ZacCac/MoXY-3D-Printer/Code/images/belt_dimensions.jpg

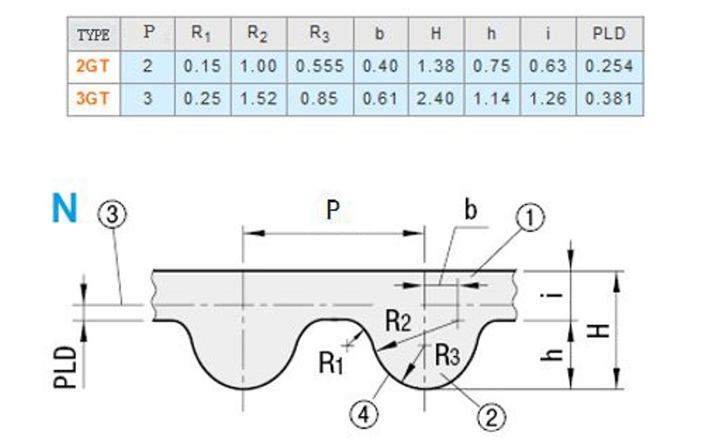
Code/images/belt_dimensions.jpg
