ZacCac/MoXY-3D-Printer/CAD/Components/Printhead/PRT_Main_Plate_V5.SLDPRT

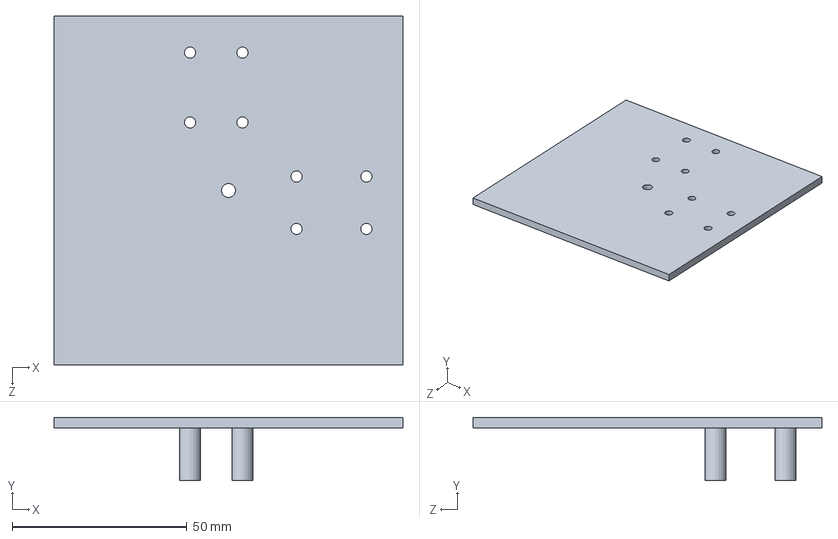
[picture p3: CAD file, 2024-11-04]
CAD/Components/Printhead/PRT_Main_Plate_V5.SLDPRT
100.0 x 18.1 x 100.0 mm
