ZacCac/MoXY-3D-Printer/CAD/Components/Bed/ASM_Bearing_Block_V1.SLDASM

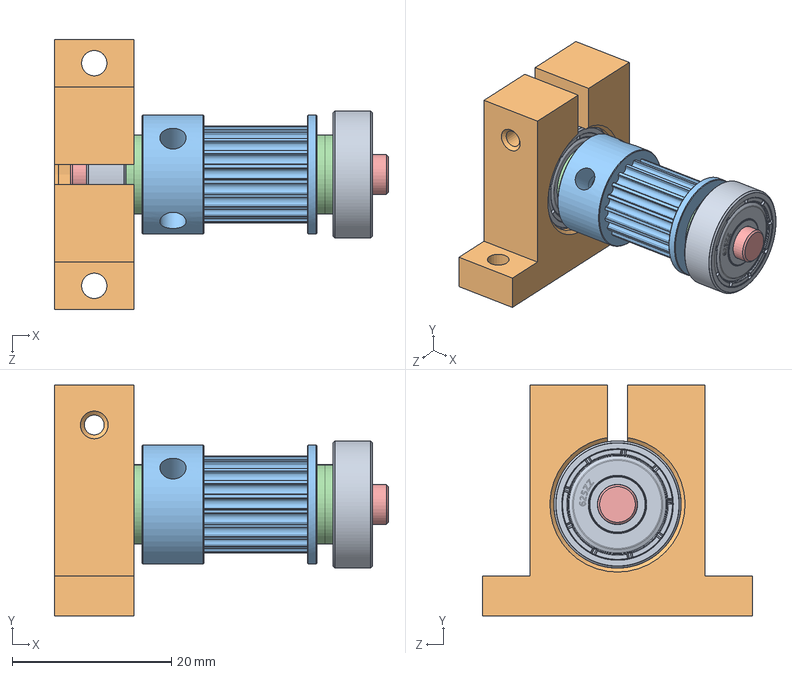
[picture p4: CAD file, 2024-12-02]
CAD/Components/Bed/ASM_Bearing_Block_V1.SLDASM
42.0 x 29.0 x 34.0 mm
PRT_625ZZ_Bearing x 2
PRT_Worm_Bearing_Block_Mirror_V1
PRT_Gates_2GT_20T_Toothed_Pulley_12mm
PRT_M5_1mm_Washer x 4
PRT_5x40mm_Shaft
