ZacCac/MoXY-3D-Printer/CAD/Assemblies/ASM_Gantry_V4.SLDASM

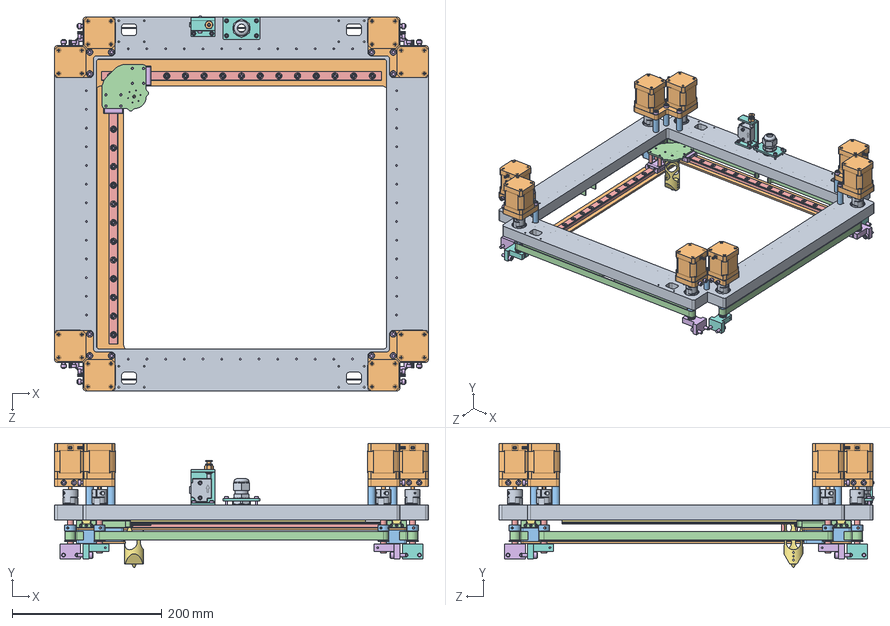
[picture p5: CAD file, 2024-06-27]
CAD/Assemblies/ASM_Gantry_V4.SLDASM
500.3 x 165.9 x 501.5 mm
PRT_Gantry_Main_Plate_V5
PRT_XY_Backer_V2 x 2
PRT_temp_backer_spacer x 4
PRT_MGN12H_Carriage x 4
PRT_MGN12H_Rail_375mm x 2
socket head cap screw_am x 178
PRT_MGN12H_Rail x 4
PRT_PG11_Mount_V1
PRT_PG11_Gland
PRT_NEMA17_17HS19-2004S1 x 8
PRT_Gates_2GT_20T_Toothed_Pulley_12mm_8mm-Bore x 8
PRT_XY_Belt_Path_V1 x 4
PRT_8x65mm_Shaft x 8
PRT_Bearing_Block_Needle_V1 x 4
PRT_5905K73_Needle-Roller Bearing_8mm x 16
PRT_Bearing_Block_Needle_Mirror_V1 x 4
PRT_CPJC20-BL-5-8 x 8
PRT_Motor_Mount_V2 x 4
PRT_M5x25_Standoff_V1 x 12
PRT_Main_Plate_DK_V1
PRT_M3x18_Standoff_V1 x 4
PRT_MGN12C_Carriage x 2
PRT_Chube_Integration
PRT_Filament_Sensor_Plate_V1
PRT_Filament_Sensor_1.75mm
PRT_PC4-M10
PRT_M3_1mm_Washer x 4
