ZacCac/MoXY-3D-Printer/CAD/Assemblies/ASM_Temp_Printhead_V1.SLDASM

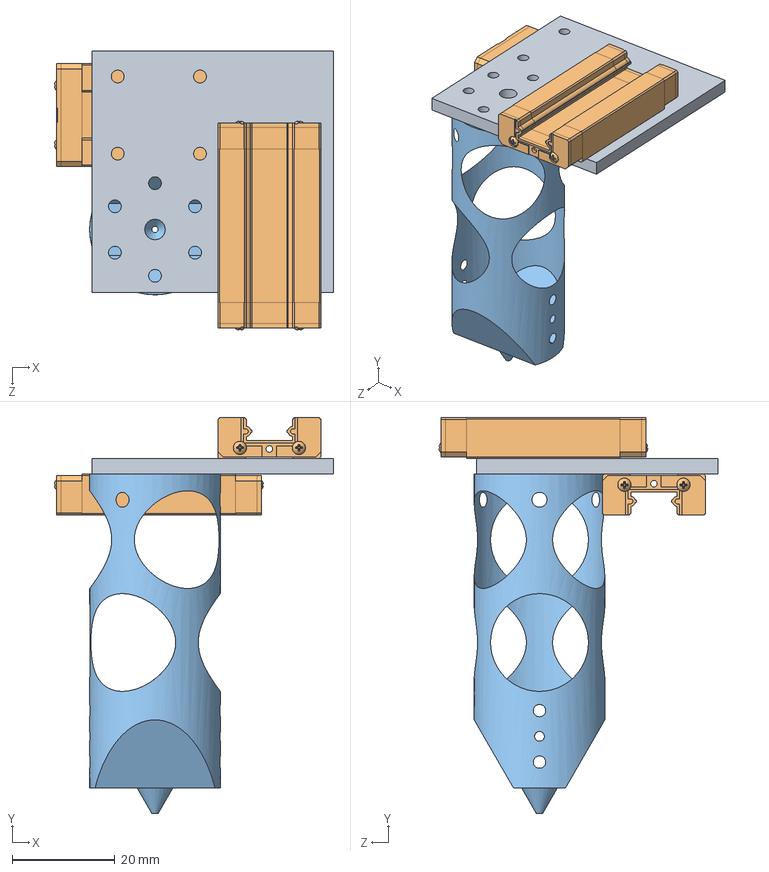
[picture p6: CAD file, 2024-06-27]
CAD/Assemblies/ASM_Temp_Printhead_V1.SLDASM
54.3 x 77.0 x 54.3 mm
PRT_Temp_Printhead_Plate_V1
PRT_MGN9H_Carriage x 2
PRT_Chube_Integration
