ZacCac/MoXY-3D-Printer/CAD/Hardware/Linear Rails/ASM_MGN12H.SLDASM

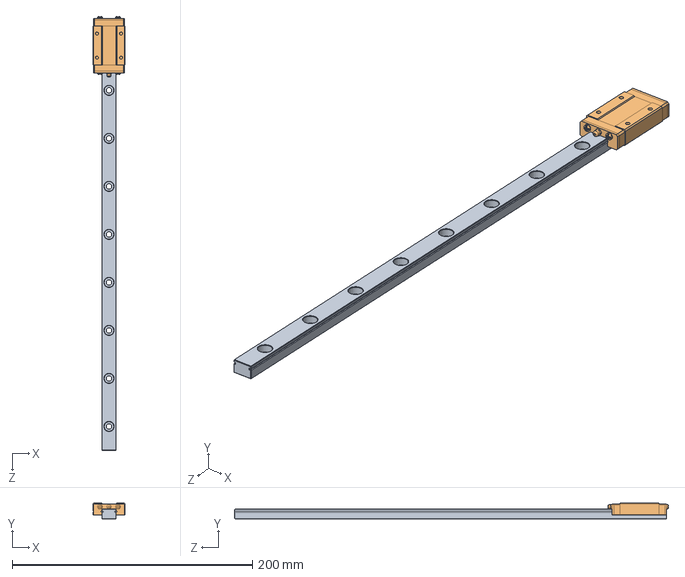
[picture p7: CAD file, 2024-05-26]
CAD/Hardware/Linear Rails/ASM_MGN12H.SLDASM
27.0 x 13.0 x 361.5 mm
PRT_MGN12H_Rail
PRT_MGN12H_Carriage
