ZacCac/MoXY-3D-Printer/CAD/Electronics/Connectors/PRT_Z_Assembly_Aviator_Mount_V1.SLDPRT

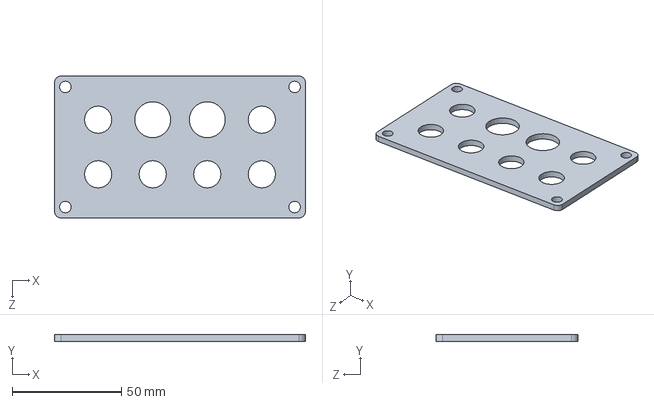
[picture p8: CAD file, 2024-12-02]
CAD/Electronics/Connectors/PRT_Z_Assembly_Aviator_Mount_V1.SLDPRT
115.0 x 3.00 x 65.0 mm
