ZacCac/MoXY-3D-Printer/CAD/Assemblies/ASM_Z_Worm_Drive_Mirror_V1.SLDASM

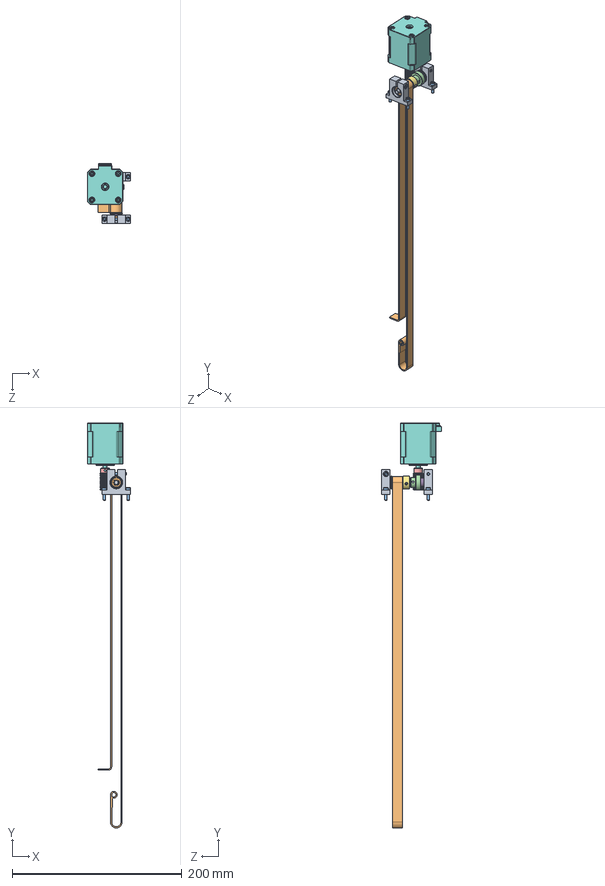
[picture p9: CAD file, 2024-06-21]
CAD/Assemblies/ASM_Z_Worm_Drive_Mirror_V1.SLDASM
51.2 x 476.9 x 70.2 mm
PRT_Worm_Bearing_Block_V1 x 2
PRT_625ZZ_Bearing x 2
socket head cap screw_am x 6
PRT_Kyouiku_Gear_G80A20
PRT_Kyouiku_Gear_W80SUR1
PRT_M5_1mm_Washer x 7
PRT_Gates_2GT_20T_Toothed_Pulley_12mm
PRT_LDO-42STH48-2504AC
PRT_5x60mm_Shaft
PRT_Z_Belt_Path_V2
