ZacCac/MoXY-3D-Printer/CAD/Assemblies/ASM_Z_Worm_Drive_V1.SLDASM

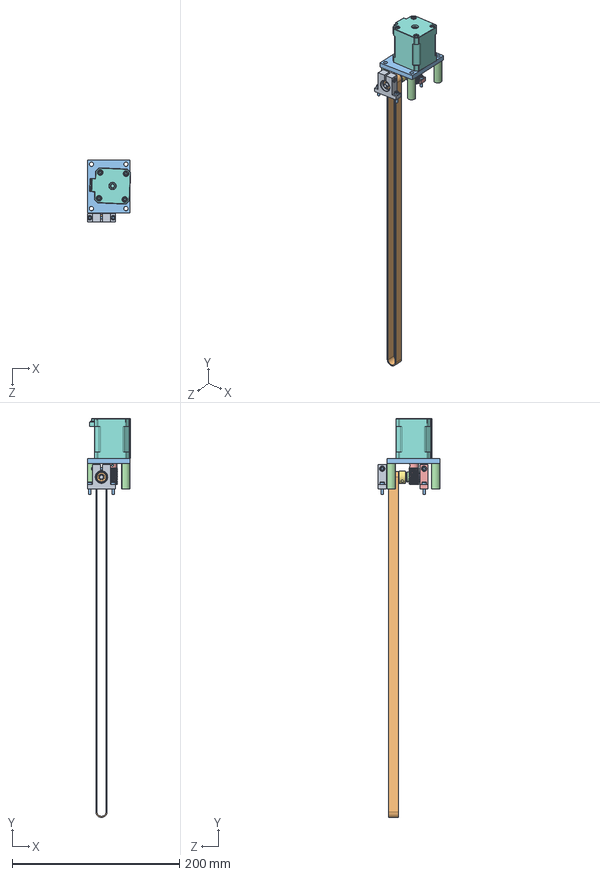
[picture p10: CAD file, 2024-06-21]
CAD/Assemblies/ASM_Z_Worm_Drive_V1.SLDASM
51.9 x 476.7 x 74.0 mm
PRT_Worm_Bearing_Block_V1
PRT_625ZZ_Bearing x 2
socket head cap screw_am x 6
PRT_Kyouiku_Gear_G80A20
PRT_Kyouiku_Gear_W80SUR1
PRT_M5_1mm_Washer x 7
PRT_Gates_2GT_20T_Toothed_Pulley_12mm
PRT_LDO-42STH48-2504AC
PRT_5x60mm_Shaft
PRT_Z_Belt_Path_V1
PRT_Z_Stepper_Plate_V1
PRT_Temp_Z_Spacer x 4
PRT_Worm_Bearing_Block_Mirror_V1
