ZacCac/MoXY-3D-Printer/CAD/Assemblies/ASM_Z_V1.SLDASM

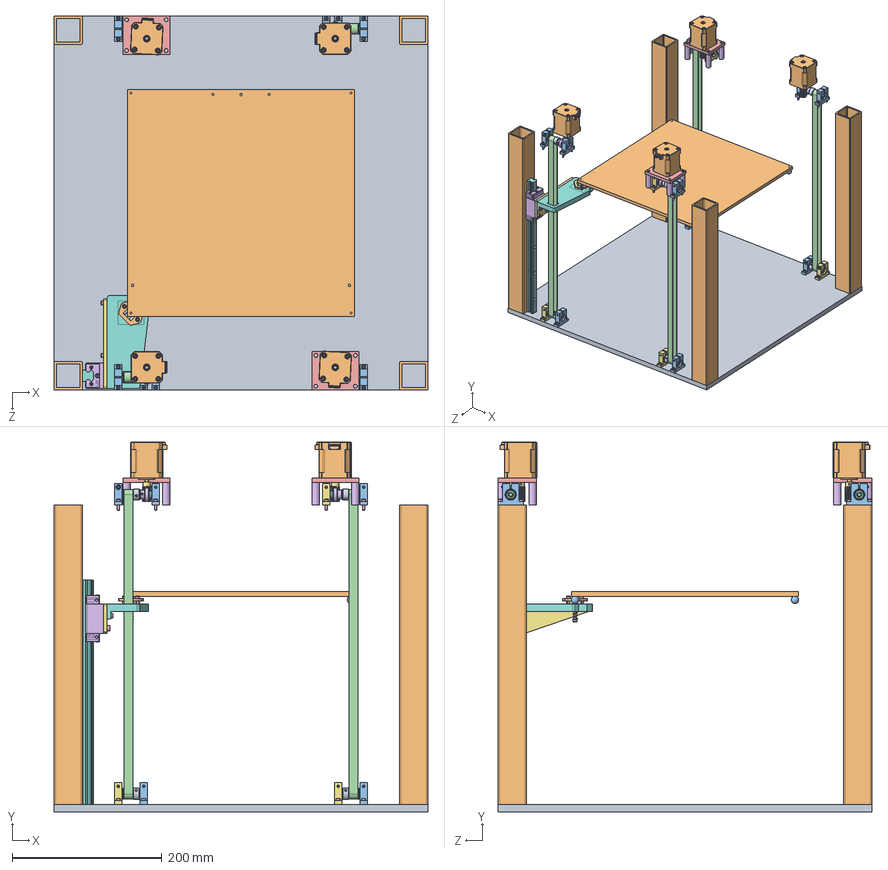
[picture p11: CAD file, 2024-06-03]
CAD/Assemblies/ASM_Z_V1.SLDASM
500.0 x 494.0 x 500.0 mm
PRT_Z_Frame_V1
PRT_6527K373_Low-Carbon Steel Rectangular Tube x 4
PRT_Worm_Bearing_Block_V1 x 10
PRT_625ZZ_Bearing x 16
socket head cap screw_am x 59
PRT_Kyouiku_Gear_G80A20 x 4
PRT_Kyouiku_Gear_W80SUR1 x 4
PRT_M5_1mm_Washer x 44
PRT_Gates_2GT_20T_Toothed_Pulley_12mm x 8
PRT_LDO-42STH48-2504AC x 4
PRT_5x60mm_Shaft x 4
PRT_Z_Belt_Path_V1 x 4
PRT_Z_Stepper_Plate_V1 x 2
PRT_Temp_Z_Spacer x 8
PRT_Worm_Bearing_Block_Mirror_V1 x 6
PRT_HGR15
PRT_5x40mm_Shaft x 4
PRT_MIC6_Bed_300_V1
PRT_1598K32_Hardened Bearing_440C_V1 x 4
PRT_SWM6-15_Bed_Spring
PRT_93475A210_18-8_Washer x 2
PRT_HGH15CC
PRT_Kinematic_Support_V1
PRT_Kinematic_Plate_Bottom_V1
PRT_5x15mm_Shaft x 2
PRT_Kinematic_Plate_Top_V1
