ZacCac/MoXY-3D-Printer/CAD/Assemblies/ASM_Motor_Transmission_V1.SLDASM

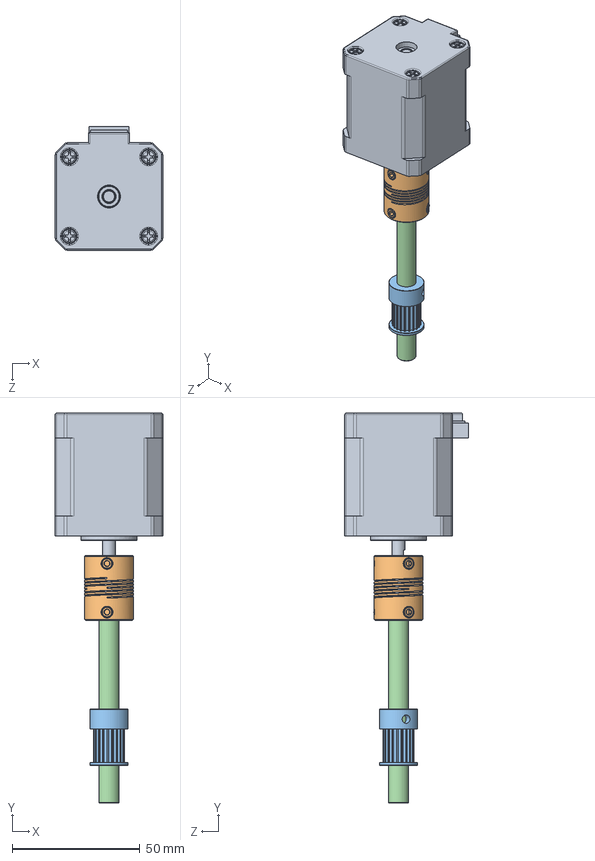
[picture p12: CAD file, 2024-05-26]
CAD/Assemblies/ASM_Motor_Transmission_V1.SLDASM
42.0 x 152.4 x 48.2 mm
PRT_LDO-42STH48-2504AC
PRT_4147N168_Set Screw Precision Flexible Shaft Couplings_8-5mm
PRT_Gates_2GT_20T_Toothed_Pulley_12mm_8mm-Bore
PRT_8x80mm_Shaft
