ZacCac/MoXY-3D-Printer/CAD/Assemblies/ASM_Frame_V1.SLDASM

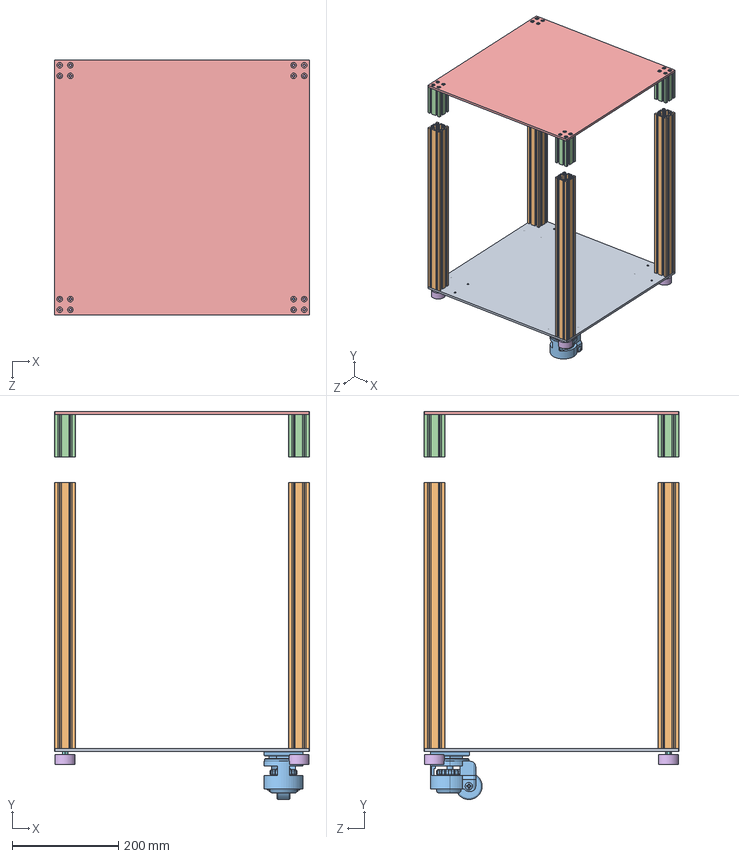
[picture p13: CAD file, 2024-05-26]
CAD/Assemblies/ASM_Frame_V1.SLDASM
480.0 x 730.0 x 480.0 mm
PRT_Base_Plate_V1
PRT_HFS5-4040-500-TPW-SC x 4
PRT_HFS5-4040-80-TPW x 4
PRT_Top_Plate_V1
PRT_Rubber_Feet x 4
socket head cap screw_am x 4
hex nut style 1_am x 4
