ZacCac/MoXY-3D-Printer/CAD/Components/Gantry/PRT_Gantry_Main_Plate_V8.SLDPRT

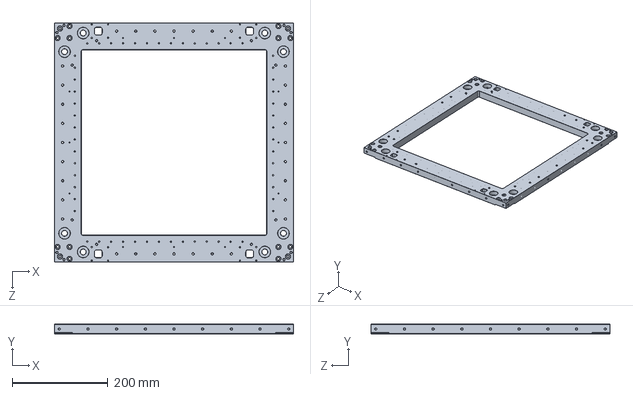
[picture p14: CAD file, 2024-09-25]
CAD/Components/Gantry/PRT_Gantry_Main_Plate_V8.SLDPRT
500.0 x 20.0 x 500.0 mm
