ZacCac/MoXY-3D-Printer/CAD/Assemblies/ASM_Feet_V1.SLDASM

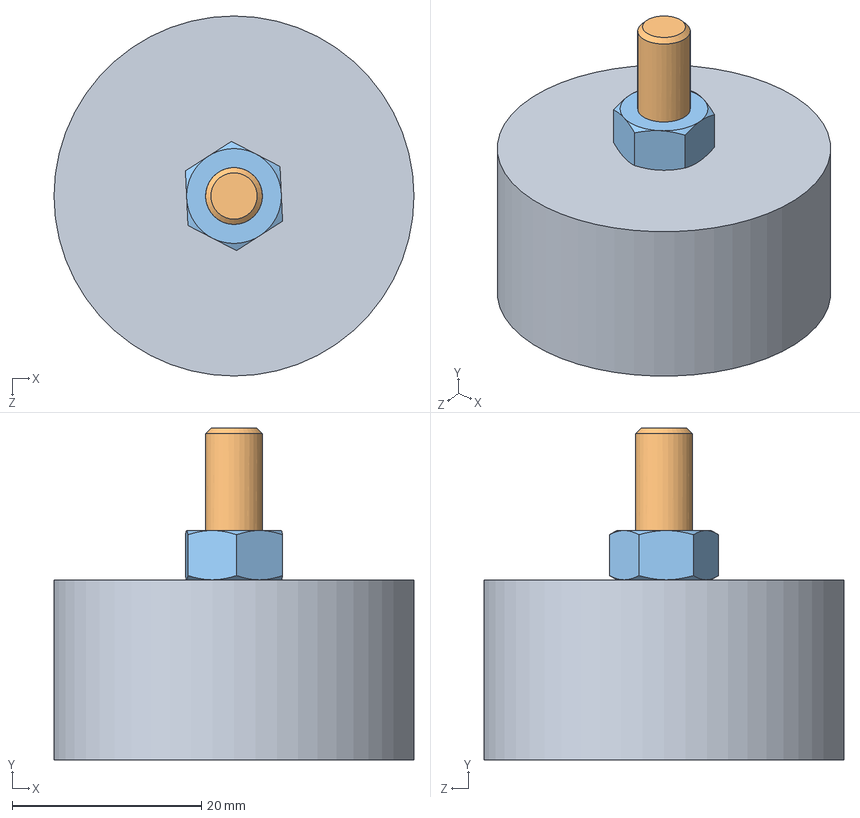
[picture p15: CAD file, 2024-05-26]
CAD/Assemblies/ASM_Feet_V1.SLDASM
38.0 x 35.0 x 38.0 mm
PRT_Rubber_Feet
socket head cap screw_am
hex nut style 1_am
