ZacCac/MoXY-3D-Printer/CAD/Assemblies/ASM_Printer_V1.SLDASM

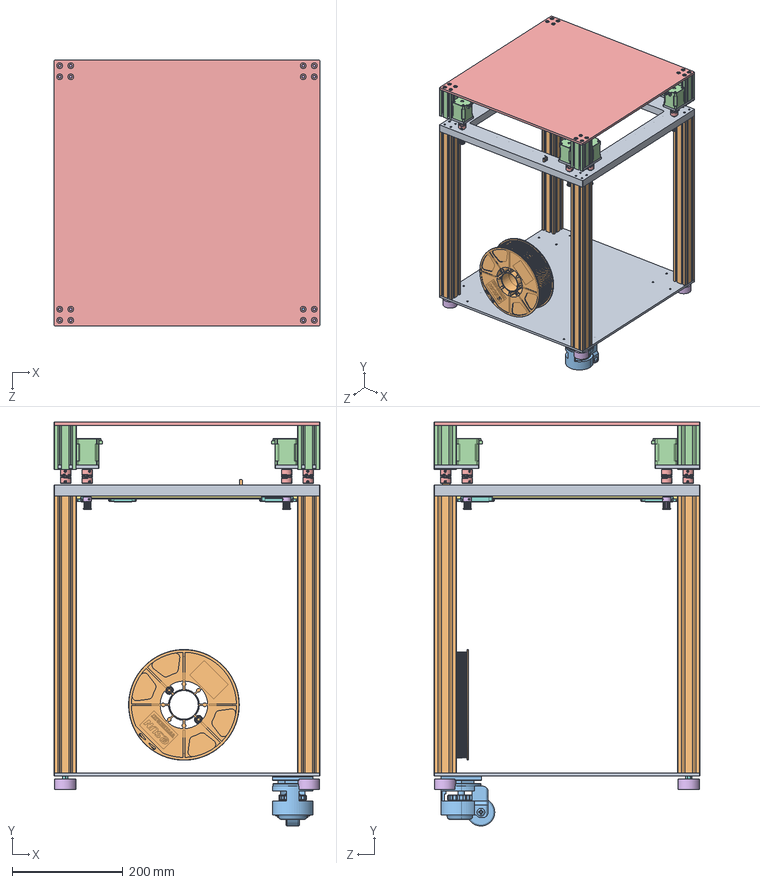
[picture p16: CAD file, 2024-05-26]
CAD/Assemblies/ASM_Printer_V1.SLDASM
480.0 x 730.0 x 480.0 mm
PRT_Base_Plate_V1
PRT_HFS5-4040-500-TPW-SC x 4
PRT_HFS5-4040-80-TPW x 4
PRT_Top_Plate_V1
PRT_Rubber_Feet x 4
socket head cap screw_am x 4
hex nut style 1_am x 4
PRT_Gantry_Main_Plate_V1
EE_SX3081
PRT_5905K73_Needle-Roller Bearing_8mm x 8
PRT_LDO-42STH48-2504AC x 8
PRT_4147N168_Set Screw Precision Flexible Shaft Couplings_8-5mm x 8
PRT_Gates_2GT_20T_Toothed_Pulley_12mm_8mm-Bore x 8
PRT_MGN12H_Rail x 4
PRT_MGN12H_Carriage x 4
PRT_Motor_Mount_V1 x 4
eSun_spool v6
