ZacCac/MoXY-3D-Printer/CAD/Components/Gantry/ASM_Bearing_Block_8mm_V1.SLDASM

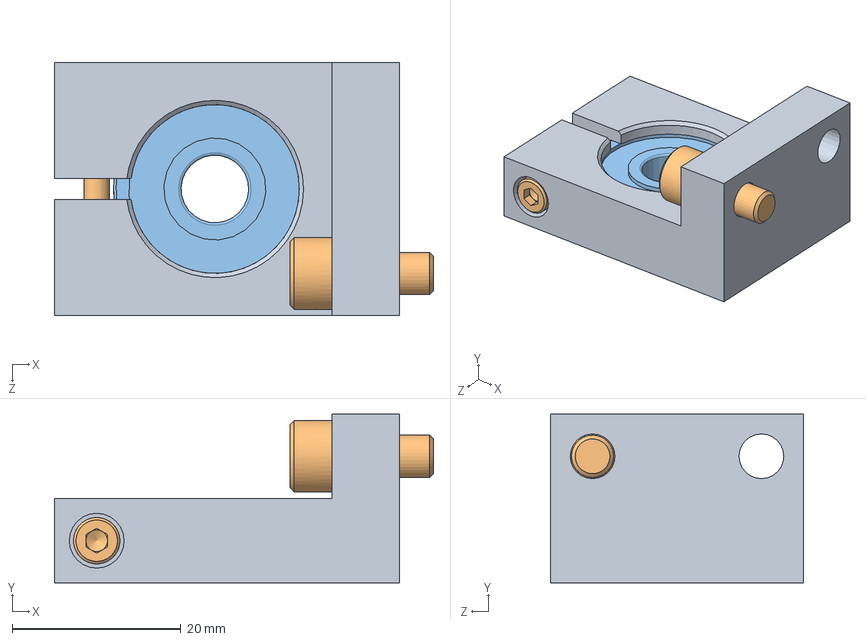
[picture p17: CAD file, 2024-06-27]
CAD/Components/Gantry/ASM_Bearing_Block_8mm_V1.SLDASM
44.9 x 20.0 x 30.0 mm
PRT_Bearing_Block_8mm_V1
socket head cap screw_am x 2
PRT_SB628ZZ_Bearing
