ZacCac/MoXY-3D-Printer/CAD/Components/Bed/PRT_Z_Main_Kinematic_Plate_V1.SLDPRT

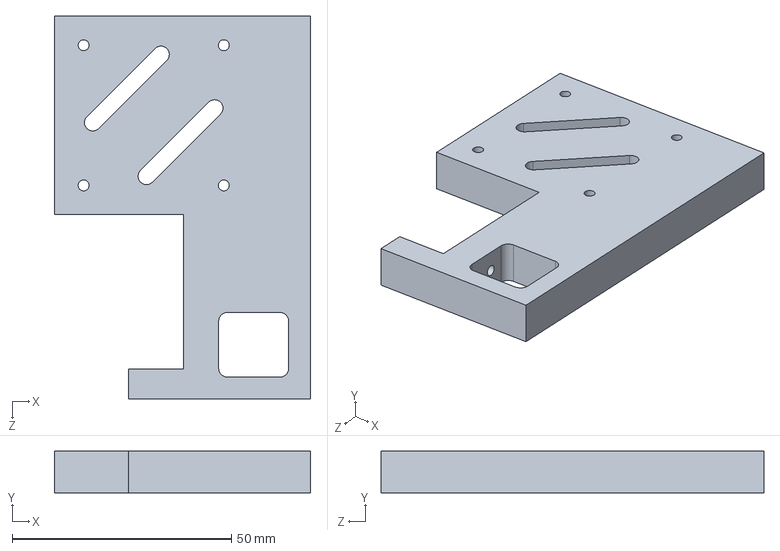
[picture p18: CAD file, 2024-09-10]
CAD/Components/Bed/PRT_Z_Main_Kinematic_Plate_V1.SLDPRT
58.5 x 9.53 x 87.4 mm
