ZacCac/MoXY-3D-Printer/CAD/Components/Bed/ASM_Z_Drive_V1.SLDASM

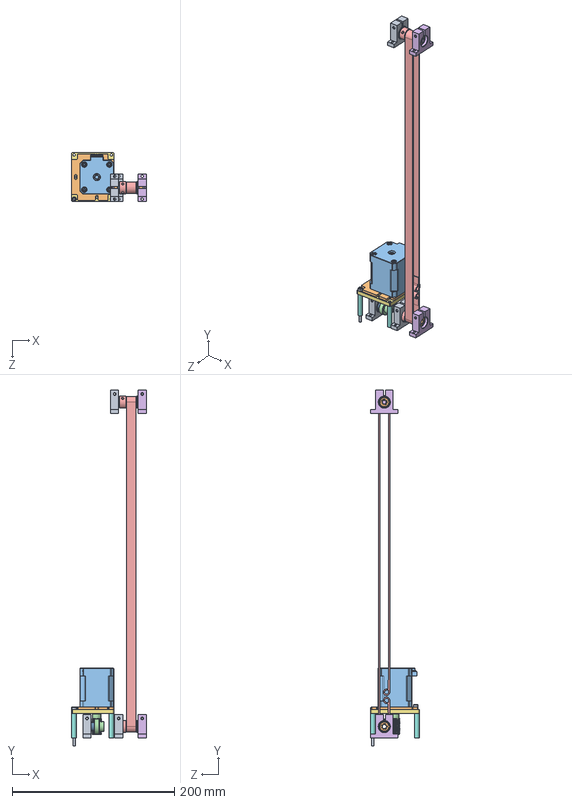
[picture p19: CAD file, 2024-07-18]
CAD/Components/Bed/ASM_Z_Drive_V1.SLDASM
92.0 x 439.0 x 60.4 mm
PRT_Worm_Bearing_Block_Mirror_V1 x 3
PRT_625ZZ_Bearing x 5
PRT_M5_1mm_Washer x 13
PRT_Kyouiku_Gear_G80A20
PRT_Gates_2GT_20T_Toothed_Pulley_12mm x 2
PRT_Worm_Bearing_Block_V1 x 2
PRT_Z_Stepper_Plate_V2
PRT_M3x30_Spacer_V1 x 4
socket head cap screw_am x 2
PRT_Z_Stepper_Plate_Mount_V1
PRT_LDO-42STH48-2504AC
PRT_Kyouiku_Gear_W80SUR1
PRT_Z_Belt_Path_V2
PRT_5x40mm_Shaft
