ZacCac/MoXY-3D-Printer/CAD/Components/Bed/ASM_Kinematic-3_V2.SLDASM

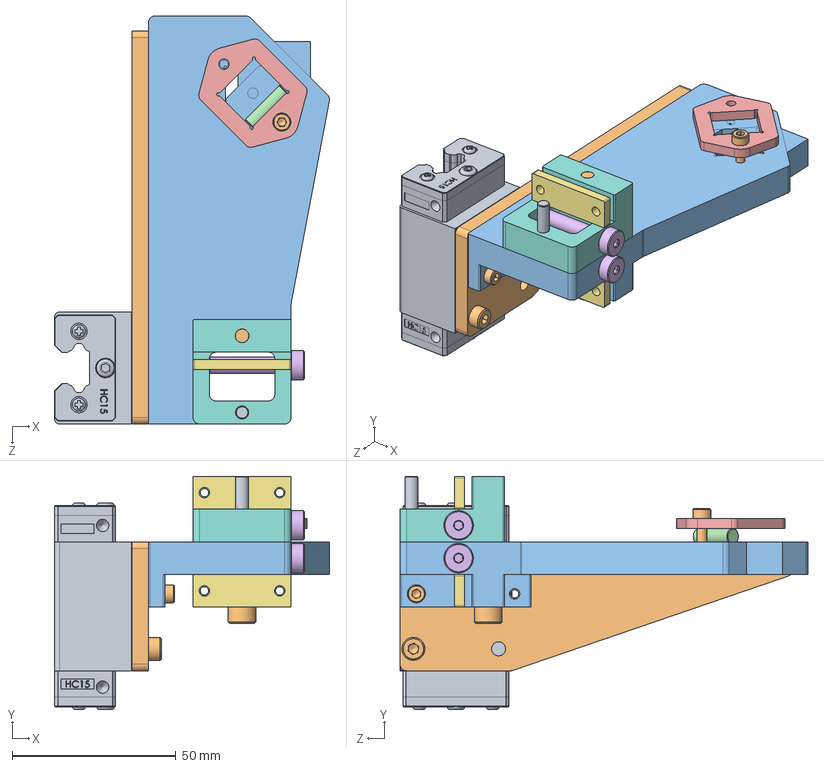
[picture p21: CAD file, 2024-07-14]
CAD/Components/Bed/ASM_Kinematic-3_V2.SLDASM
84.0 x 71.3 x 124.6 mm
PRT_HGH15CC
PRT_Kinematic_Support_V1
PRT_Kinematic_Plate_Bottom_V2
PRT_5x15mm_Shaft
PRT_Kinematic_Plate_Top_V1
PRT_90269A134_316 Stainless Steel Shoulder Screw x 2
PRT_Z_Belt_Clamp_V1 x 2
PRT_Z_Belt_Mount_Top_V2
PRT_4x30mm_Shaft
socket head cap screw_am x 5
