ZacCac/MoXY-3D-Printer/CAD/Components/Accessories/PRT_CPAP_Mount_V1.SLDPRT

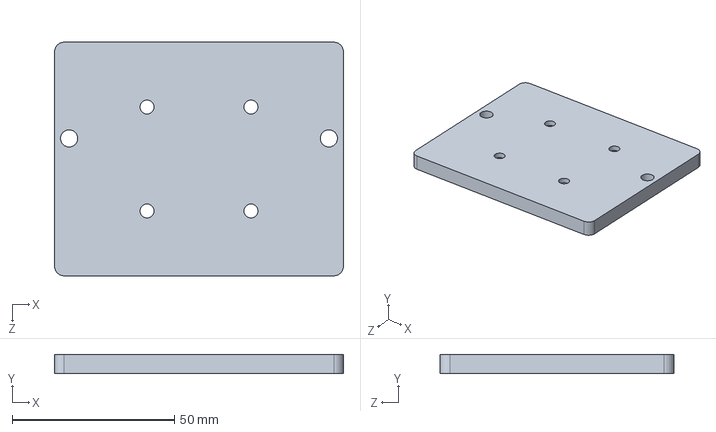
[picture p22: CAD file, 2024-12-02]
CAD/Components/Accessories/PRT_CPAP_Mount_V1.SLDPRT
89.0 x 6.00 x 72.0 mm
