ZacCac/MoXY-3D-Printer/CAD/Components/Frame/PRT_Top_Plate_V1.SLDPRT

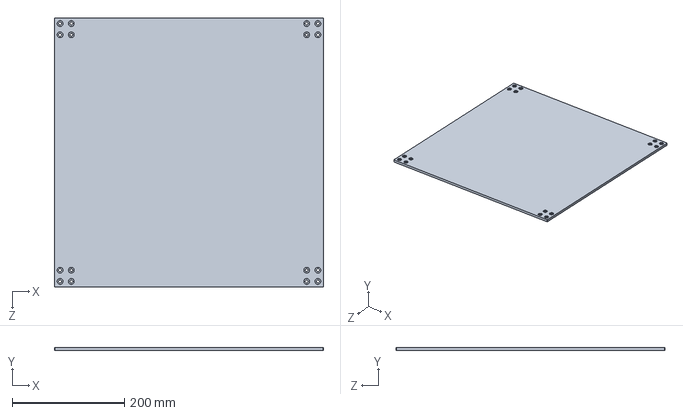
[picture p23: CAD file, 2024-05-26]
CAD/Components/Frame/PRT_Top_Plate_V1.SLDPRT
480.0 x 6.00 x 480.0 mm
