ZacCac/MoXY-3D-Printer/CAD/Components/Panels/PRT_Side_Panel_V2.SLDPRT

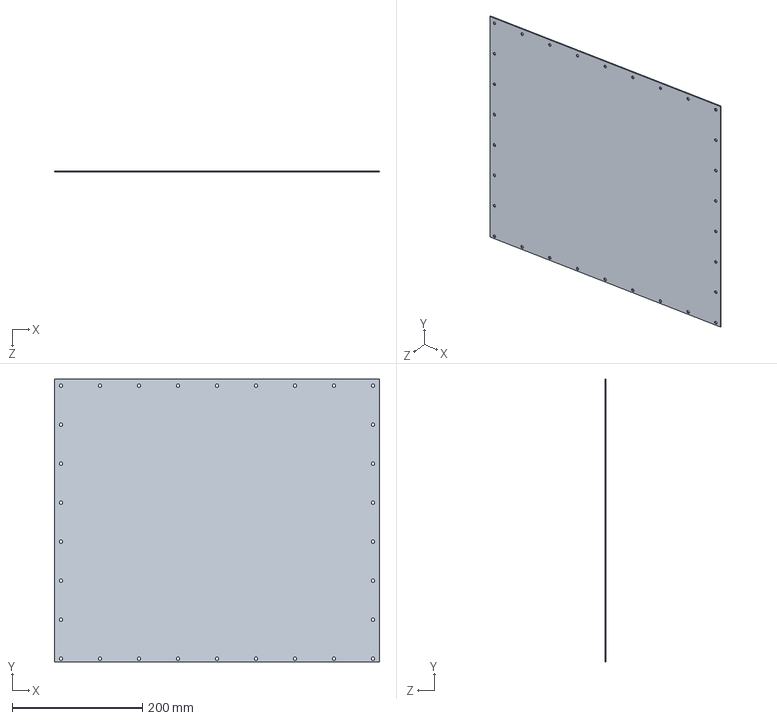
[picture p24: CAD file, 2024-09-27]
CAD/Components/Panels/PRT_Side_Panel_V2.SLDPRT
500.0 x 435.0 x 2.00 mm
