ZacCac/MoXY-3D-Printer/CAD/Components/Printhead/DK Printhead/PRT_Goliath_Air.SLDPRT

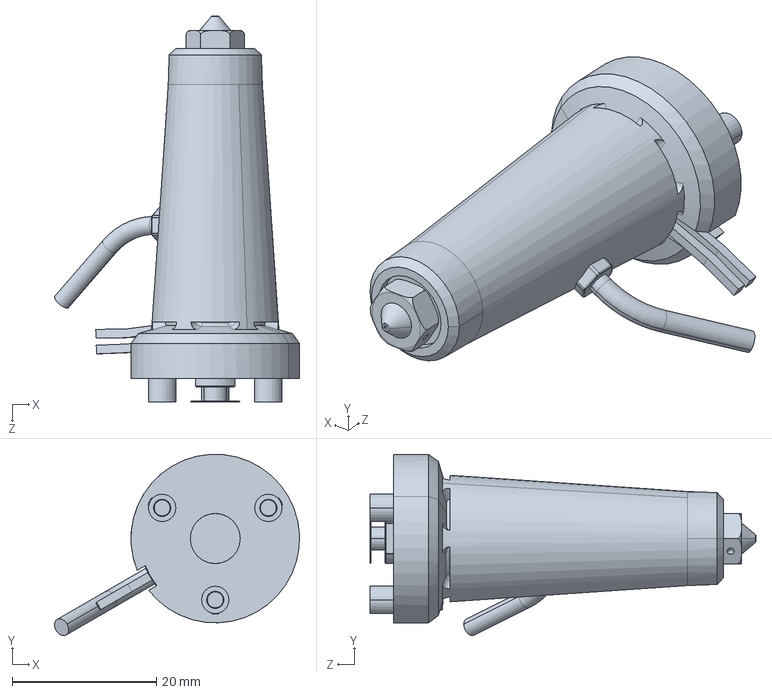
[picture p25: CAD file, 2024-07-03]
CAD/Components/Printhead/DK Printhead/PRT_Goliath_Air.SLDPRT
34.0 x 25.1 x 53.5 mm
