ZacCac/MoXY-3D-Printer/CAD/Components/Printhead/PRT_Chube_Integration_V2.SLDPRT

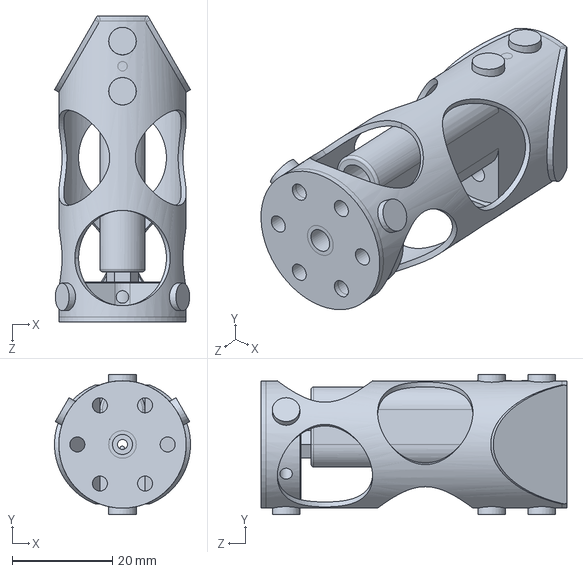
[picture p26: CAD file, 2024-11-04]
CAD/Components/Printhead/PRT_Chube_Integration_V2.SLDPRT
27.1 x 27.9 x 61.0 mm
