ZacCac/MoXY-3D-Printer/CAD/Components/Printhead/temp/PRT_Ducts_V1.SLDPRT

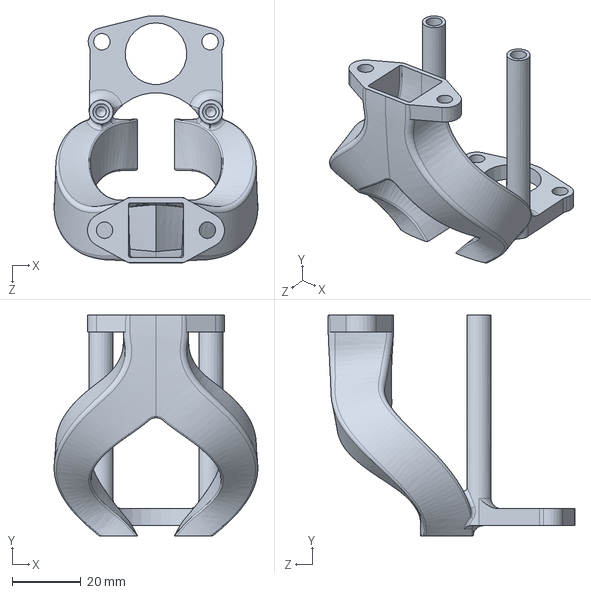
[picture p27: CAD file, 2025-02-01]
CAD/Components/Printhead/temp/PRT_Ducts_V1.SLDPRT
59.5 x 64.5 x 72.0 mm
