ZacCac/MoXY-3D-Printer/CAD/Drawings/Waterjet Parts 2/DXF_Tensioner_Spacer_V1.DXF

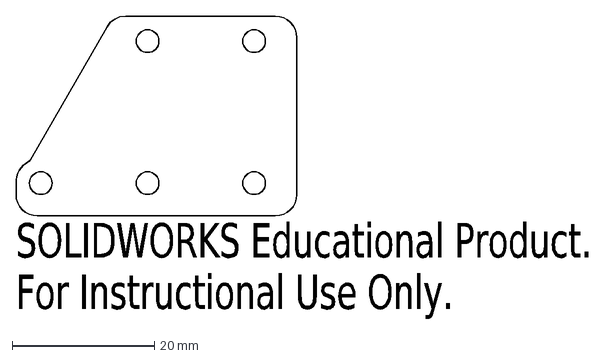
[picture p28: CAD file, 2024-11-19]
CAD/Drawings/Waterjet Parts 2/DXF_Tensioner_Spacer_V1.DXF
SOLIDWORKS Educational Product.
For Instructional Use Only.
