ZacCac/MoXY-3D-Printer/CAD/Drawings/Waterjet Parts 3/DXF_Z_Tensioner_V1.DXF

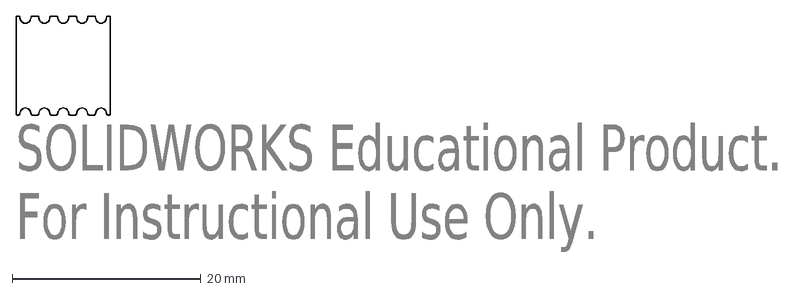
[picture p29: CAD file, 2024-11-14]
CAD/Drawings/Waterjet Parts 3/DXF_Z_Tensioner_V1.DXF
SOLIDWORKS Educational Product.
For Instructional Use Only.
