ZacCac/MoXY-3D-Printer/CAD/Drawings/Waterjet Parts 4/DXF_XY_Backer_V5.DXF

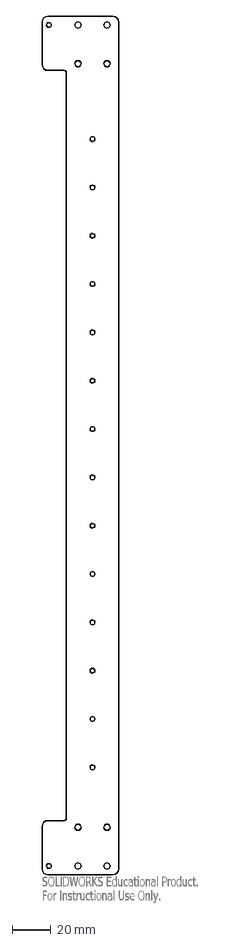
[picture p30: CAD file, 2024-12-02]
CAD/Drawings/Waterjet Parts 4/DXF_XY_Backer_V5.DXF
SOLIDWORKS Educational Product.
For Instructional Use Only.
