ZacCac/MoXY-3D-Printer/CAD/Drawings/Waterjet Parts 5/DXF_Static_Toothed_Clamp_V2.DXF

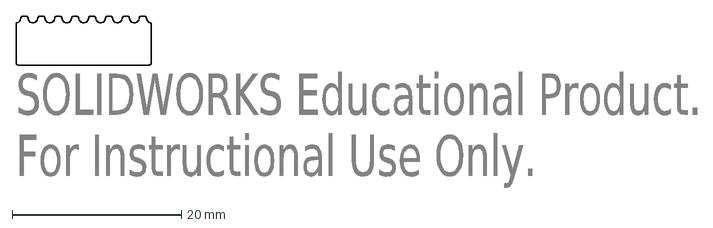
[picture p31: CAD file, 2024-12-06]
CAD/Drawings/Waterjet Parts 5/DXF_Static_Toothed_Clamp_V2.DXF
SOLIDWORKS Educational Product.
For Instructional Use Only.
