ZacCac/MoXY-3D-Printer/CAD/Electronics/Connectors/PRT_Back_Wiring_Panel_V1.SLDPRT

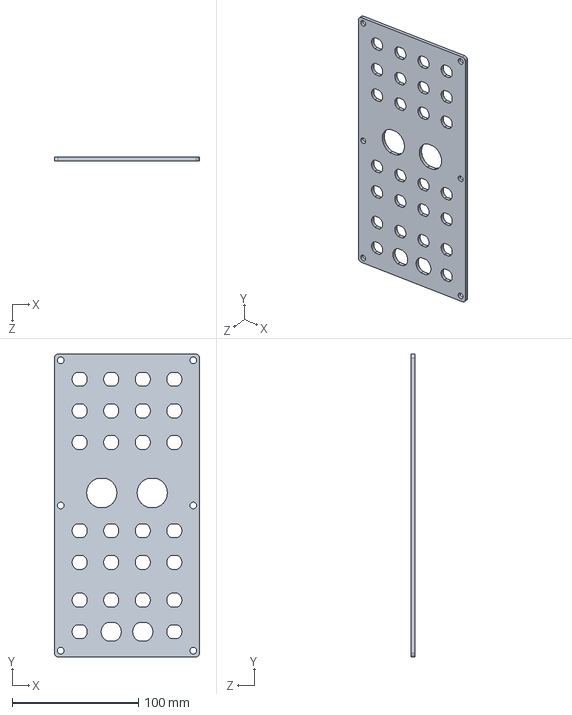
[picture p33: CAD file, 2024-12-06]
CAD/Electronics/Connectors/PRT_Back_Wiring_Panel_V1.SLDPRT
115.0 x 240.0 x 3.00 mm
