ZacCac/MoXY-3D-Printer/CAD/Electronics/Endstops and Probes/EE_SX3081.SLDPRT

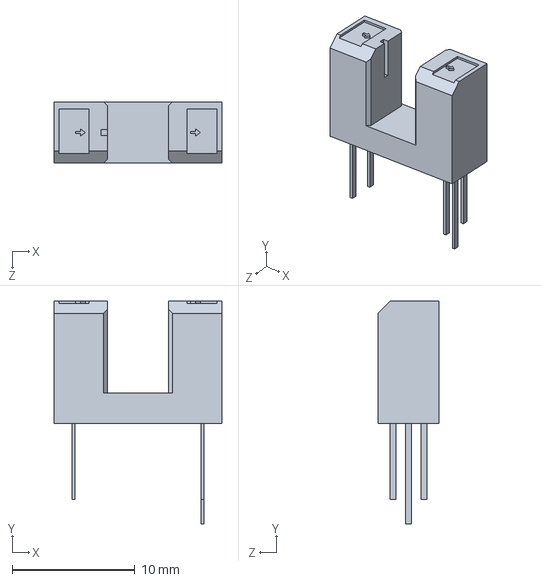
[picture p34: CAD file, 2024-05-26]
CAD/Electronics/Endstops and Probes/EE_SX3081.SLDPRT
13.7 x 18.2 x 5.00 mm
