ZacCac/MoXY-3D-Printer/CAD/Electronics/Misc/PRT_Cable_Clamp_x2_V1.SLDPRT

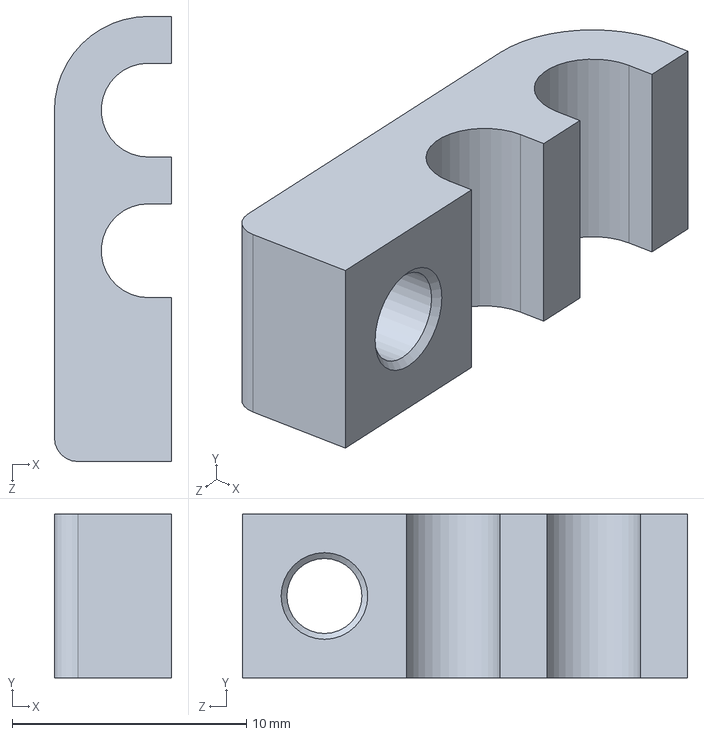
[picture p35: CAD file, 2024-12-02]
CAD/Electronics/Misc/PRT_Cable_Clamp_x2_V1.SLDPRT
5.00 x 7.00 x 19.0 mm
