ZacCac/MoXY-3D-Printer/CAD/eSun_spool v6.SLDPRT

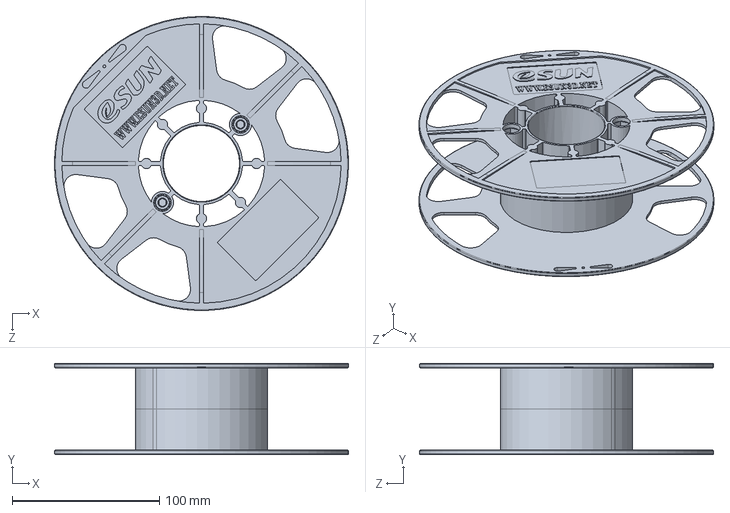
[picture p36: CAD file, 2024-07-01]
CAD/eSun_spool v6.SLDPRT
200.0 x 62.0 x 200.0 mm
