ZacCac/MoXY-3D-Printer/CAD/Hardware/Bearings/PRT_625ZZ_Bearing.SLDPRT

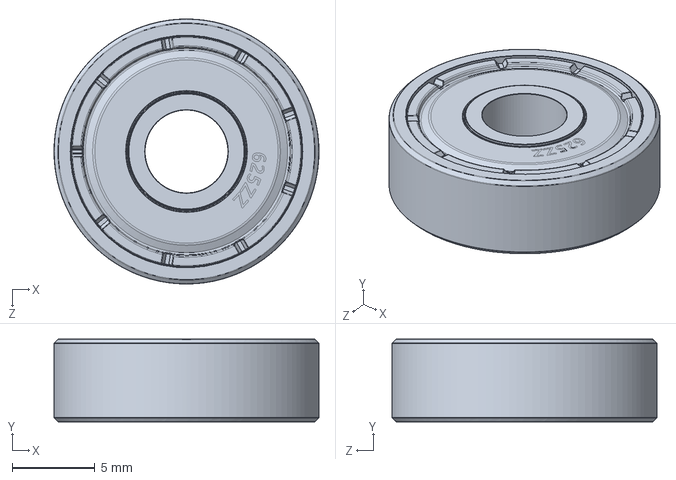
[picture p37: CAD file, 2024-07-01]
CAD/Hardware/Bearings/PRT_625ZZ_Bearing.SLDPRT
16.0 x 5.00 x 16.0 mm
