ZacCac/MoXY-3D-Printer/CAD/Hardware/Couplers/PRT_CPJC20-BL-5-8.SLDPRT

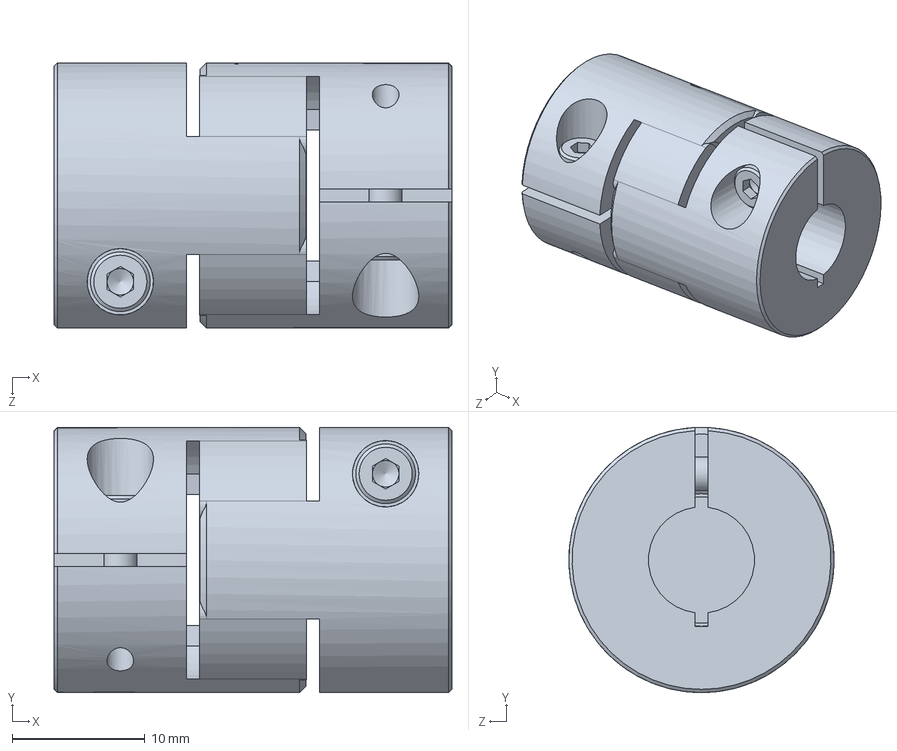
[picture p38: CAD file, 2024-07-01]
CAD/Hardware/Couplers/PRT_CPJC20-BL-5-8.SLDPRT
30.0 x 20.0 x 20.0 mm
