ZacCac/MoXY-3D-Printer/CAD/Hardware/Extrusions/PRT_HFS5-4040-500-TPW-SC.sldprt

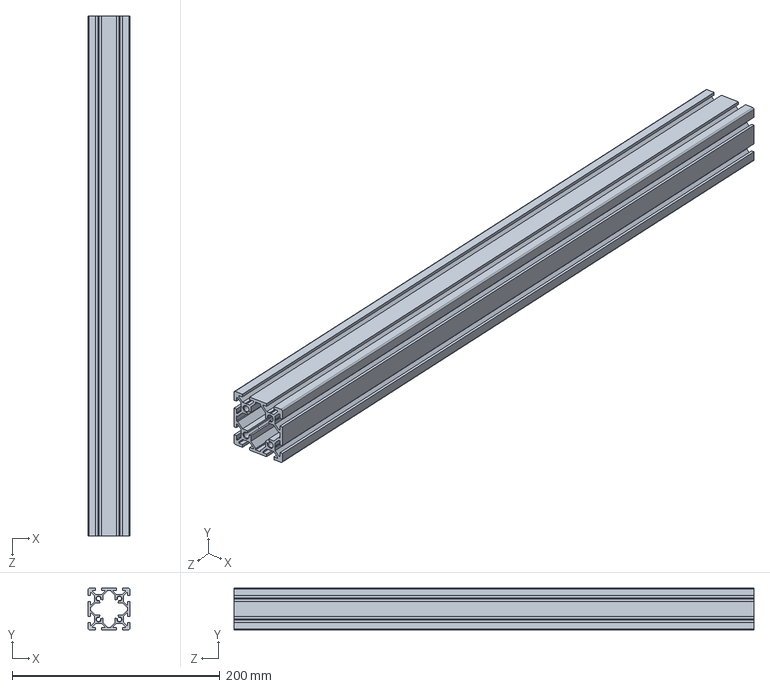
[picture p39: CAD file, 2024-05-26]
CAD/Hardware/Extrusions/PRT_HFS5-4040-500-TPW-SC.sldprt
40.0 x 40.0 x 500.0 mm
