ZacCac/MoXY-3D-Printer/CAD/Hardware/Gears/PRT_Kyouiku_Gear_W80SUR1.SLDPRT

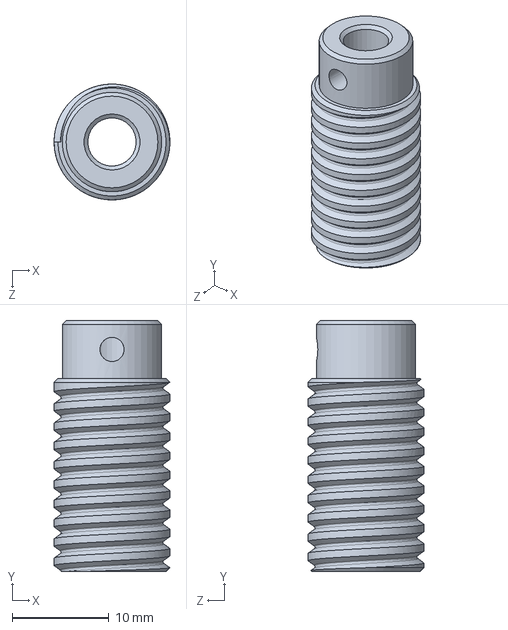
[picture p40: CAD file, 2024-07-01]
CAD/Hardware/Gears/PRT_Kyouiku_Gear_W80SUR1.SLDPRT
12.0 x 26.0 x 12.0 mm
