ZacCac/MoXY-3D-Printer/CAD/Hardware/Linear Rails/PRT_MGN12H_Rail.SLDPRT

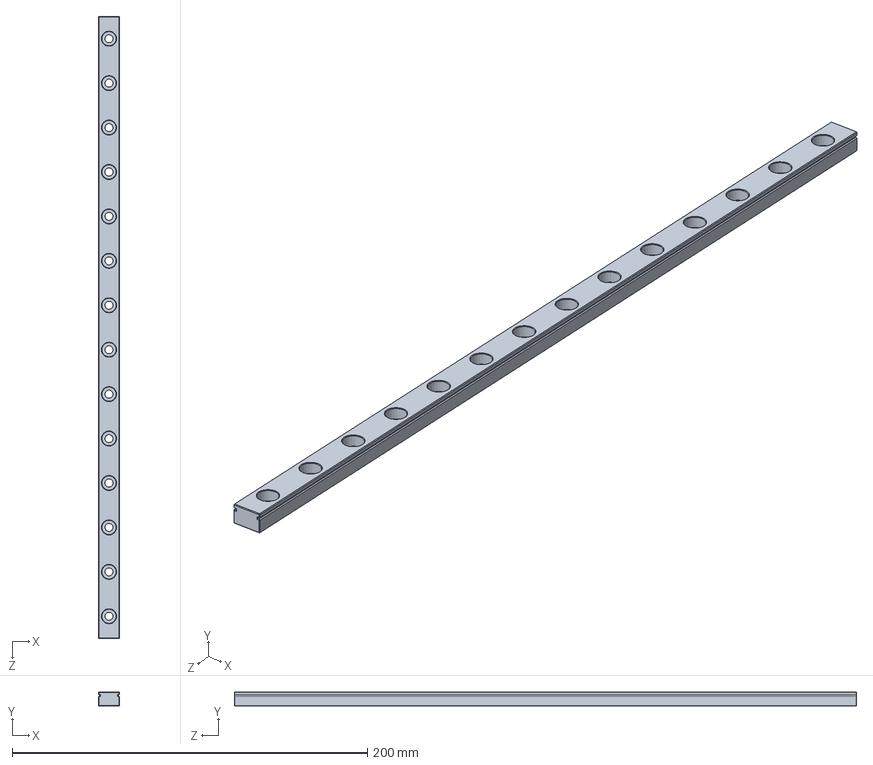
[picture p41: CAD file, 2024-09-23]
CAD/Hardware/Linear Rails/PRT_MGN12H_Rail.SLDPRT
12.0 x 8.00 x 350.0 mm
