ZacCac/MoXY-3D-Printer/CAD/Hardware/Misc/PRT_D2F-L_Left_Angled.SLDPRT

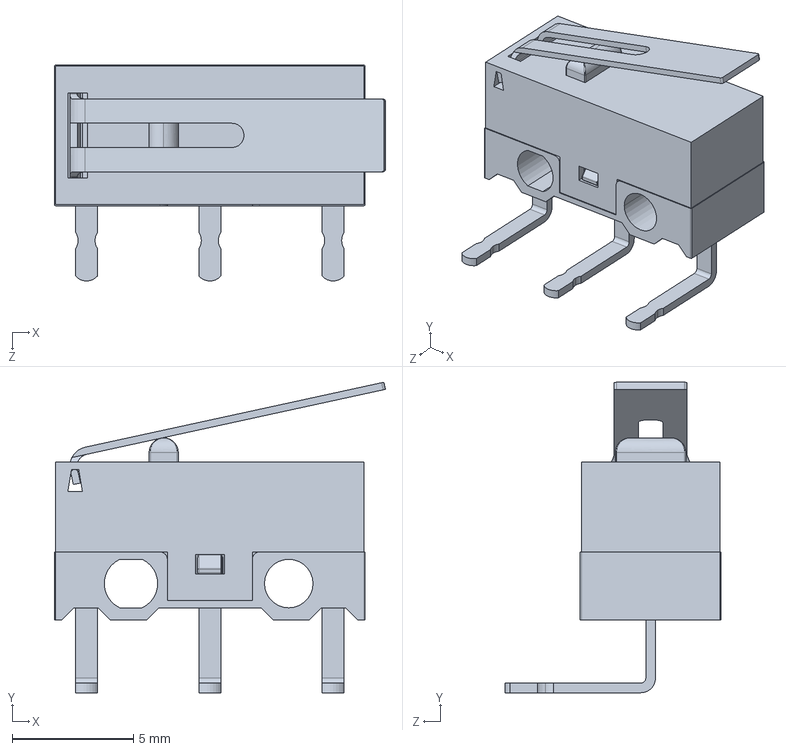
[picture p42: CAD file, 2024-07-29]
CAD/Hardware/Misc/PRT_D2F-L_Left_Angled.SLDPRT
13.6 x 12.8 x 8.90 mm
