ZacCac/MoXY-3D-Printer/CAD/Hardware/Motors/PRT_NEMA17_17HS19-2004S1.SLDPRT

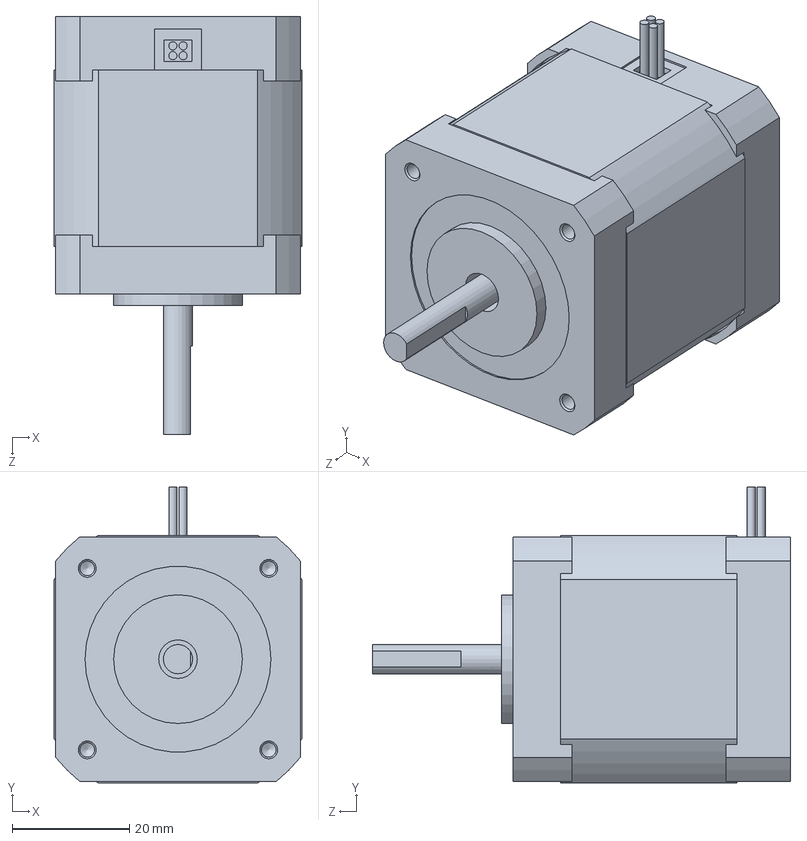
[picture p43: CAD file, 2024-12-02]
CAD/Hardware/Motors/PRT_NEMA17_17HS19-2004S1.SLDPRT
42.3 x 50.5 x 71.4 mm
