ZacCac/MoXY-3D-Printer/CAD/Hardware/Pulleys/PRT_Gates_2GT_20T_Toothed_Pulley_12mm_8mm-Bore.SLDPRT

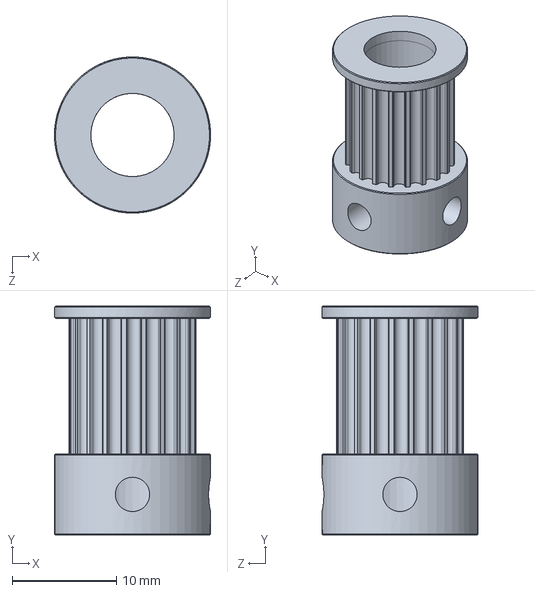
[picture p44: CAD file, 2024-09-10]
CAD/Hardware/Pulleys/PRT_Gates_2GT_20T_Toothed_Pulley_12mm_8mm-Bore.SLDPRT
15.0 x 22.0 x 15.0 mm
