ZacCac/MoXY-3D-Printer/CAD/Hardware/Shafts/PRT_4x32mm_Shaft.SLDPRT

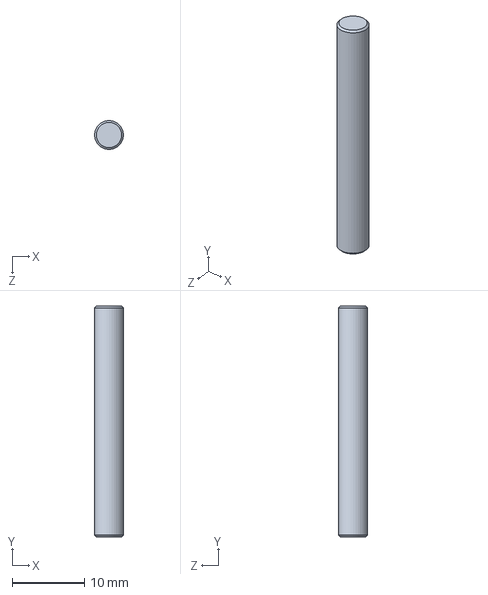
[picture p45: CAD file, 2024-11-04]
CAD/Hardware/Shafts/PRT_4x32mm_Shaft.SLDPRT
4.00 x 32.0 x 4.00 mm
