ZacCac/MoXY-3D-Printer/CAD/Hardware/Springs/PRT_SWM6-15_Bed_Spring.SLDPRT

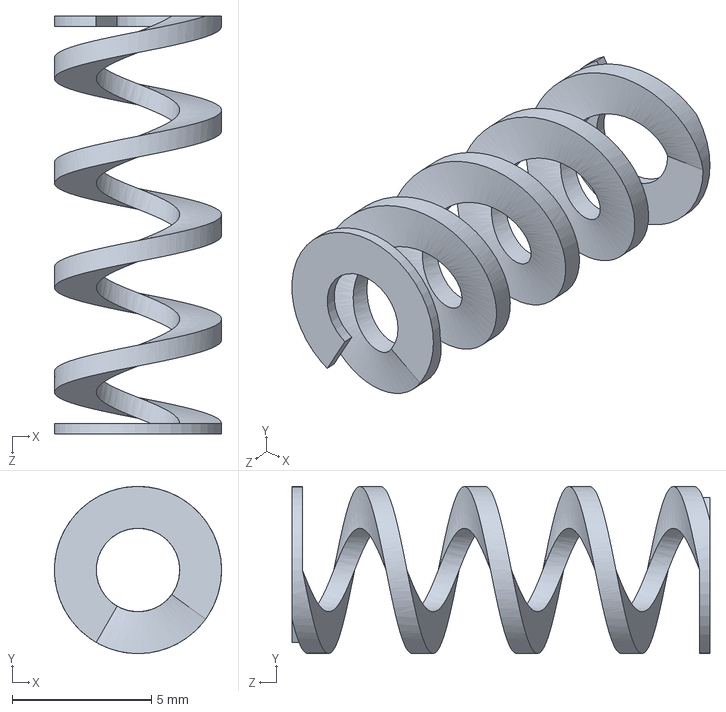
[picture p46: CAD file, 2024-07-01]
CAD/Hardware/Springs/PRT_SWM6-15_Bed_Spring.SLDPRT
6.00 x 6.00 x 15.0 mm
