ZacCac/MoXY-3D-Printer/CAD/Components/Bed/PRT_Z_Tensioner_V2.SLDPRT

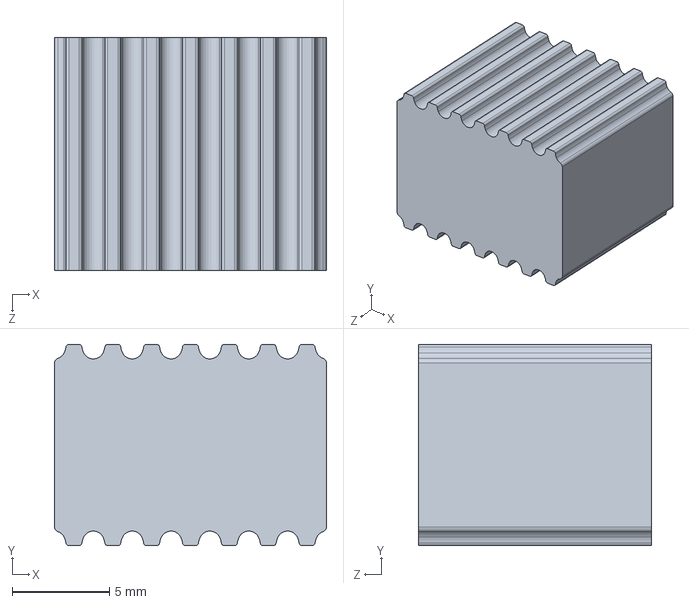
[picture p47: CAD file, 2024-12-06]
CAD/Components/Bed/PRT_Z_Tensioner_V2.SLDPRT
14.0 x 10.4 x 12.0 mm
