ZacCac/MoXY-3D-Printer/CAD/Components/Frame/PRT_Rubber_Feet.SLDPRT

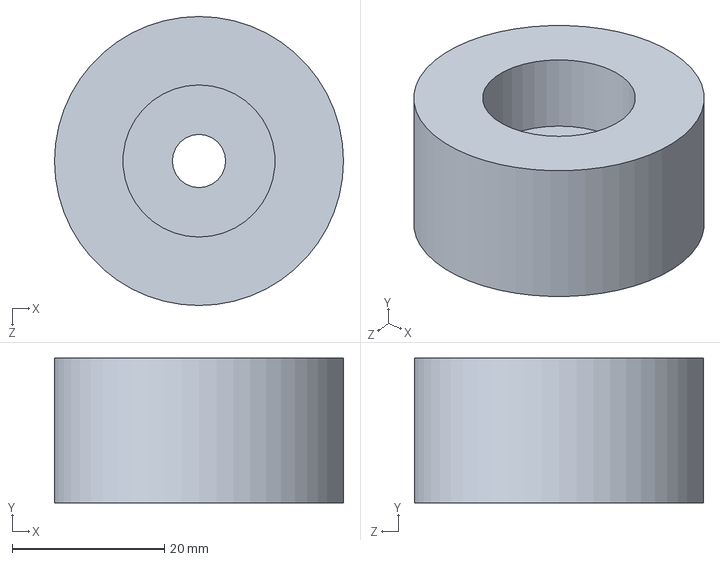
[picture p48: CAD file, 2024-05-26]
CAD/Components/Frame/PRT_Rubber_Feet.SLDPRT
38.0 x 19.0 x 38.0 mm
