ZacCac/MoXY-3D-Printer/CAD/Components/Gantry/PRT_XY_Block_Spacer_V2.SLDPRT

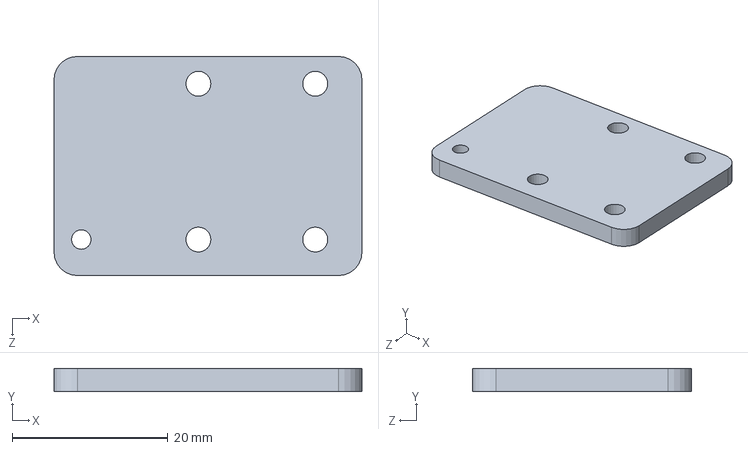
[picture p49: CAD file, 2025-02-01]
CAD/Components/Gantry/PRT_XY_Block_Spacer_V2.SLDPRT
39.5 x 3.00 x 28.1 mm
