ZacCac/MoXY-3D-Printer/CAD/Components/Printhead/PRT_PT1000_Thermistor.SLDPRT

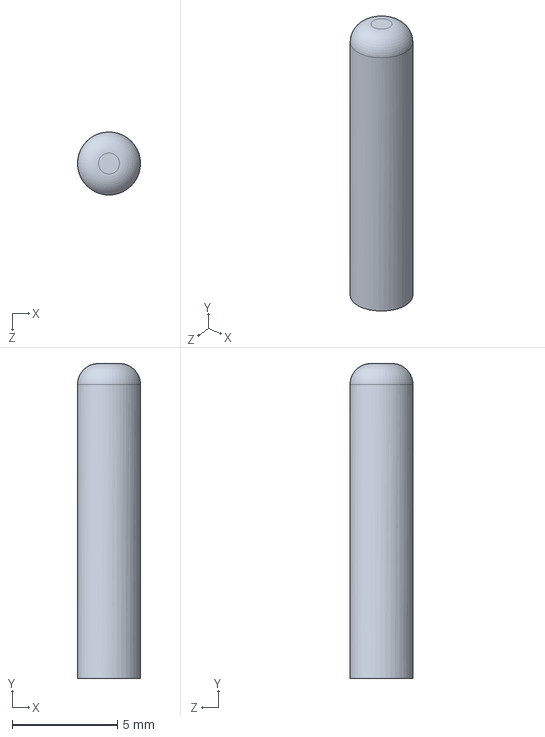
[picture p50: CAD file, 2024-11-04]
CAD/Components/Printhead/PRT_PT1000_Thermistor.SLDPRT
3.00 x 15.0 x 3.00 mm
