ZacCac/MoXY-3D-Printer/CAD/Components/Printhead/temp/PRT_Extruder_Body_V2.SLDPRT

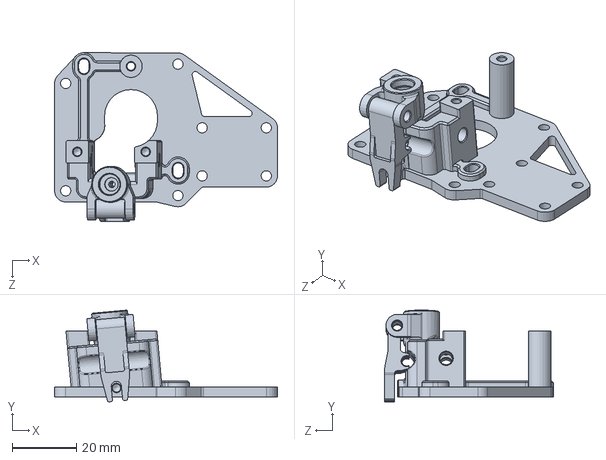
[picture p51: CAD file, 2025-02-01]
CAD/Components/Printhead/temp/PRT_Extruder_Body_V2.SLDPRT
69.6 x 28.6 x 52.6 mm
