ZacCac/MoXY-3D-Printer/CAD/Drawings/Waterjet Parts 3/DXF_Static_Toothed_Clamp_V1.DXF

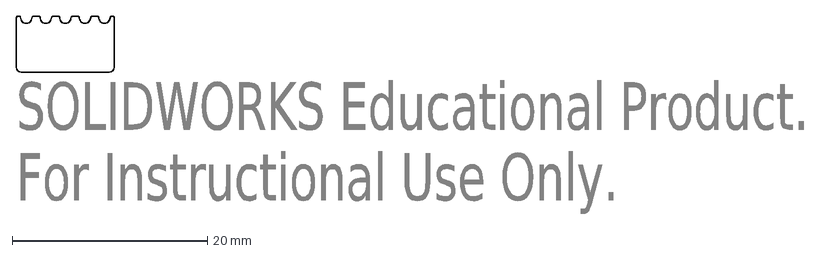
[picture p53: CAD file, 2024-11-14]
CAD/Drawings/Waterjet Parts 3/DXF_Static_Toothed_Clamp_V1.DXF
SOLIDWORKS Educational Product.
For Instructional Use Only.
