ZacCac/MoXY-3D-Printer/CAD/Drawings/Waterjet Parts 4/DXF_AC_Mount_V1.DXF

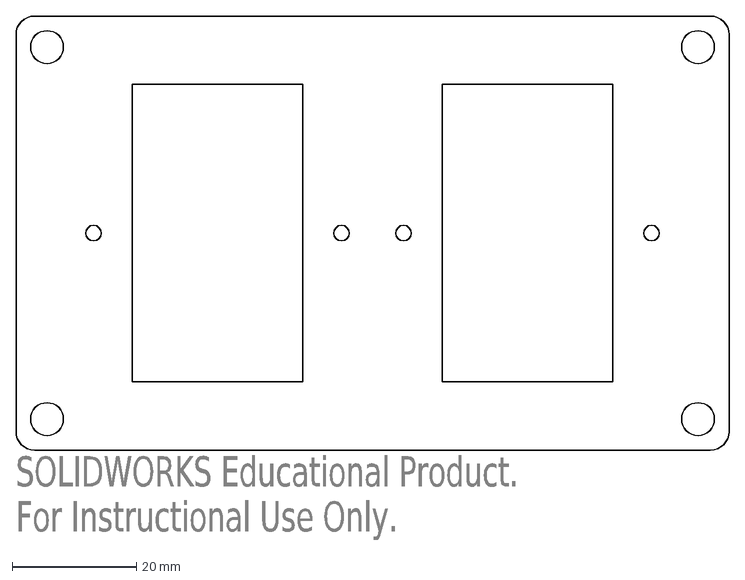
[picture p54: CAD file, 2024-12-02]
CAD/Drawings/Waterjet Parts 4/DXF_AC_Mount_V1.DXF
SOLIDWORKS Educational Product.
For Instructional Use Only.
