ZacCac/MoXY-3D-Printer/CAD/Drawings/Waterjet Parts/DXF_Supernova_Plate_V2.DXF

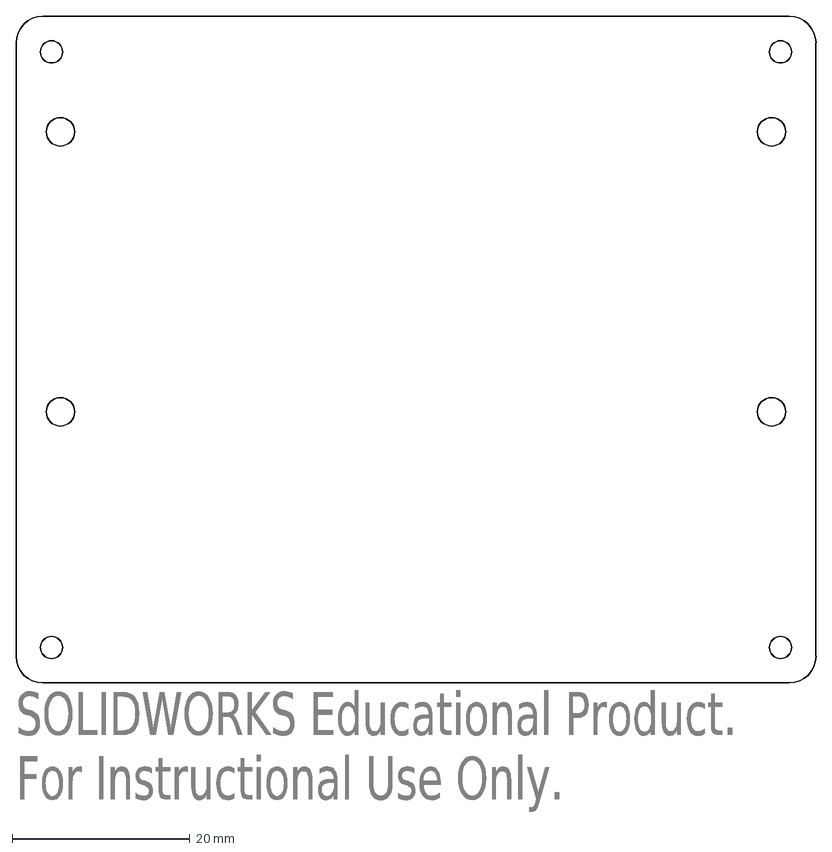
[picture p56: CAD file, 2024-11-04]
CAD/Drawings/Waterjet Parts/DXF_Supernova_Plate_V2.DXF
SOLIDWORKS Educational Product.
For Instructional Use Only.
