ZacCac/MoXY-3D-Printer/CAD/Electronics/Misc/PRT_Electronics_Box_Shell_V1.SLDPRT

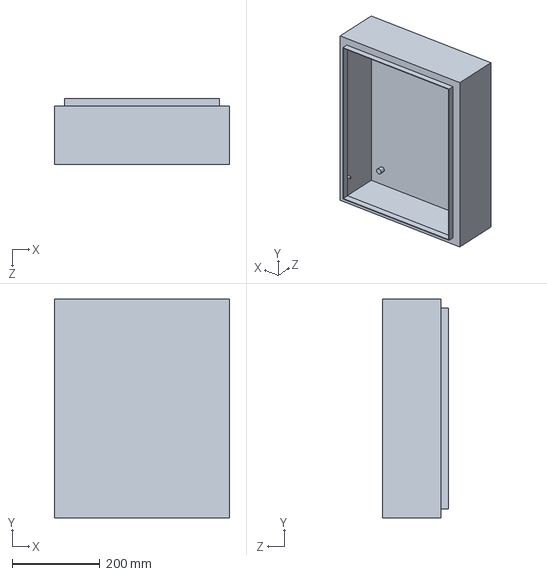
[picture p57: CAD file, 2024-12-02]
CAD/Electronics/Misc/PRT_Electronics_Box_Shell_V1.SLDPRT
400.0 x 500.0 x 150.0 mm
