ZacCac/MoXY-3D-Printer/CAD/Hardware/Bearings/PRT_5905K73_Needle-Roller Bearing_8mm.SLDPRT

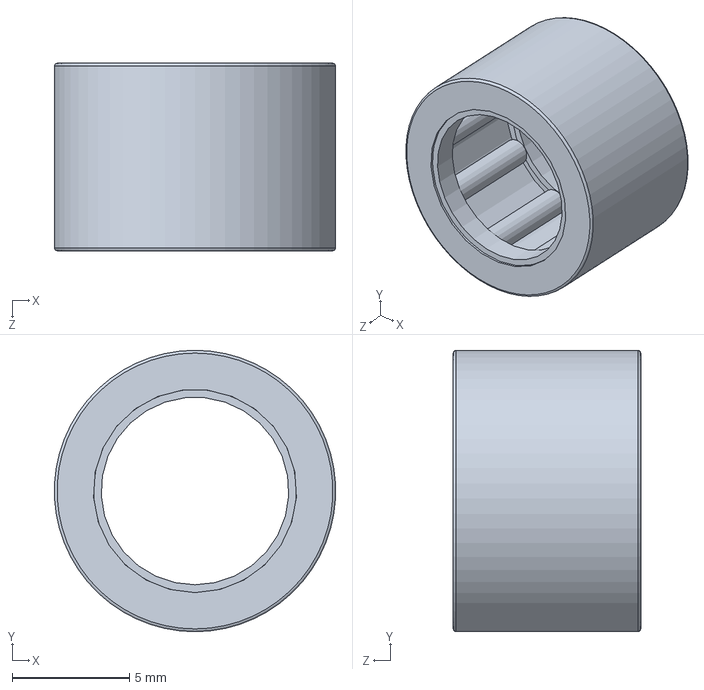
[picture p58: CAD file, 2024-07-01]
CAD/Hardware/Bearings/PRT_5905K73_Needle-Roller Bearing_8mm.SLDPRT
12.0 x 12.0 x 8.00 mm
