ZacCac/MoXY-3D-Printer/CAD/Hardware/Extrusions/PRT_HFS5-4040-80-TPW.sldprt

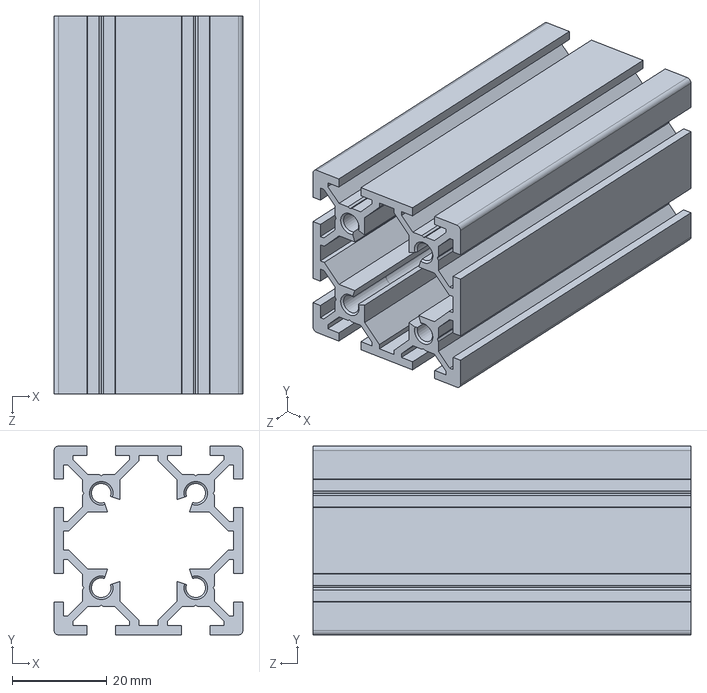
[picture p59: CAD file, 2024-05-26]
CAD/Hardware/Extrusions/PRT_HFS5-4040-80-TPW.sldprt
40.0 x 40.0 x 80.0 mm
