ZacCac/MoXY-3D-Printer/CAD/Hardware/Gears/PRT_Kyouiku_Gear_G80A20.SLDPRT

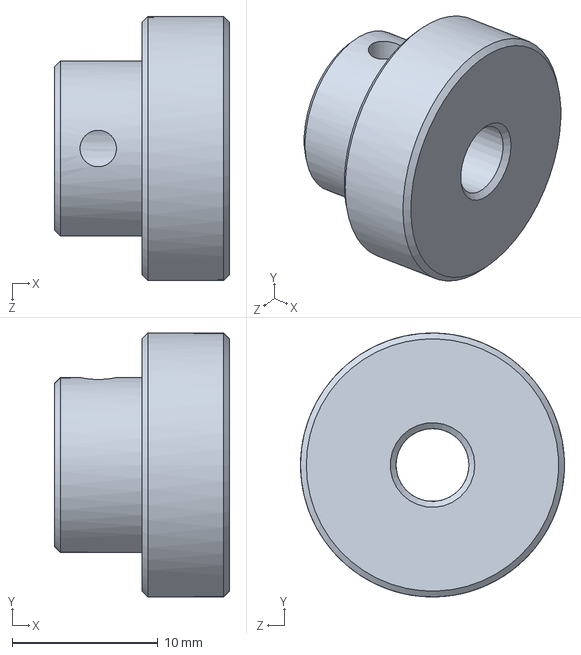
[picture p60: CAD file, 2024-07-01]
CAD/Hardware/Gears/PRT_Kyouiku_Gear_G80A20.SLDPRT
12.0 x 18.1 x 18.1 mm
