ZacCac/MoXY-3D-Printer/CAD/Hardware/Linear Rails/PRT_MGN12C_Carriage2.SLDPRT

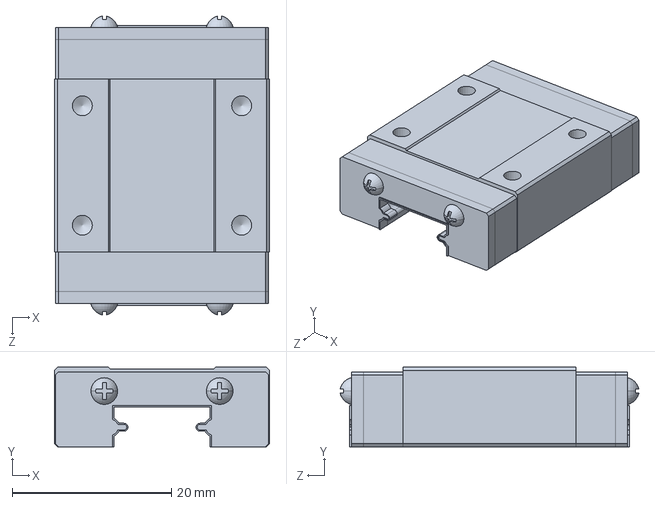
[picture p61: CAD file, 2024-07-28]
CAD/Hardware/Linear Rails/PRT_MGN12C_Carriage2.SLDPRT
27.0 x 10.0 x 37.5 mm
