ZacCac/MoXY-3D-Printer/CAD/Hardware/Motors/PRT_LDO-42STH48-2504AC.SLDPRT

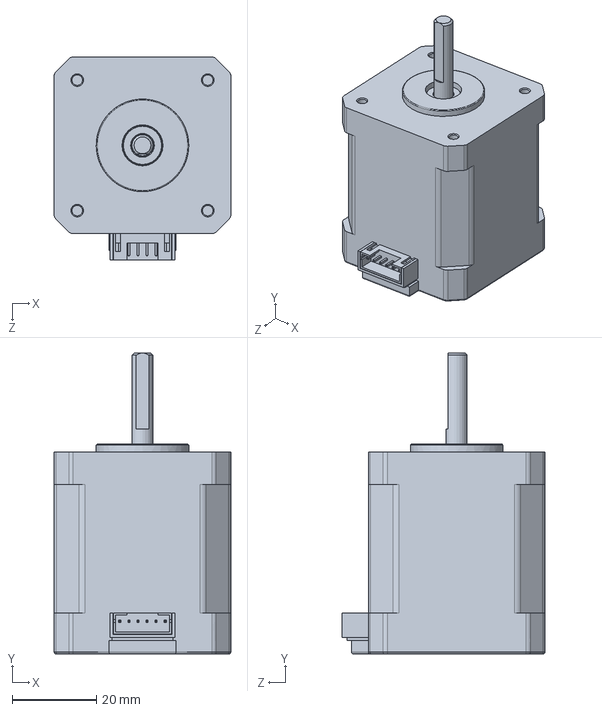
[picture p62: CAD file, 2024-07-01]
CAD/Hardware/Motors/PRT_LDO-42STH48-2504AC.SLDPRT
42.0 x 71.5 x 48.2 mm
