ZacCac/MoXY-3D-Printer/CAD/Hardware/Pulleys/PRT_Gates_2GT_20T_Toothed_Pulley_12mm.SLDPRT

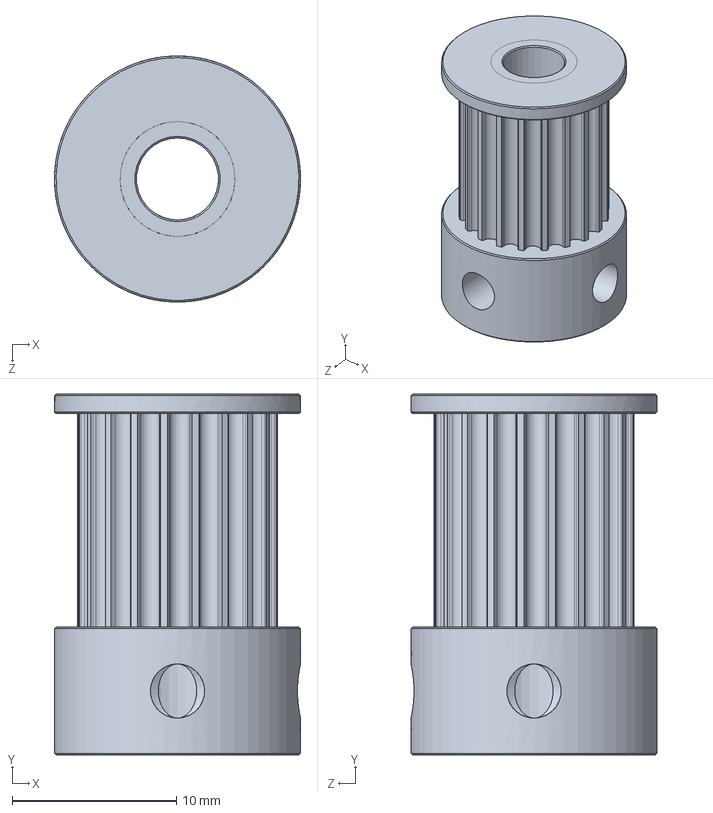
[picture p63: CAD file, 2024-07-01]
CAD/Hardware/Pulleys/PRT_Gates_2GT_20T_Toothed_Pulley_12mm.SLDPRT
15.0 x 22.0 x 15.0 mm
