ZacCac/MoXY-3D-Printer/CAD/Hardware/Shafts/PRT_5x12mm_Shaft.SLDPRT

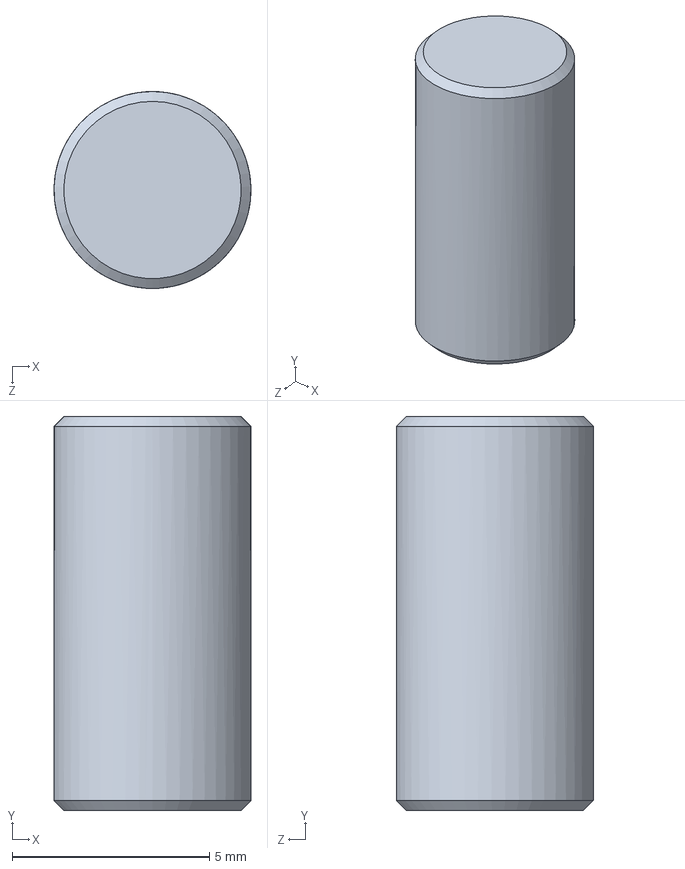
[picture p64: CAD file, 2024-11-04]
CAD/Hardware/Shafts/PRT_5x12mm_Shaft.SLDPRT
5.00 x 10.0 x 5.00 mm
