ZacCac/MoXY-3D-Printer/CAD/Components/Accessories/PRT_PG11_Mount_V1.SLDPRT

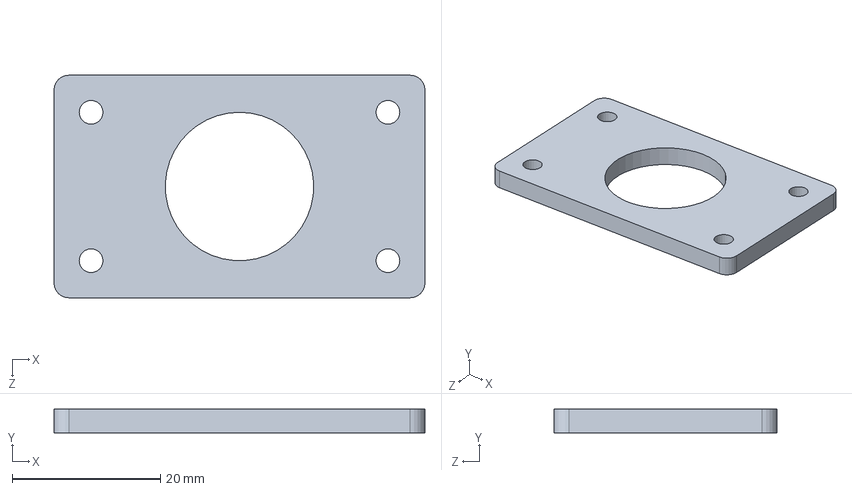
[picture p65: CAD file, 2024-07-14]
CAD/Components/Accessories/PRT_PG11_Mount_V1.SLDPRT
50.0 x 3.17 x 30.0 mm
