ZacCac/MoXY-3D-Printer/CAD/Components/Frame/PRT_GD-60F.SLDPRT

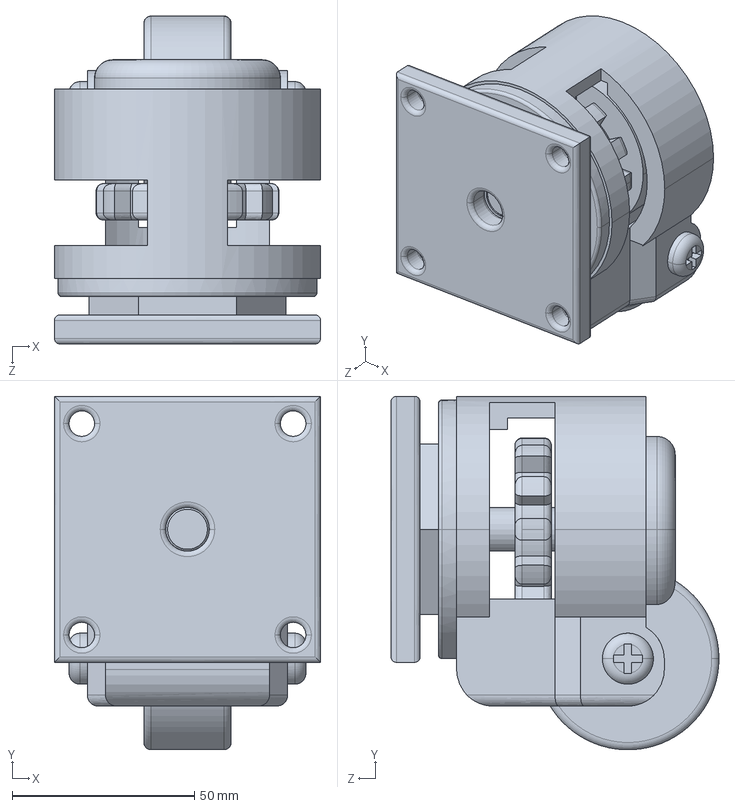
[picture p66: CAD file, 2024-05-26]
CAD/Components/Frame/PRT_GD-60F.SLDPRT
73.0 x 97.0 x 90.0 mm
