ZacCac/MoXY-3D-Printer/CAD/Components/Gantry/PRT_XY_Block_V2.SLDPRT

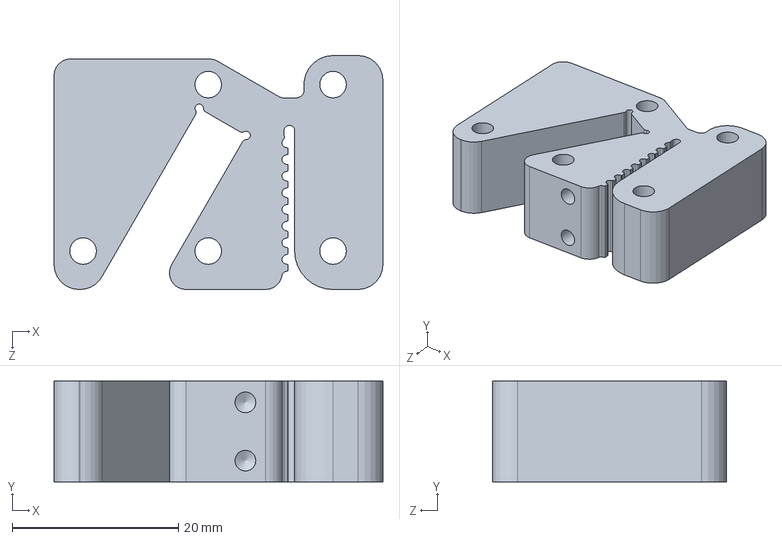
[picture p67: CAD file, 2025-02-01]
CAD/Components/Gantry/PRT_XY_Block_V2.SLDPRT
39.5 x 12.1 x 28.1 mm
