ZacCac/MoXY-3D-Printer/CAD/Components/Printhead/PRT_48mm_Cartridge_Heater.SLDPRT

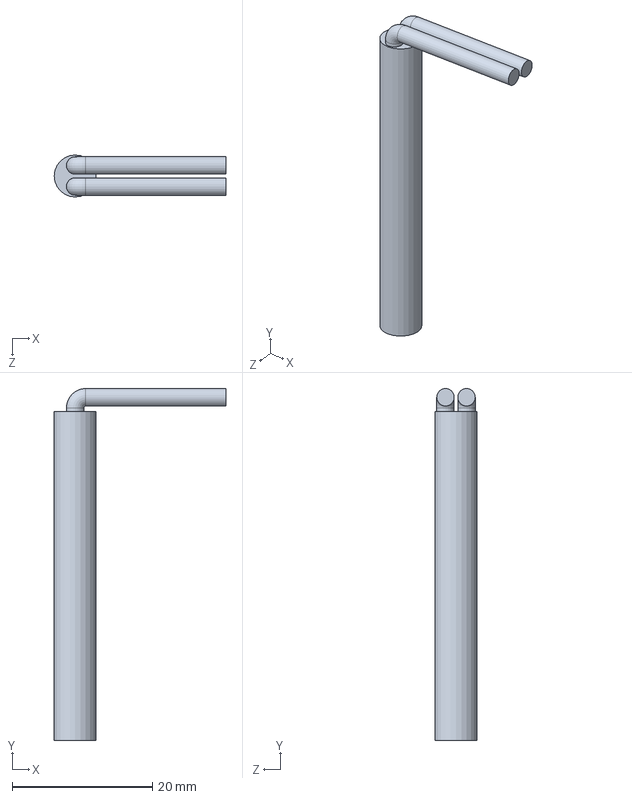
[picture p68: CAD file, 2024-11-04]
CAD/Components/Printhead/PRT_48mm_Cartridge_Heater.SLDPRT
24.5 x 50.2 x 6.00 mm
