ZacCac/MoXY-3D-Printer/CAD/Components/Printhead/temp/PRT_Duct_Top_V1.SLDPRT

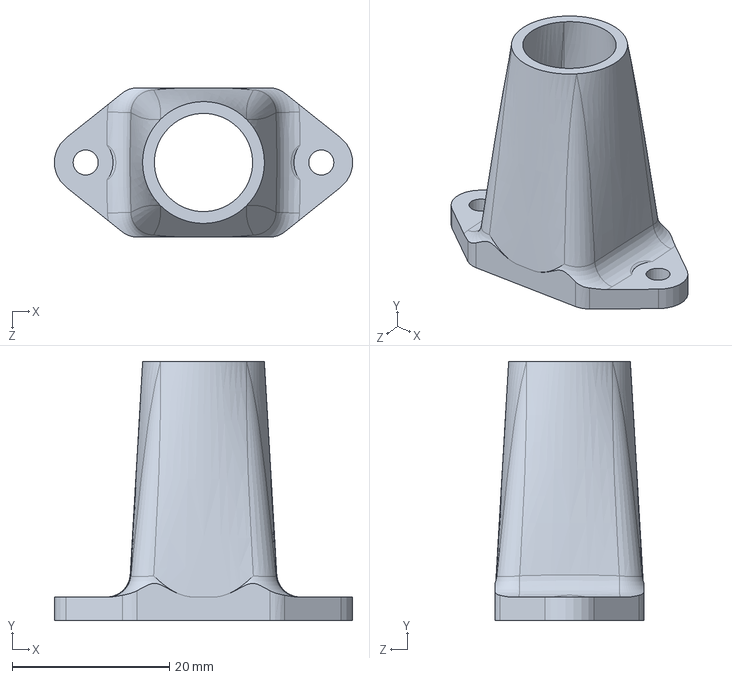
[picture p69: CAD file, 2025-01-20]
CAD/Components/Printhead/temp/PRT_Duct_Top_V1.SLDPRT
37.9 x 33.0 x 19.0 mm
