ZacCac/MoXY-3D-Printer/CAD/Drawings/Waterjet Parts 3/DXF_XY_Block_Skeletonized_V2.DXF

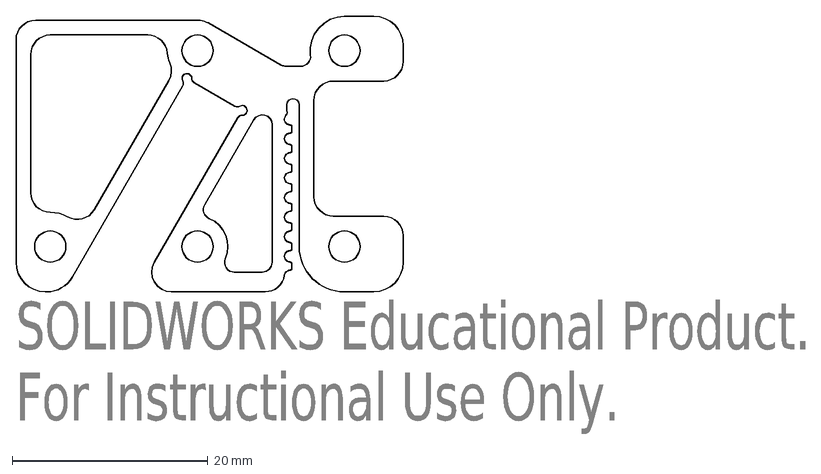
[picture p71: CAD file, 2024-11-14]
CAD/Drawings/Waterjet Parts 3/DXF_XY_Block_Skeletonized_V2.DXF
SOLIDWORKS Educational Product.
For Instructional Use Only.
