ZacCac/MoXY-3D-Printer/CAD/Drawings/Waterjet Parts 4/DXF_Back_Wiring_Panel_V1.DXF

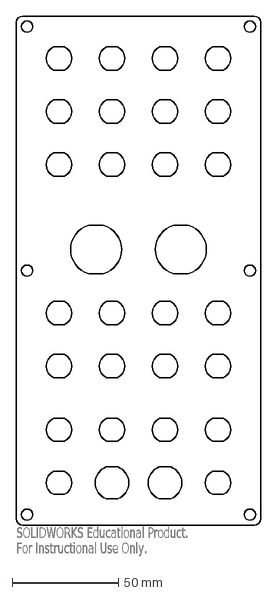
[picture p72: CAD file, 2024-12-02]
CAD/Drawings/Waterjet Parts 4/DXF_Back_Wiring_Panel_V1.DXF
SOLIDWORKS Educational Product.
For Instructional Use Only.
