ZacCac/MoXY-3D-Printer/CAD/Drawings/Waterjet Parts 5/DXF_XY_Block_V2.DXF

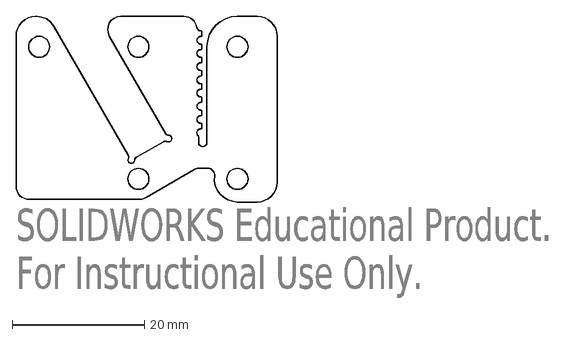
[picture p73: CAD file, 2024-11-14]
CAD/Drawings/Waterjet Parts 5/DXF_XY_Block_V2.DXF
SOLIDWORKS Educational Product.
For Instructional Use Only.
