ZacCac/MoXY-3D-Printer/CAD/Drawings/Waterjet Parts/DXF_Raspi_Plate_V2.DXF

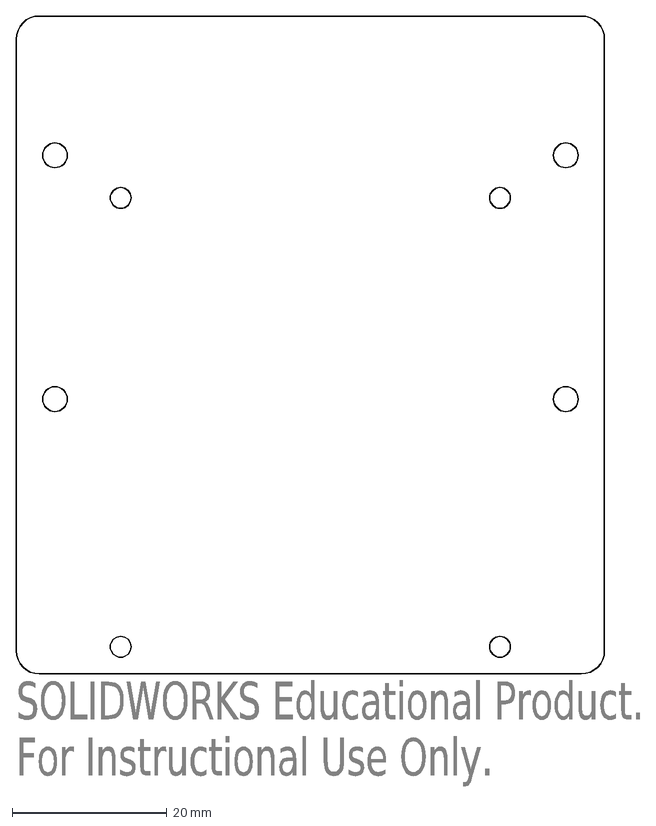
[picture p74: CAD file, 2024-11-04]
CAD/Drawings/Waterjet Parts/DXF_Raspi_Plate_V2.DXF
SOLIDWORKS Educational Product.
For Instructional Use Only.
