ZacCac/MoXY-3D-Printer/CAD/Electronics/Connectors/PRT_AC_Mount_V1.SLDPRT

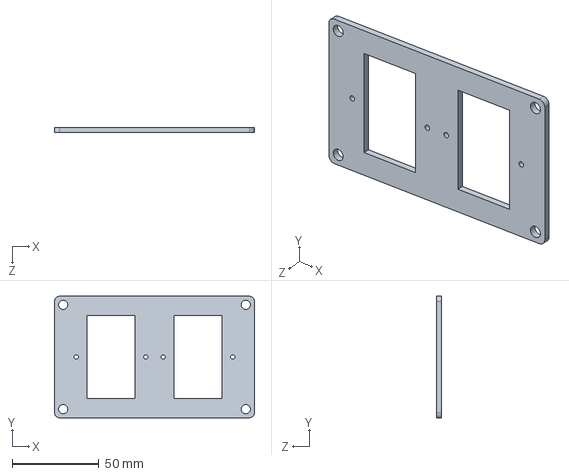
[picture p75: CAD file, 2024-12-02]
CAD/Electronics/Connectors/PRT_AC_Mount_V1.SLDPRT
115.0 x 70.0 x 3.00 mm
