ZacCac/MoXY-3D-Printer/CAD/Electronics/Endstops and Probes/EE_SPX841.SLDPRT

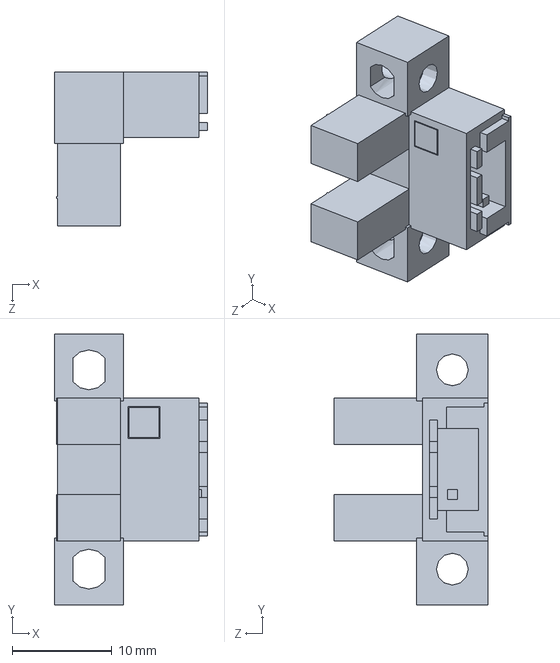
[picture p76: CAD file, 2024-05-26]
CAD/Electronics/Endstops and Probes/EE_SPX841.SLDPRT
15.4 x 27.2 x 15.5 mm
