ZacCac/MoXY-3D-Printer/CAD/Electronics/Misc/PRT_Cable_Clamp_x4_V1.SLDPRT

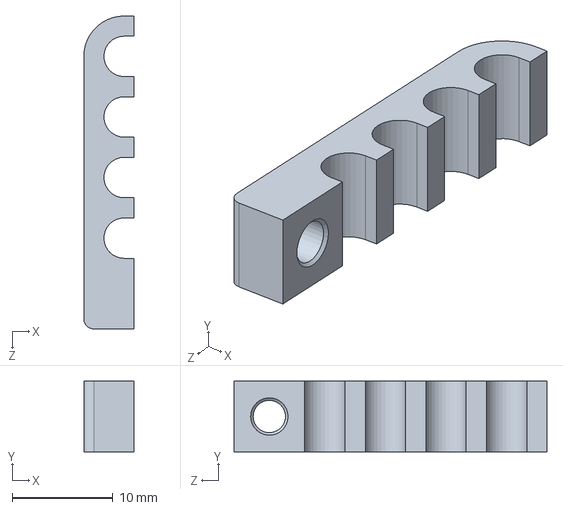
[picture p77: CAD file, 2024-12-02]
CAD/Electronics/Misc/PRT_Cable_Clamp_x4_V1.SLDPRT
5.00 x 7.00 x 31.0 mm
