ZacCac/MoXY-3D-Printer/CAD/Hardware/Bearings/PRT_SB628ZZ_Bearing.SLDPRT

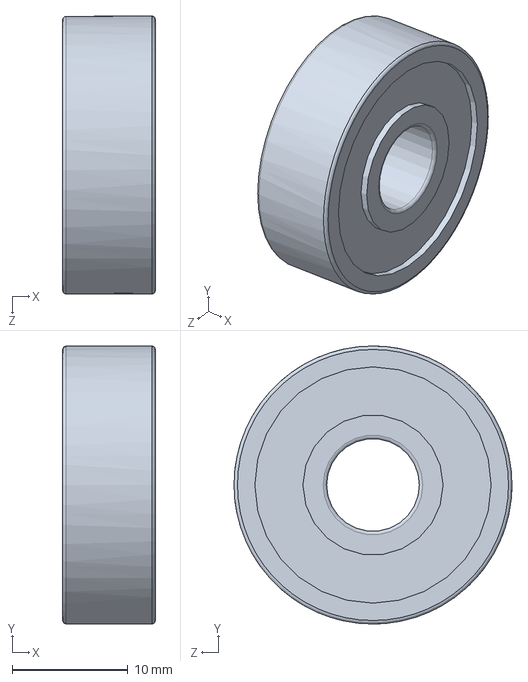
[picture p78: CAD file, 2024-06-22]
CAD/Hardware/Bearings/PRT_SB628ZZ_Bearing.SLDPRT
8.00 x 24.0 x 24.0 mm
