ZacCac/MoXY-3D-Printer/CAD/Hardware/Motors/PRT_LDO-42STH48-2504AHS8-55.SLDPRT

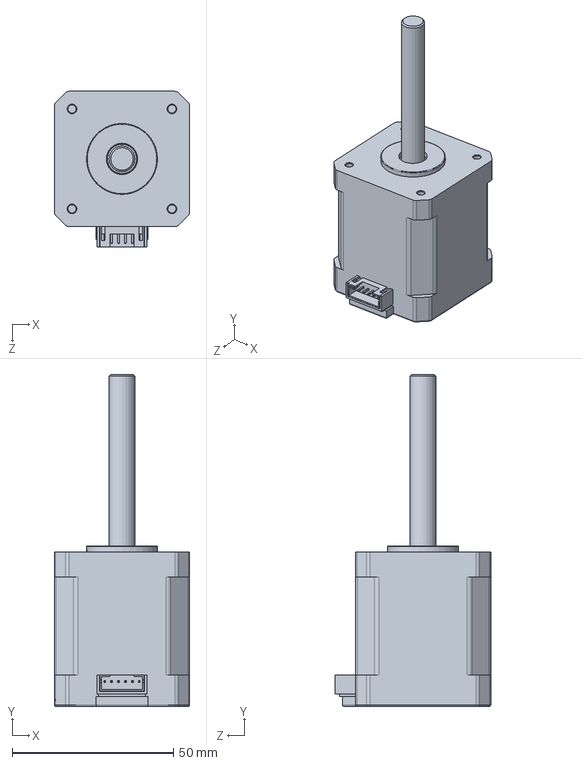
[picture p79: CAD file, 2024-06-24]
CAD/Hardware/Motors/PRT_LDO-42STH48-2504AHS8-55.SLDPRT
42.0 x 103.0 x 48.2 mm
