ZacCac/MoXY-3D-Printer/CAD/Hardware/Shafts/PRT_5x22mm_Shaft.SLDPRT

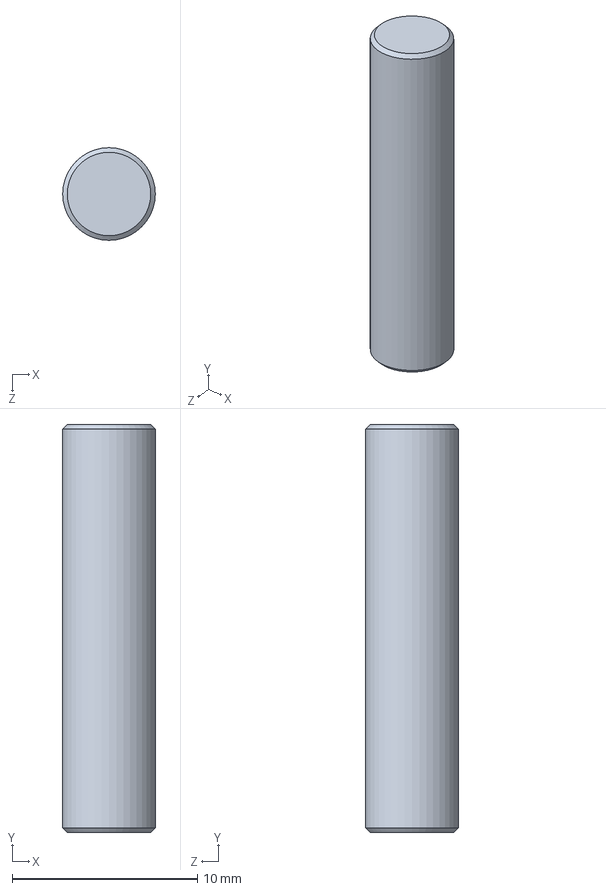
[picture p80: CAD file, 2024-09-10]
CAD/Hardware/Shafts/PRT_5x22mm_Shaft.SLDPRT
5.00 x 22.0 x 5.00 mm
