ZacCac/MoXY-3D-Printer/CAD/Components/Accessories/PRT_Key_Fob_V1.SLDPRT

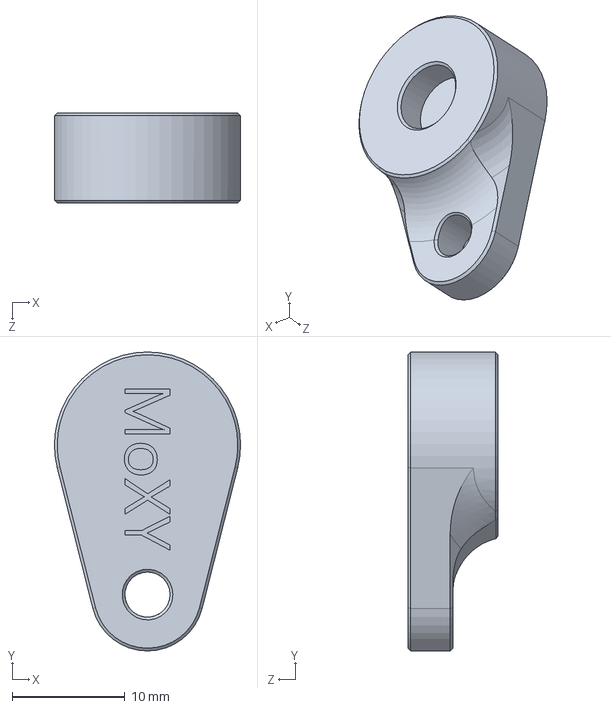
[picture p81: CAD file, 2024-07-07]
CAD/Components/Accessories/PRT_Key_Fob_V1.SLDPRT
16.5 x 26.5 x 8.00 mm
