ZacCac/MoXY-3D-Printer/CAD/Components/Gantry/PRT_XY_Spacer_V1.SLDPRT

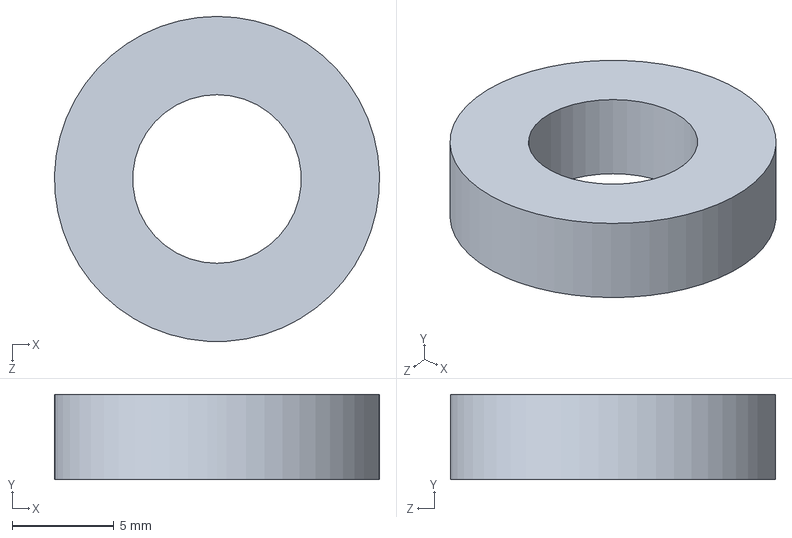
[picture p82: CAD file, 2025-02-01]
CAD/Components/Gantry/PRT_XY_Spacer_V1.SLDPRT
16.0 x 4.20 x 16.0 mm
