ZacCac/MoXY-3D-Printer/CAD/Components/Panels/PRT_Temp_Panel_V1.SLDPRT

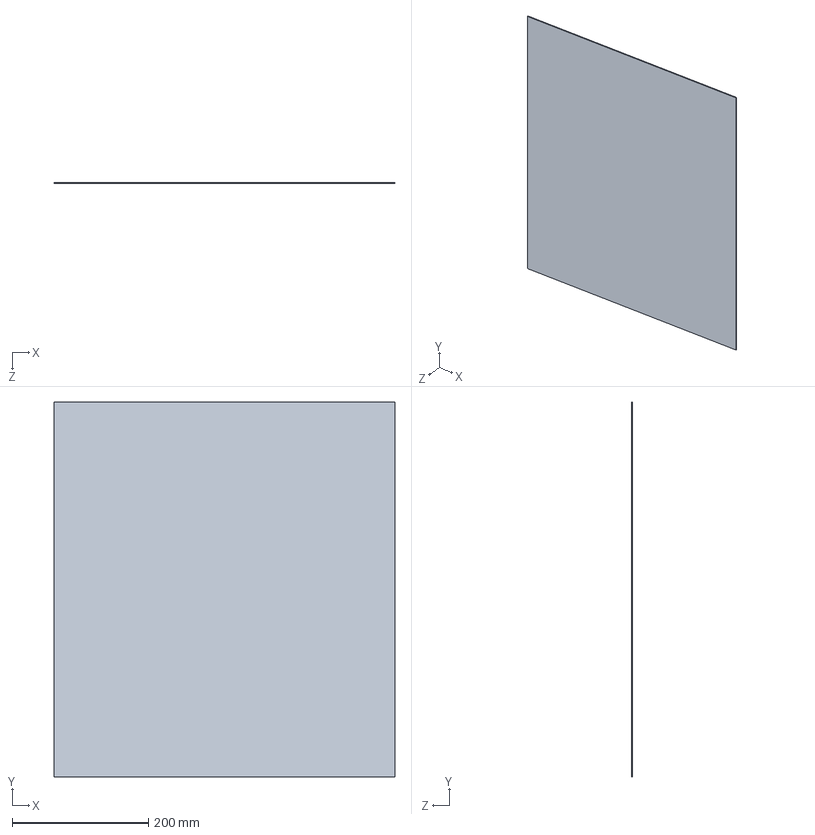
[picture p83: CAD file, 2024-09-10]
CAD/Components/Panels/PRT_Temp_Panel_V1.SLDPRT
500.0 x 550.0 x 2.00 mm
