ZacCac/MoXY-3D-Printer/CAD/Components/Printhead/temp/PRT_Extruder_Bottom_V3.SLDPRT

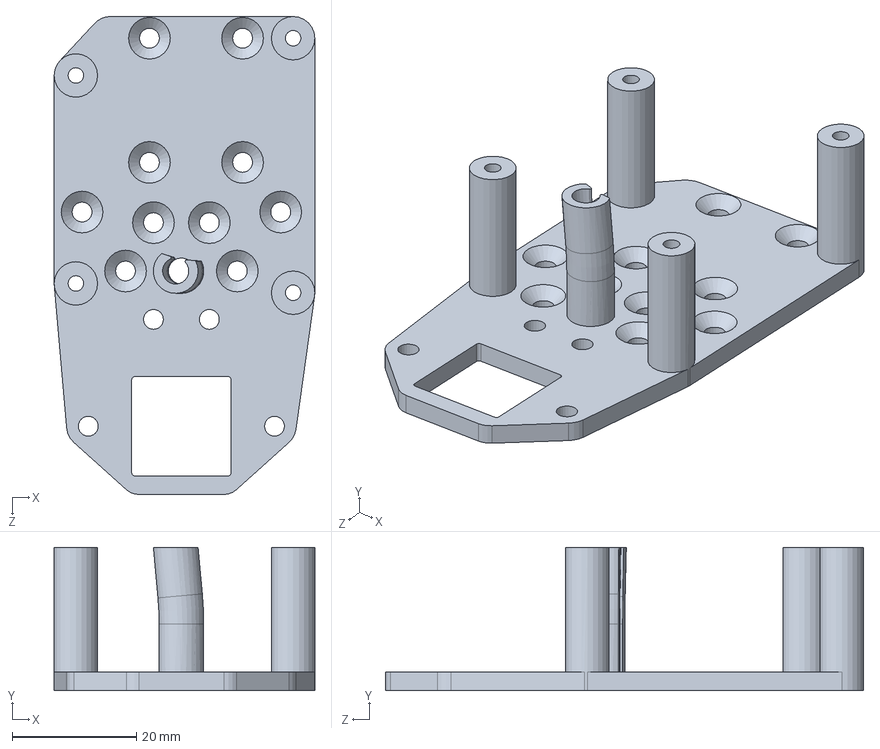
[picture p84: CAD file, 2025-01-20]
CAD/Components/Printhead/temp/PRT_Extruder_Bottom_V3.SLDPRT
42.0 x 23.1 x 77.0 mm
