ZacCac/MoXY-3D-Printer/CAD/Drawings/Waterjet Parts 2/DXF_XY_Backer_V4.DXF

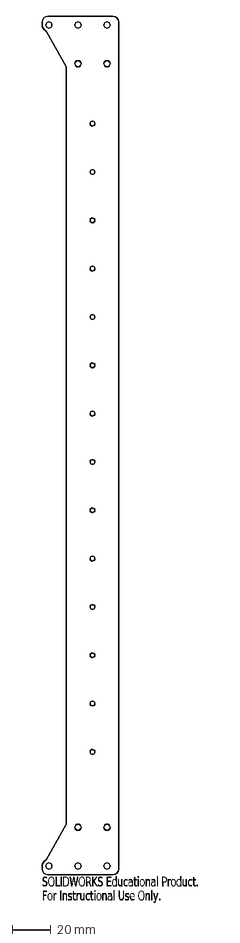
[picture p85: CAD file, 2024-11-19]
CAD/Drawings/Waterjet Parts 2/DXF_XY_Backer_V4.DXF
SOLIDWORKS Educational Product.
For Instructional Use Only.
