ZacCac/MoXY-3D-Printer/CAD/Drawings/Waterjet Parts 4/DXF_XY_Spacer_V2.DXF

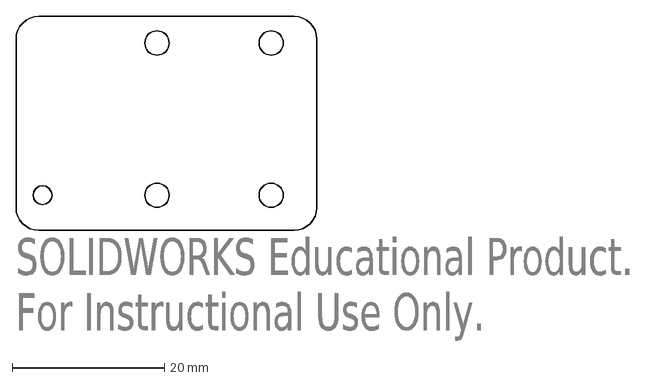
[picture p86: CAD file, 2024-12-02]
CAD/Drawings/Waterjet Parts 4/DXF_XY_Spacer_V2.DXF
SOLIDWORKS Educational Product.
For Instructional Use Only.
