ZacCac/MoXY-3D-Printer/CAD/Drawings/Waterjet Parts 5/DXF_keyhole_V1.DXF

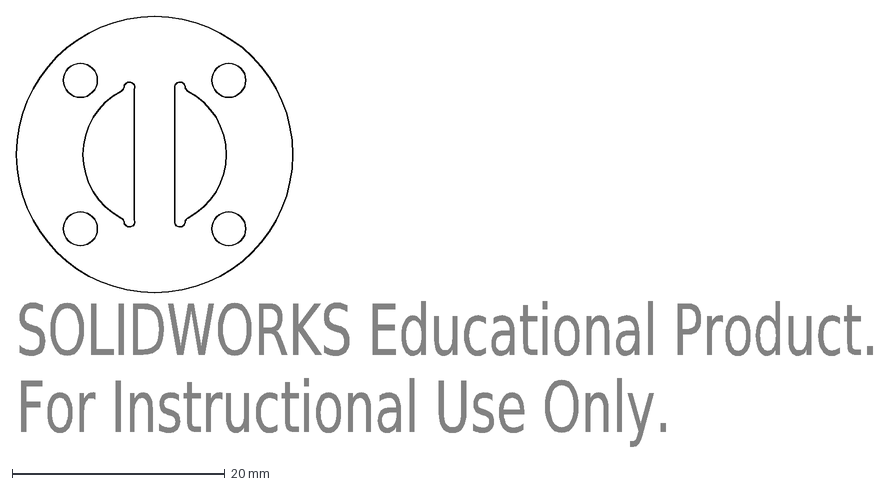
[picture p87: CAD file, 2024-11-14]
CAD/Drawings/Waterjet Parts 5/DXF_keyhole_V1.DXF
SOLIDWORKS Educational Product.
For Instructional Use Only.
