ZacCac/MoXY-3D-Printer/CAD/Drawings/Waterjet Parts/DXF_Buildplate_Stopper_V1.DXF

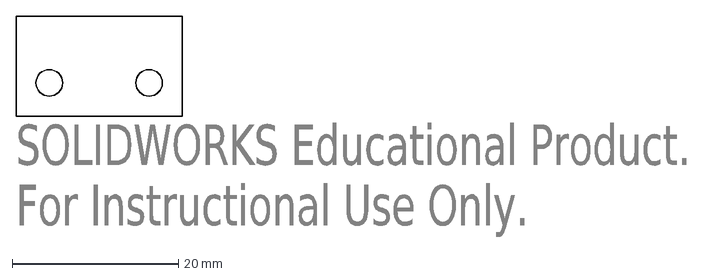
[picture p88: CAD file, 2024-11-04]
CAD/Drawings/Waterjet Parts/DXF_Buildplate_Stopper_V1.DXF
SOLIDWORKS Educational Product.
For Instructional Use Only.
