ZacCac/MoXY-3D-Printer/CAD/Electronics/Connectors/PRT_XY_Stepper_Aviator_Mount_V2.SLDPRT

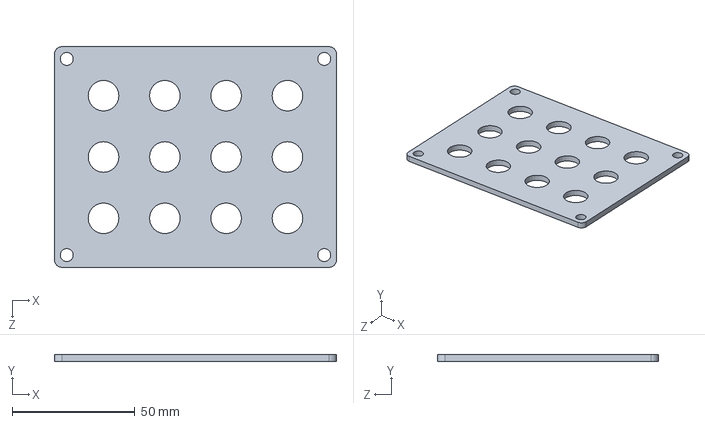
[picture p89: CAD file, 2024-12-02]
CAD/Electronics/Connectors/PRT_XY_Stepper_Aviator_Mount_V2.SLDPRT
115.0 x 3.00 x 90.0 mm
