ZacCac/MoXY-3D-Printer/CAD/Electronics/Endstops and Probes/EE_SPX842.SLDPRT

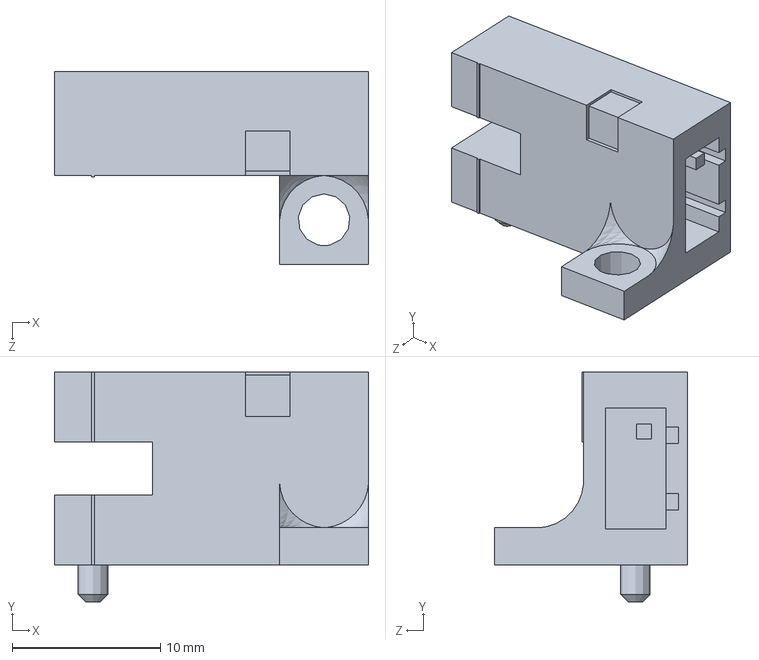
[picture p90: CAD file, 2024-05-26]
CAD/Electronics/Endstops and Probes/EE_SPX842.SLDPRT
21.2 x 15.5 x 13.0 mm
