ZacCac/MoXY-3D-Printer/CAD/Electronics/Misc/PRT_UK_2.5_Terminal_Block.SLDPRT

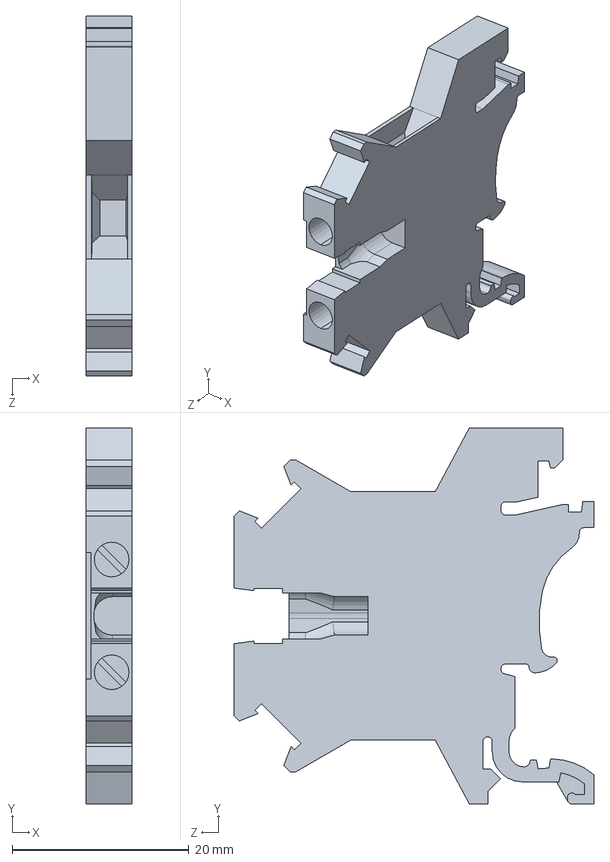
[picture p91: CAD file, 2024-11-14]
CAD/Electronics/Misc/PRT_UK_2.5_Terminal_Block.SLDPRT
5.15 x 42.5 x 40.7 mm
