ZacCac/MoXY-3D-Printer/CAD/Hardware/Bearings/PRT_5905K349_Needle-Roller Bearing_5mm.SLDPRT

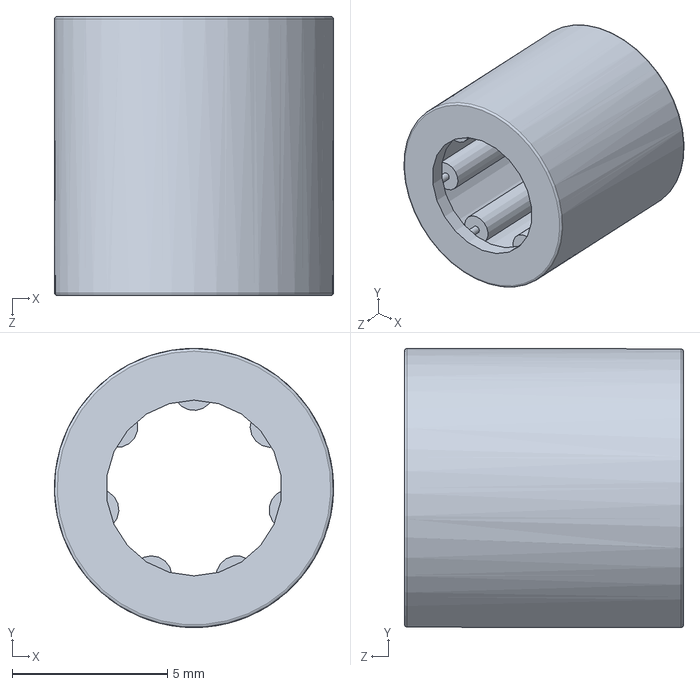
[picture p92: CAD file, 2024-05-26]
CAD/Hardware/Bearings/PRT_5905K349_Needle-Roller Bearing_5mm.SLDPRT
8.99 x 9.00 x 9.00 mm
