ZacCac/MoXY-3D-Printer/CAD/Hardware/Couplers/PRT_8011N233_Precision Flexible Shaft Coupling_5-8mm.SLDPRT

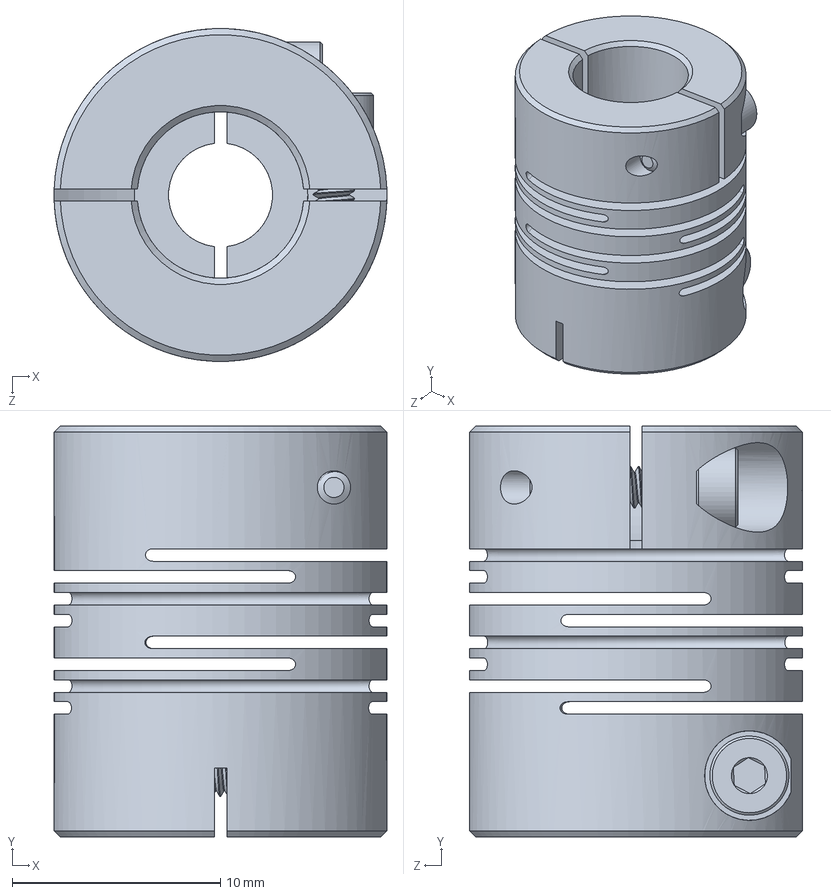
[picture p93: CAD file, 2024-05-26]
CAD/Hardware/Couplers/PRT_8011N233_Precision Flexible Shaft Coupling_5-8mm.SLDPRT
16.0 x 19.8 x 16.0 mm
