ZacCac/MoXY-3D-Printer/CAD/Hardware/Linear Rails/PRT_MGN12C_Carriage.SLDPRT

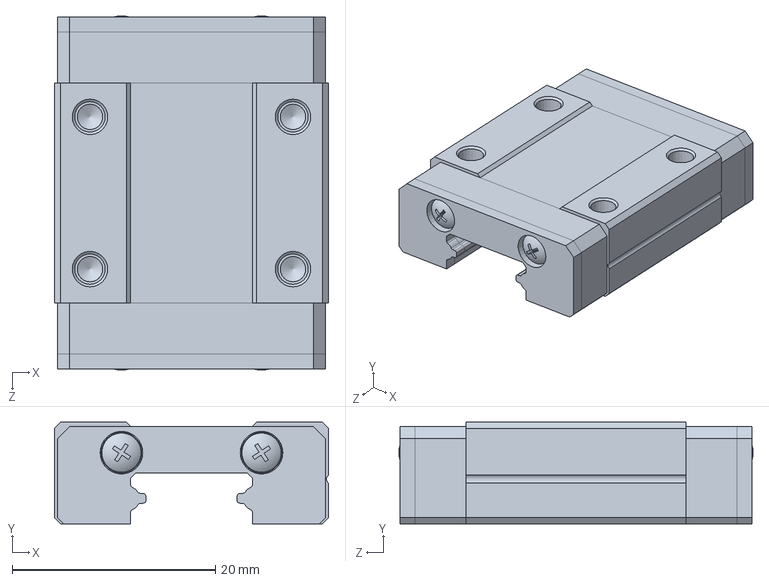
[picture p94: CAD file, 2024-07-19]
CAD/Hardware/Linear Rails/PRT_MGN12C_Carriage.SLDPRT
27.0 x 10.0 x 34.9 mm
