ZacCac/MoXY-3D-Printer/CAD/Hardware/Shafts/PRT_5x15mm_Shaft.SLDPRT

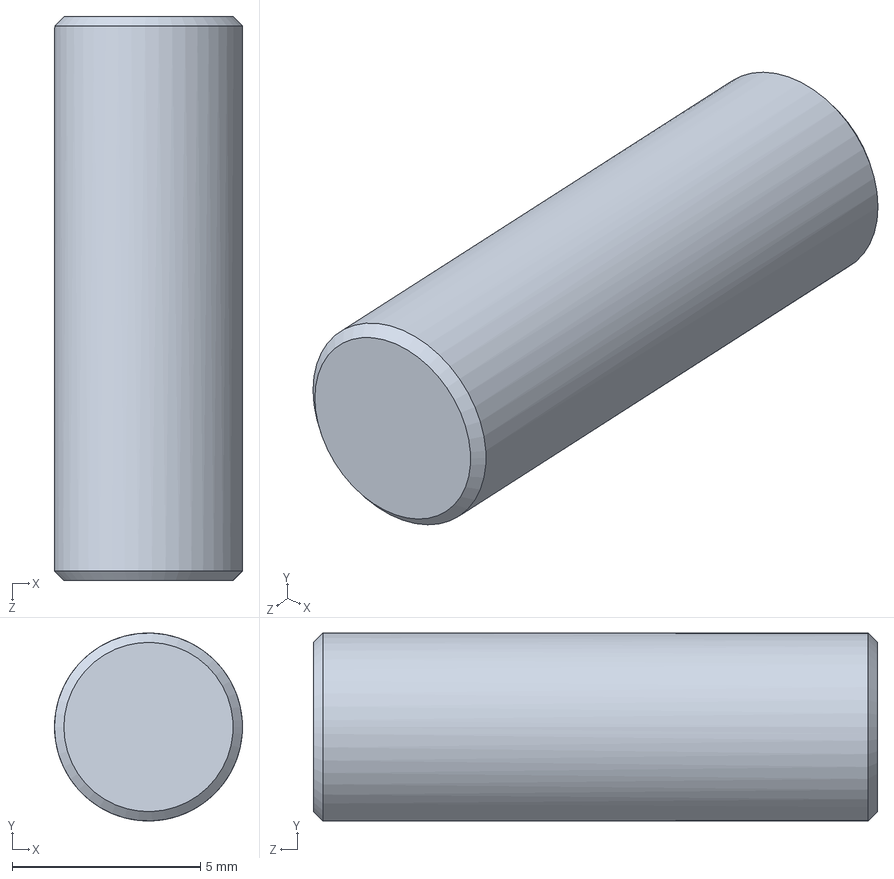
[picture p95: CAD file, 2024-09-10]
CAD/Hardware/Shafts/PRT_5x15mm_Shaft.SLDPRT
5.00 x 5.00 x 15.0 mm
