ZacCac/MoXY-3D-Printer/CAD/Components/Gantry/PRT_Static_Toothed_Clamp_V2.SLDPRT

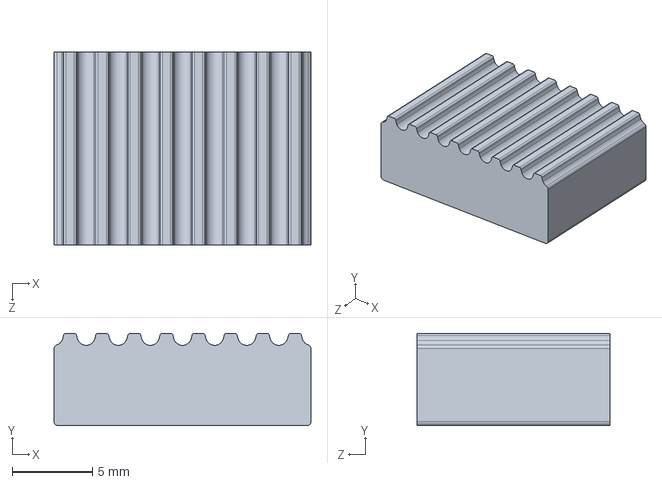
[picture p96: CAD file, 2024-12-06]
CAD/Components/Gantry/PRT_Static_Toothed_Clamp_V2.SLDPRT
16.0 x 5.75 x 12.0 mm
