ZacCac/MoXY-3D-Printer/CAD/Components/Panels/PRT_Top_Panel_V1.SLDPRT

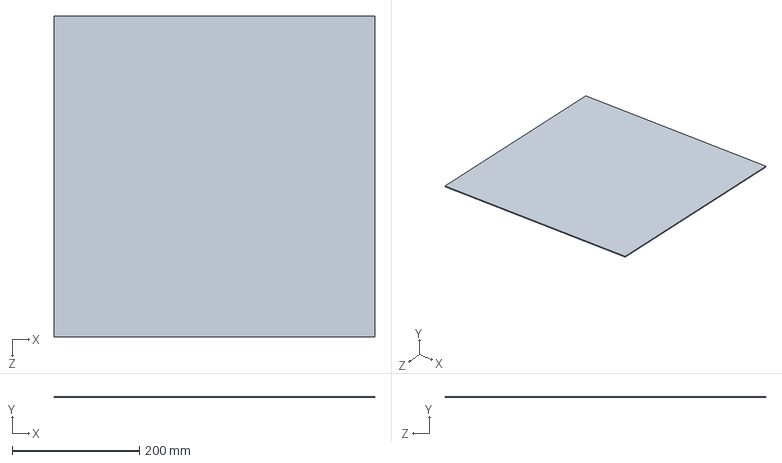
[picture p97: CAD file, 2024-07-14]
CAD/Components/Panels/PRT_Top_Panel_V1.SLDPRT
504.0 x 2.00 x 504.0 mm
