ZacCac/MoXY-3D-Printer/CAD/Components/Printhead/PRT_MA_LDO-36STH20-1004AH.SLDPRT

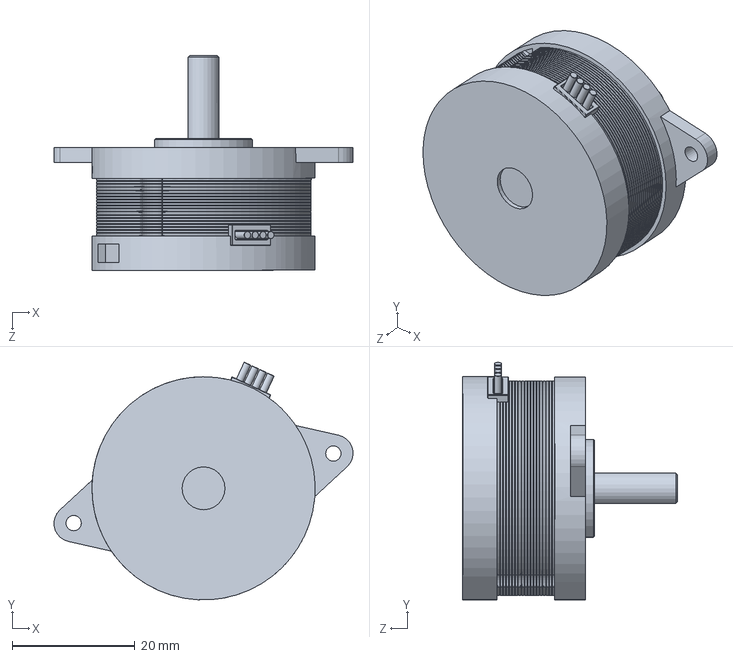
[picture p98: CAD file, 2024-07-29]
CAD/Components/Printhead/PRT_MA_LDO-36STH20-1004AH.SLDPRT
48.8 x 38.7 x 35.0 mm
