ZacCac/MoXY-3D-Printer/CAD/Components/Printhead/temp/PRT_Bowden_Tube_V1.SLDPRT

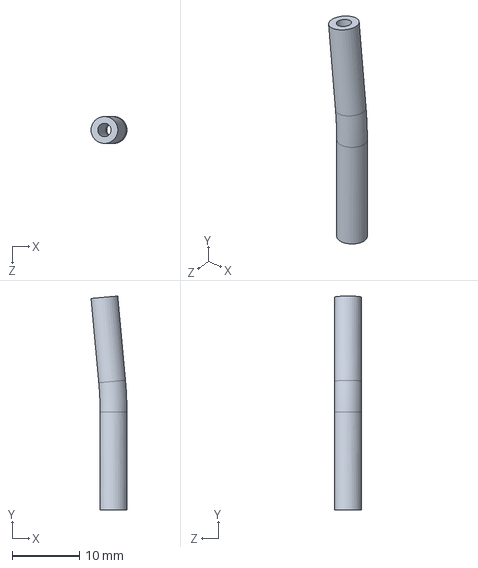
[picture p99: CAD file, 2024-12-02]
CAD/Components/Printhead/temp/PRT_Bowden_Tube_V1.SLDPRT
5.34 x 31.8 x 4.00 mm
