ZacCac/MoXY-3D-Printer/CAD/Drawings/Waterjet Parts 2/DXF_Z_Stepper_Plate_Mount_V3.DXF

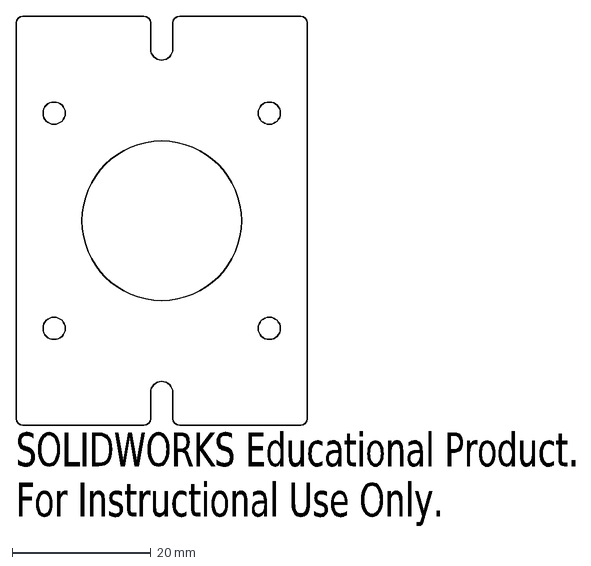
[picture p100: CAD file, 2024-11-19]
CAD/Drawings/Waterjet Parts 2/DXF_Z_Stepper_Plate_Mount_V3.DXF
SOLIDWORKS Educational Product.
For Instructional Use Only.
