ZacCac/MoXY-3D-Printer/CAD/Drawings/Waterjet Parts 4/DXF_PG11_Mount_V1.DXF

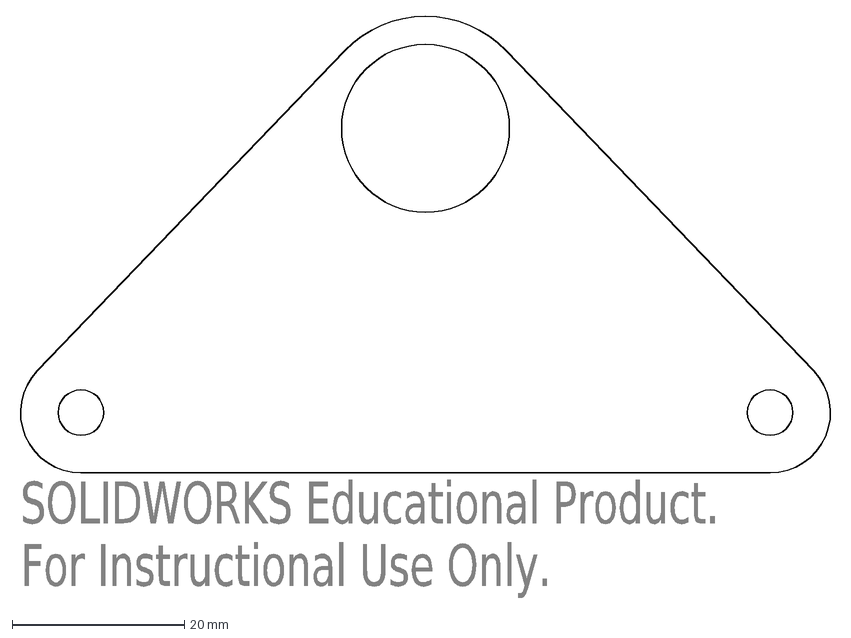
[picture p101: CAD file, 2024-12-02]
CAD/Drawings/Waterjet Parts 4/DXF_PG11_Mount_V1.DXF
SOLIDWORKS Educational Product.
For Instructional Use Only.
