ZacCac/MoXY-3D-Printer/CAD/Drawings/Waterjet Parts 5/DXF_Motor_Mount_V3.DXF

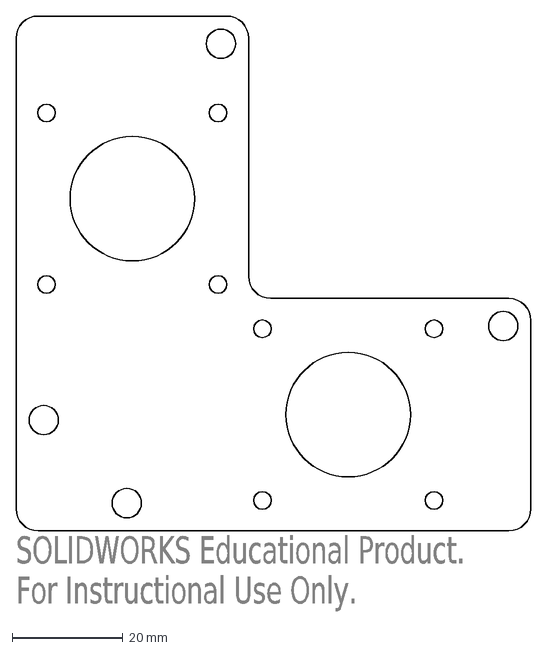
[picture p102: CAD file, 2024-11-14]
CAD/Drawings/Waterjet Parts 5/DXF_Motor_Mount_V3.DXF
SOLIDWORKS Educational Product.
For Instructional Use Only.
