ZacCac/MoXY-3D-Printer/CAD/Drawings/Waterjet Parts/DXF_Mellow_D5_Plate_V1.DXF

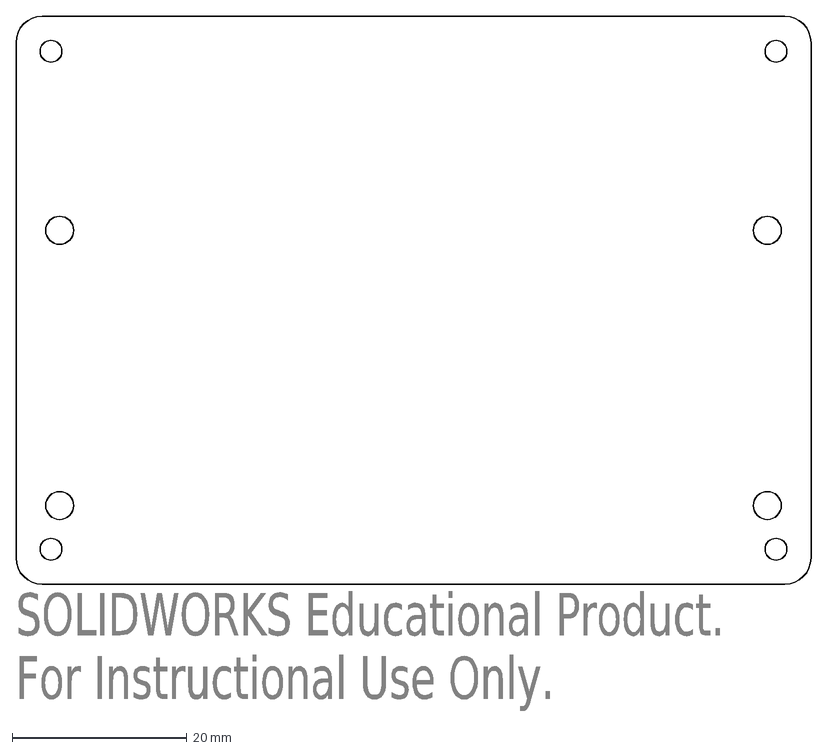
[picture p103: CAD file, 2024-11-04]
CAD/Drawings/Waterjet Parts/DXF_Mellow_D5_Plate_V1.DXF
SOLIDWORKS Educational Product.
For Instructional Use Only.
