ZacCac/MoXY-3D-Printer/CAD/Electronics/Connectors/PRT_Printhead_Aviator_Mount_V1.SLDPRT

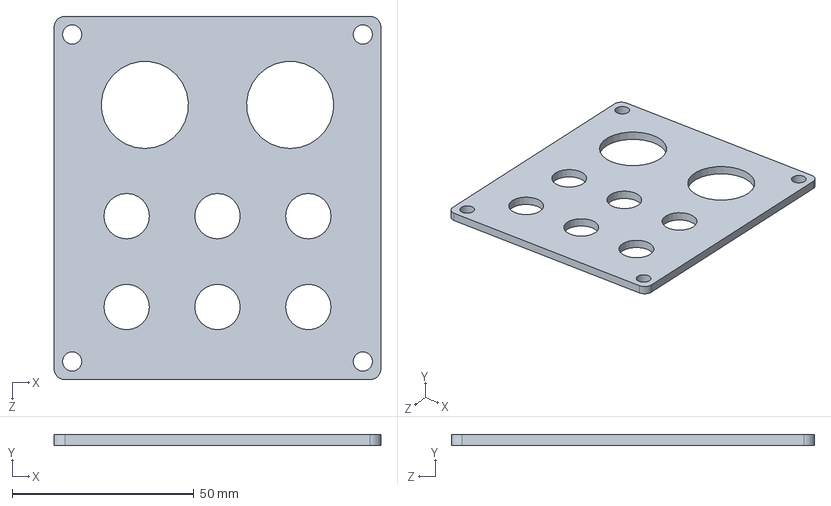
[picture p104: CAD file, 2024-12-02]
CAD/Electronics/Connectors/PRT_Printhead_Aviator_Mount_V1.SLDPRT
90.0 x 3.00 x 100.0 mm
