ZacCac/MoXY-3D-Printer/CAD/Electronics/Misc/PRT_Raspi_Plate_V2.SLDPRT

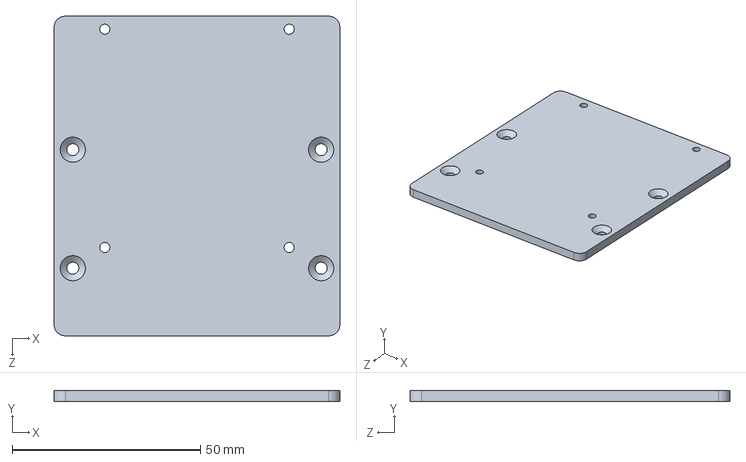
[picture p105: CAD file, 2024-11-04]
CAD/Electronics/Misc/PRT_Raspi_Plate_V2.SLDPRT
76.0 x 3.00 x 85.0 mm
