ZacCac/MoXY-3D-Printer/CAD/Hardware/Linear Rails/PRT_HGR15.SLDPRT

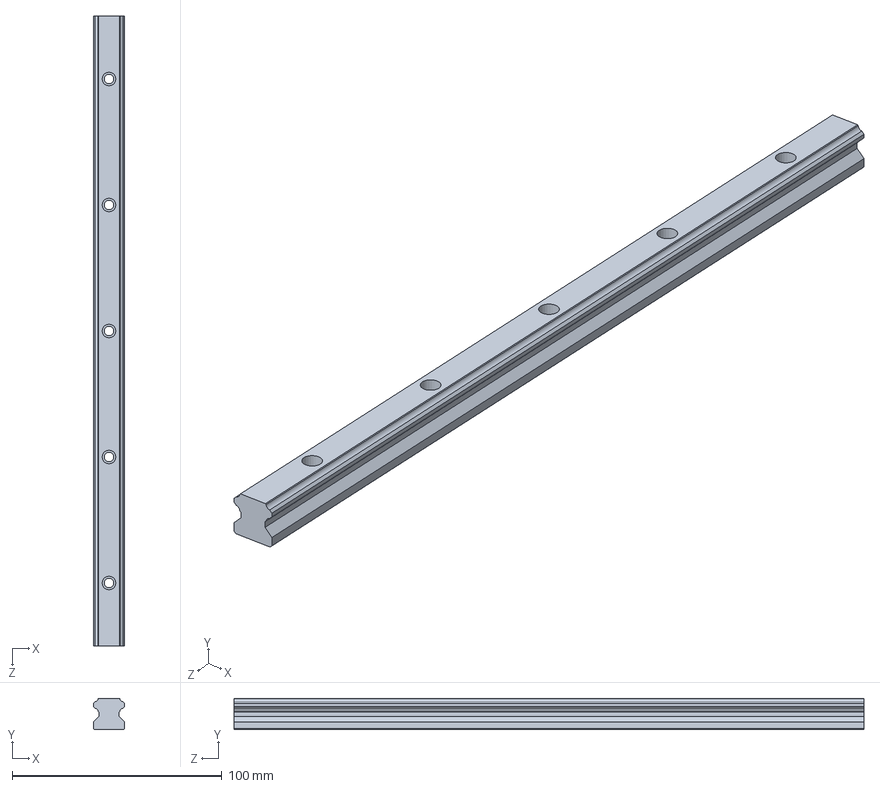
[picture p106: CAD file, 2024-07-14]
CAD/Hardware/Linear Rails/PRT_HGR15.SLDPRT
15.0 x 15.0 x 300.0 mm
