ZacCac/MoXY-3D-Printer/CAD/Hardware/Shafts/PRT_5x50mm_Shaft.SLDPRT

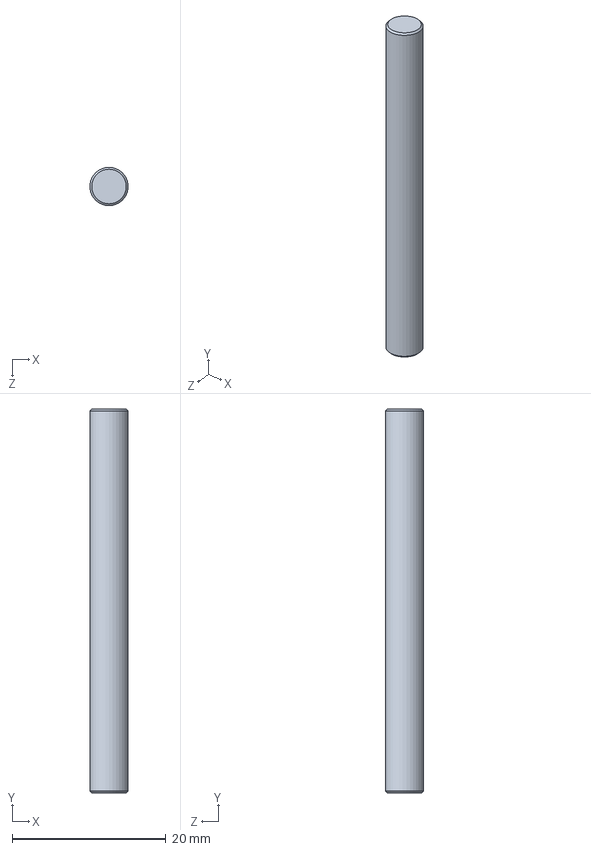
[picture p107: CAD file, 2024-08-31]
CAD/Hardware/Shafts/PRT_5x50mm_Shaft.SLDPRT
4.98 x 50.0 x 5.00 mm
