ZacCac/MoXY-3D-Printer/CAD/Components/Panels/PRT_Panel_Joint_V1.SLDPRT

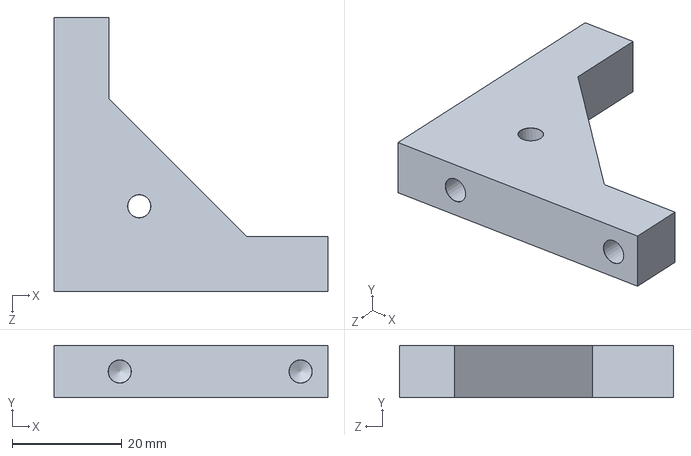
[picture p108: CAD file, 2024-07-14]
CAD/Components/Panels/PRT_Panel_Joint_V1.SLDPRT
50.0 x 9.53 x 50.0 mm
