ZacCac/MoXY-3D-Printer/CAD/Components/Printhead/PRT_MA_LDO_20mm_Nema14.SLDPRT

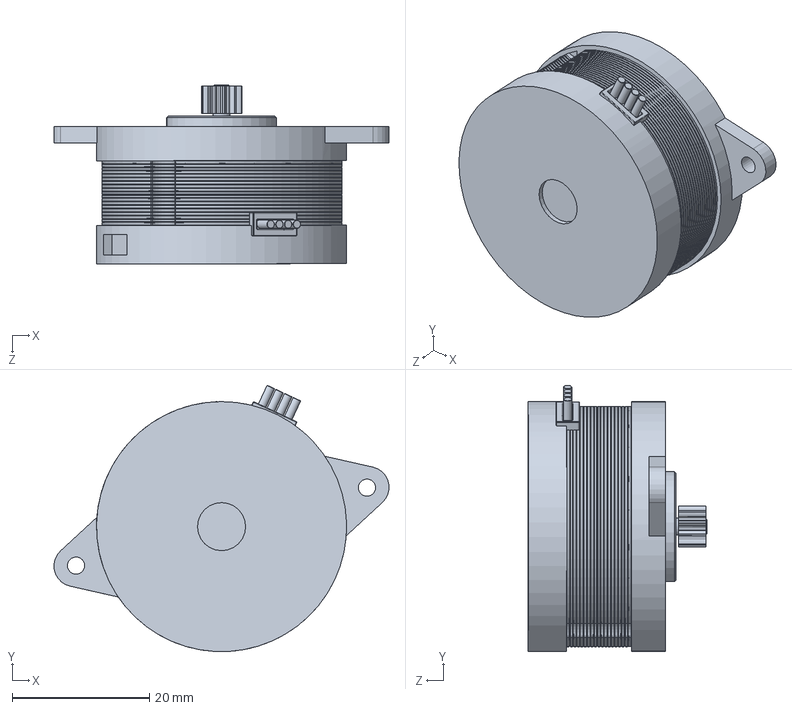
[picture p109: CAD file, 2024-07-28]
CAD/Components/Printhead/PRT_MA_LDO_20mm_Nema14.SLDPRT
48.8 x 38.8 x 26.0 mm
