ZacCac/MoXY-3D-Printer/CAD/Components/Printhead/temp/PRT_Moons_CSE14HRA2L4100_V1.SLDPRT

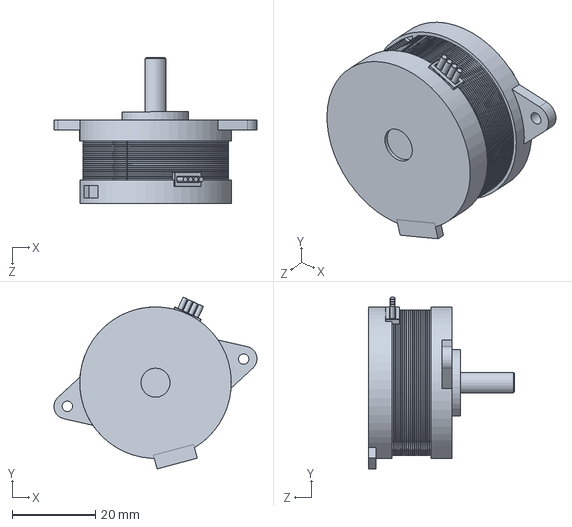
[picture p110: CAD file, 2024-11-27]
CAD/Components/Printhead/temp/PRT_Moons_CSE14HRA2L4100_V1.SLDPRT
48.8 x 41.3 x 35.0 mm
