ZacCac/MoXY-3D-Printer/CAD/Assemblies/ASM_X_Beam_V3.SLDASM

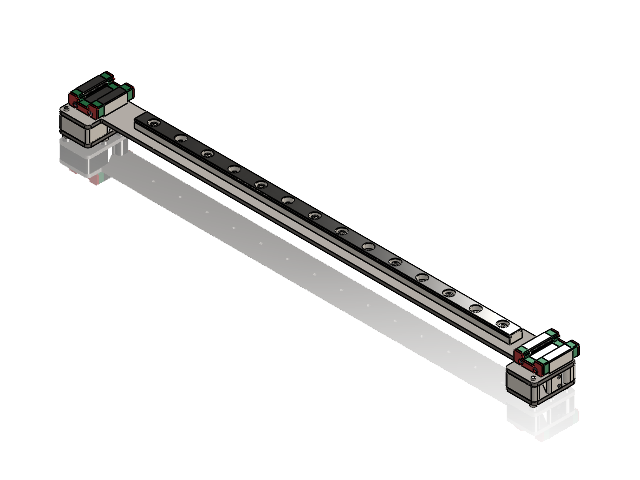
[picture p111: CAD file, 2025-02-01]
CAD/Assemblies/ASM_X_Beam_V3.SLDASM
PRT_XY_Backer_V5
PRT_MGN12H_Rail_350mm
PRT_SHCS_3x6mm x 8
PRT_MGN12C_Carriage x 2
PRT_XY_Block_V2 x 2
PRT_SHCS_3x20mm x 10
PRT_XY_Block_Spacer_V2 x 2
