ZacCac/MoXY-3D-Printer/CAD/Components/Bed/ASM_Kinematic_Carriage_Mirror_V3.SLDASM

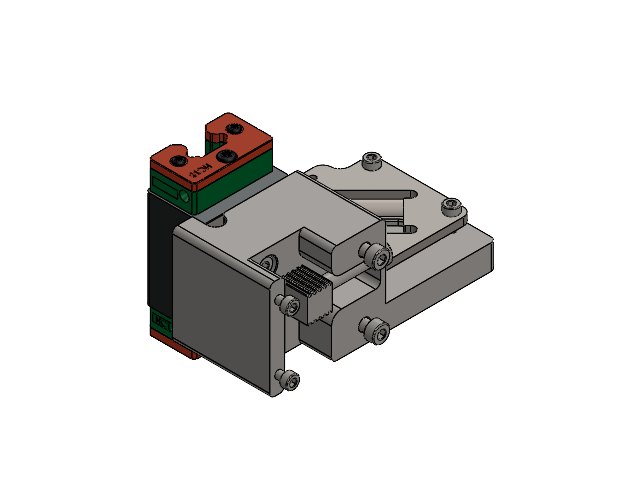
[picture p112: CAD file, 2024-12-06]
CAD/Components/Bed/ASM_Kinematic_Carriage_Mirror_V3.SLDASM
PRT_HGH15CC
PRT_Kinematic_Z_V3
PRT_SHCS_4x20mm x 2
PRT_SHCS_4x40mm x 2
PRT_SHCS_3x8mm x 2
PRT_5x22mm_Shaft x 2
PRT_Kinematic_Clamp_V1
PRT_SHCS_3x10mm x 4
PRT_SHCS_5x20mm
PRT_Z_Tensioner_V1
