ZacCac/MoXY-3D-Printer/CAD/Components/Gantry/ASM_XY_Transmission_V2.SLDASM

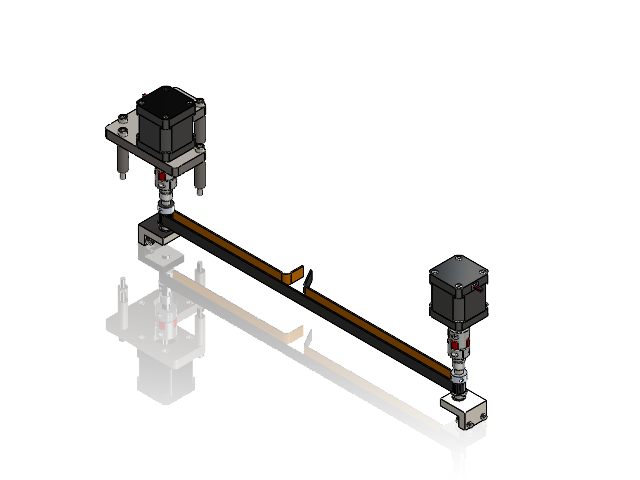
[picture p113: CAD file, 2025-02-01]
CAD/Components/Gantry/ASM_XY_Transmission_V2.SLDASM
PRT_NEMA17_17HS19-2004S1 x 2
PRT_Gates_2GT_20T_Toothed_Pulley_12mm_8mm-Bore x 2
PRT_XY_Belt_Path_V1
PRT_8x70mm_Shaft x 2
PRT_CPJC20-BL-5-8 x 2
PRT_5905K73_Needle-Roller Bearing_8mm x 4
PRT_Motor_Mount_V3
PRT_SHCS_3x12mm x 8
PRT_M5x30_Standoff_V1 x 4
PRT_SHCS_5x50mm x 4
PRT_Bearing_Block_Needle_V2 x 2
PRT_SHCS_5x12mm x 4
