ZacCac/MoXY-3D-Printer/CAD/Components/Accessories/ASM_PG11_Mount_V1.SLDASM

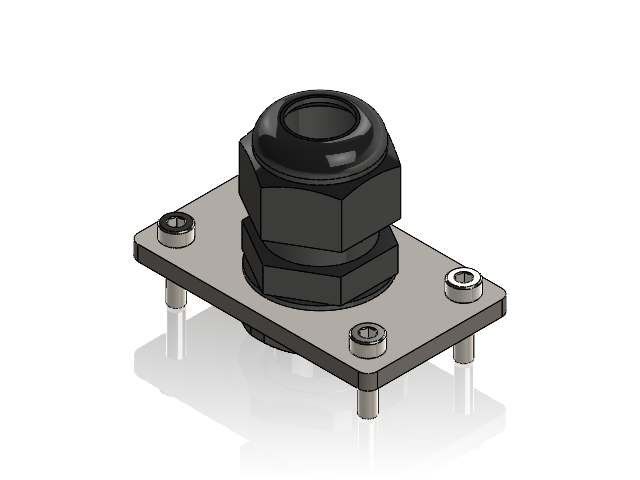
[picture p115: CAD file, 2024-07-29]
CAD/Components/Accessories/ASM_PG11_Mount_V1.SLDASM
PRT_PG11_Mount_V1
PRT_PG11_Gland
PRT_SHCS_3x12mm x 4
