ZacCac/MoXY-3D-Printer/CAD/Components/Panels/ASM_Panels_V2.SLDASM

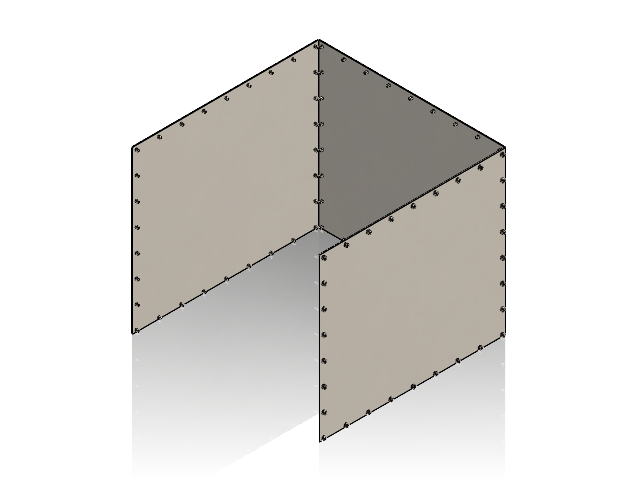
[picture p116: CAD file, 2024-09-27]
CAD/Components/Panels/ASM_Panels_V2.SLDASM
PRT_Side_Panel_V2 x 3
PRT_SHCS_5x8mm x 90
