ZacCac/MoXY-3D-Printer/CAD/Electronics/Connectors/ASM_Stepper_Connector_Mount_V1.SLDASM

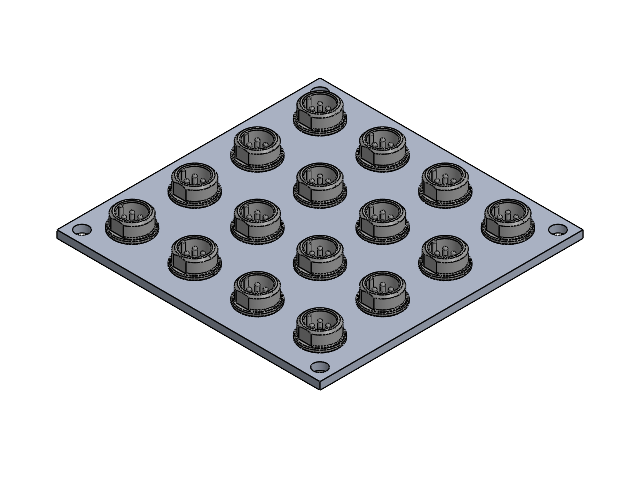
[picture p117: CAD file, 2024-12-02]
CAD/Electronics/Connectors/ASM_Stepper_Connector_Mount_V1.SLDASM
PRT_Stepper_Connector_Mount_V1
PRT_GX12_Jack_V1 x 16
