ZacCac/MoXY-3D-Printer/CAD/Assemblies/ASM_Bed_V2.SLDASM

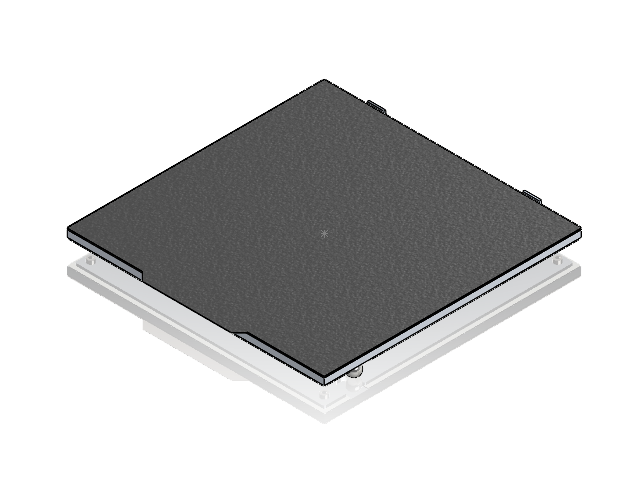
[picture p118: CAD file, 2024-12-02]
CAD/Assemblies/ASM_Bed_V2.SLDASM
PRT_MIC6_Bed_300_V2
PRT_Mica_Heater_V1
PRT_Bed_Magnet_V1
PRT_PEI_Sheet_V1
PRT_Buildplate_Stopper_V1 x 2
PRT_Heater_Clamp_V1
PRT_SHCS_3x8mm x 4
PRT_15mm_Kinematic_Ball_V1 x 3
PRT_SHCS_5x8mm x 5
