ZacCac/MoXY-3D-Printer/CAD/Components/Bed/ASM_Bearing_Block_Drive_V2.SLDASM

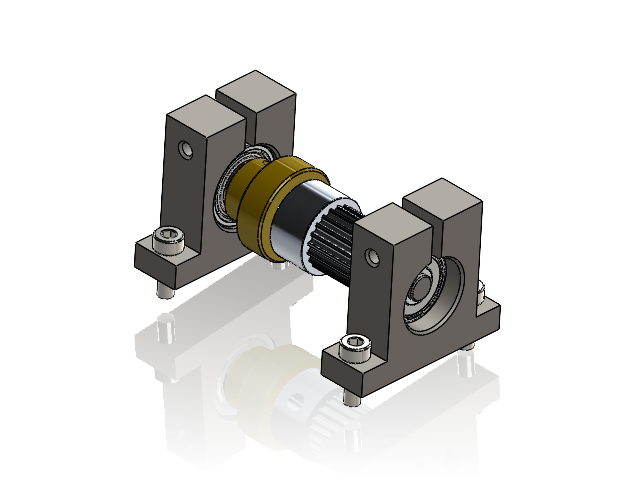
[picture p119: CAD file, 2024-12-02]
CAD/Components/Bed/ASM_Bearing_Block_Drive_V2.SLDASM
PRT_Bearing_Block_Worm_V1
PRT_625ZZ_Bearing x 2
PRT_SHCS_3x10mm x 4
PRT_SHCS_3x16mm x 2
PRT_Worm_Bearing_Block_Mirror_V1
PRT_5x50mm_Shaft
PRT_M5_1mm_Washer x 3
PRT_Gates_2GT_20T_Toothed_Pulley_12mm
PRT_Kyouiku_Gear_G80A20
