ZacCac/MoXY-3D-Printer/CAD/Components/Bed/ASM_Double_Kinematic_V1.SLDASM

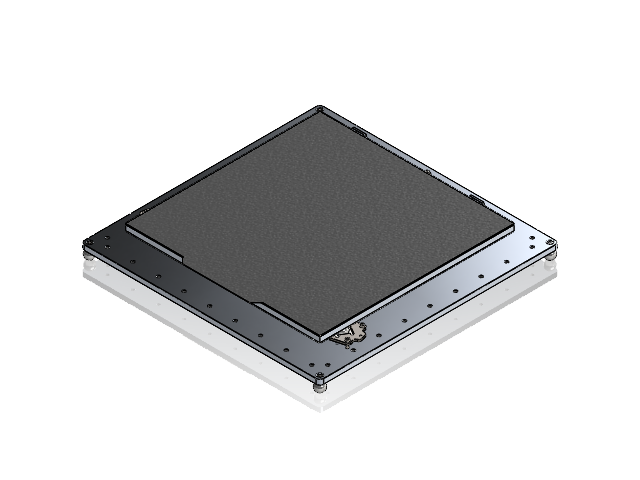
[picture p120: CAD file, 2024-12-02]
CAD/Components/Bed/ASM_Double_Kinematic_V1.SLDASM
PRT_Kinematic_Bed_Plate_V1
PRT_MIC6_Bed_300_V2
PRT_Mica_Heater_V1
PRT_Bed_Magnet_V1
PRT_PEI_Sheet_V1
PRT_Buildplate_Stopper_V1 x 2
PRT_Heater_Clamp_V1
PRT_SHCS_3x8mm x 4
PRT_15mm_Kinematic_Ball_V1 x 7
PRT_SHCS_5x8mm x 5
PRT_SHCS_4x8mm x 3
PRT_Kinematic_Clamp_V1 x 3
PRT_5x22mm_Shaft x 6
PRT_SHCS_4x16mm x 4
PRT_SHCS_3x10mm x 12
