ZacCac/MoXY-3D-Printer/CAD/Electronics/Misc/ASM_Raspi_DIN_V2.SLDASM

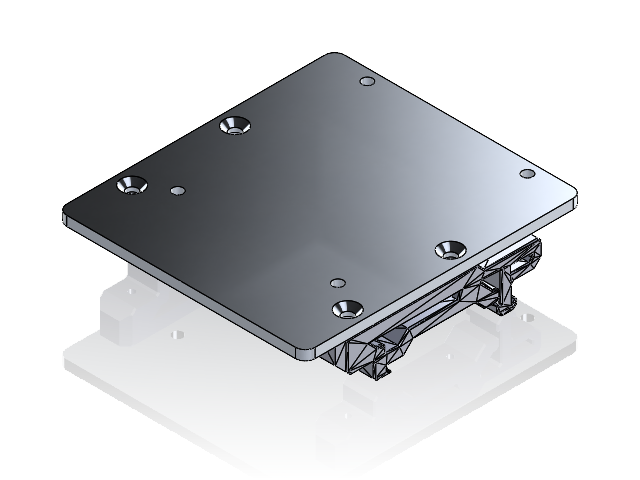
[picture p121: CAD file, 2024-10-11]
CAD/Electronics/Misc/ASM_Raspi_DIN_V2.SLDASM
PRT_Raspi_Plate_V2
PRT_DIN_Rail_Clip_V2 x 2
