ZacCac/MoXY-3D-Printer/CAD/Components/Printhead/temp/ASM_K1_Shaft_V2.SLDASM

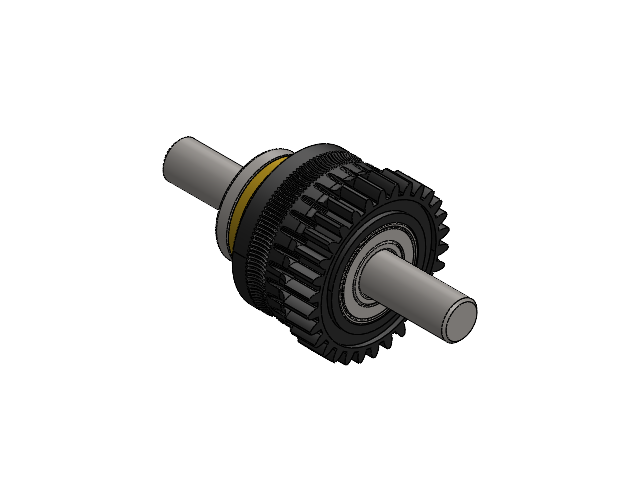
[picture p122: CAD file, 2024-11-19]
CAD/Components/Printhead/temp/ASM_K1_Shaft_V2.SLDASM
PRT_4x32mm_Shaft
PRT_K1_Hob_Gear_V1
PRT_684_Bearing_V1
PRT_MR84_Bearing_V1
PRT_7806K55_Thrust_Ball_Bearing_V1
