ZacCac/MoXY-3D-Printer/CAD/Electronics/Connectors/ASM_AC_Panel_V1.SLDASM

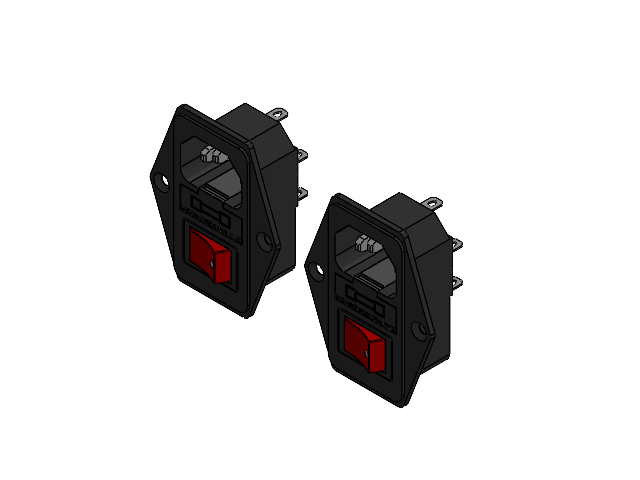
[picture p123: CAD file, 2024-12-02]
CAD/Electronics/Connectors/ASM_AC_Panel_V1.SLDASM
PRT_AC_Mount_V1
PRT_C14_and_Fuse_Panel_Mount_V1 x 2
