ZacCac/MoXY-3D-Printer/CAD/Components/Gantry/ASM_Bearing_Block_Needle_V2.SLDASM

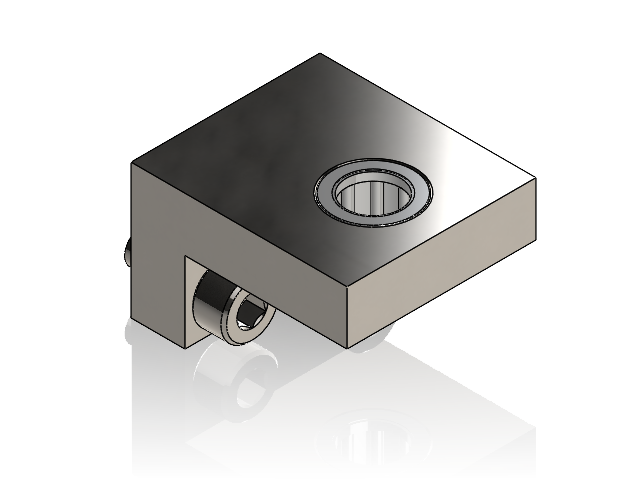
[picture p124: CAD file, 2024-11-04]
CAD/Components/Gantry/ASM_Bearing_Block_Needle_V2.SLDASM
PRT_Bearing_Block_Needle_V2
PRT_5905K73_Needle-Roller Bearing_8mm
PRT_SHCS_5x12mm x 2
