ZacCac/MoXY-3D-Printer/CAD/Electronics/Misc/ASM_Supernova_DIN_V2.SLDASM

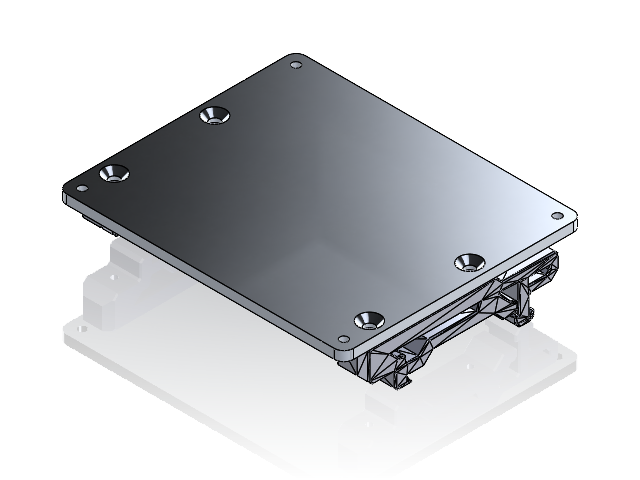
[picture p125: CAD file, 2024-10-10]
CAD/Electronics/Misc/ASM_Supernova_DIN_V2.SLDASM
PRT_Supernova_Plate_V2
PRT_DIN_Rail_Clip_V2 x 2
