ZacCac/MoXY-3D-Printer/CAD/Components/Bed/ASM_Motor_Slide_V2.SLDASM

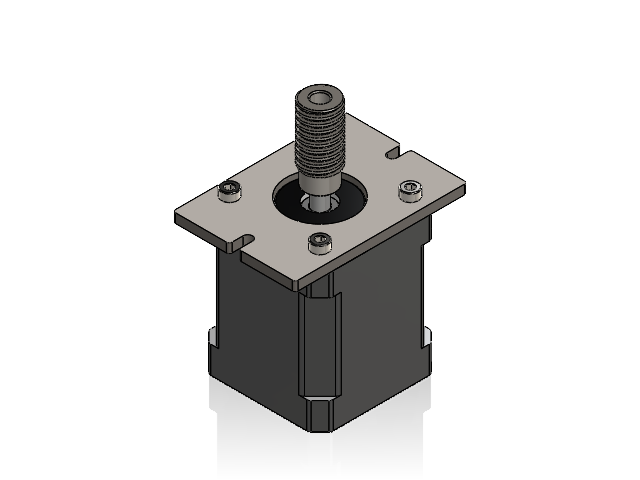
[picture p126: CAD file, 2024-12-02]
CAD/Components/Bed/ASM_Motor_Slide_V2.SLDASM
PRT_Z_Stepper_Plate_Mount_V3
PRT_LDO-42STH48-2504AC
PRT_SHCS_3x8mm x 4
PRT_Kyouiku_Gear_W80SUR1
