ZacCac/MoXY-3D-Printer/CAD/Components/Bed/ASM_Caster_Foot_V1.SLDASM

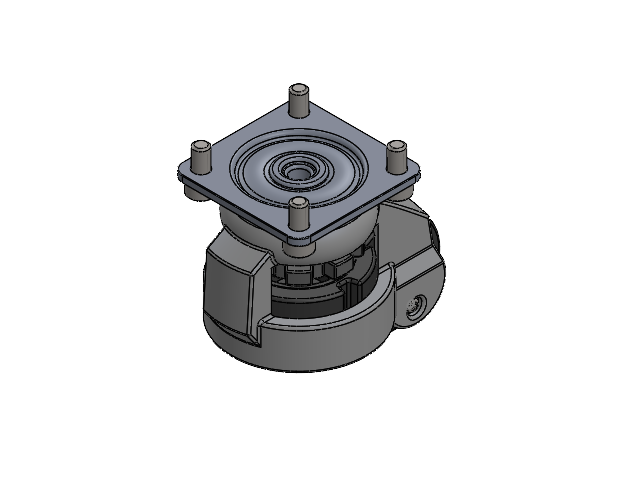
[picture p128: CAD file, 2024-12-02]
CAD/Components/Bed/ASM_Caster_Foot_V1.SLDASM
5475T12_Leveling Plate Caster
PRT_SHCS_6x12mm x 4
