ZacCac/MoXY-3D-Printer/CAD/Electronics/Misc/ASM_Mellow_D5_DIN_V1.SLDASM

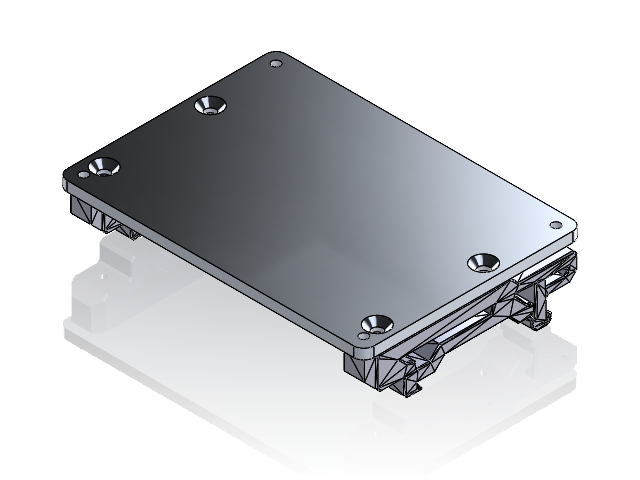
[picture p129: CAD file, 2024-10-10]
CAD/Electronics/Misc/ASM_Mellow_D5_DIN_V1.SLDASM
PRT_Mellow_D5_Plate_V1
PRT_DIN_Rail_Clip_V2 x 2
