ZacCac/MoXY-3D-Printer/CAD/Components/Bed/ASM_Worm_Bearing_Block_Mirror_V2.SLDASM

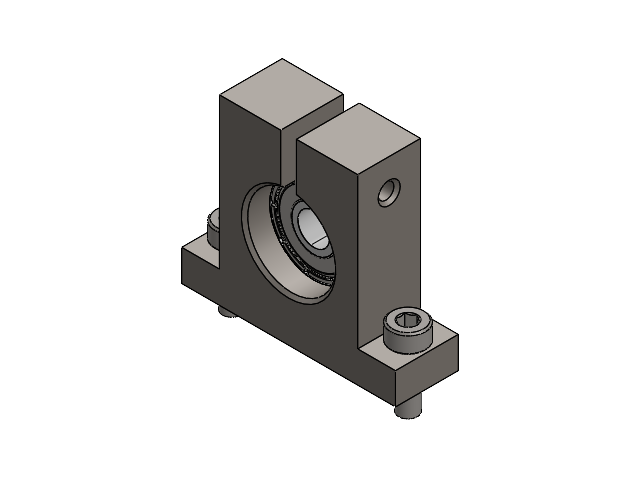
[picture p130: CAD file, 2024-11-04]
CAD/Components/Bed/ASM_Worm_Bearing_Block_Mirror_V2.SLDASM
PRT_Worm_Bearing_Block_Mirror_V1
PRT_625ZZ_Bearing
PRT_SHCS_3x10mm x 2
PRT_SHCS_3x16mm
