ZacCac/MoXY-3D-Printer/CAD/Components/Gantry/ASM_Bearing_Block_Needle_Mirror_V1.SLDASM

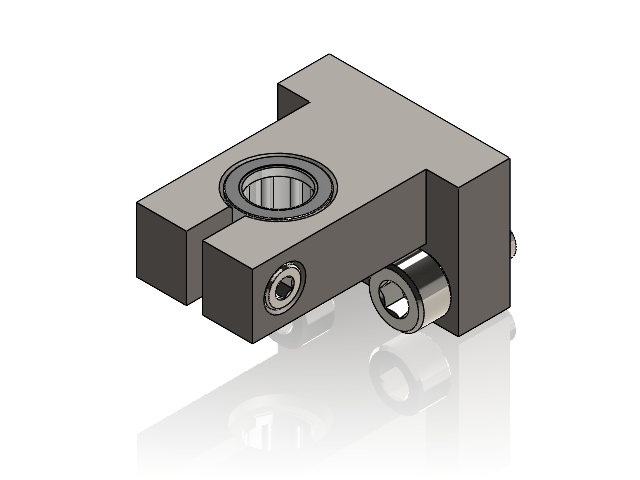
[picture p132: CAD file, 2024-09-25]
CAD/Components/Gantry/ASM_Bearing_Block_Needle_Mirror_V1.SLDASM
PRT_Bearing_Block_Needle_Mirror_V1
PRT_5905K73_Needle-Roller Bearing_8mm
PRT_SHCS_5x12mm x 2
PRT_SHCS_3x16mm
