ZacCac/MoXY-3D-Printer/CAD/Electronics/Misc/ASM_Filament_Sensor_V1.SLDASM

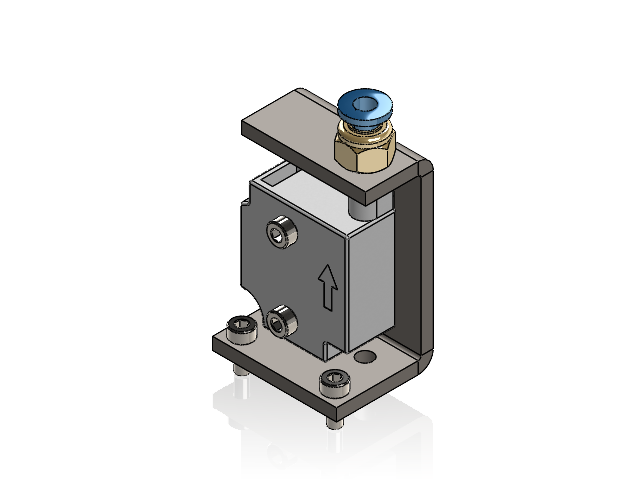
[picture p134: CAD file, 2024-07-29]
CAD/Electronics/Misc/ASM_Filament_Sensor_V1.SLDASM
PRT_Filament_Sensor_Plate_V1
PRT_Filament_Sensor_1.75mm
PRT_PC4-M10
PRT_M3_1mm_Washer x 4
PRT_SHCS_3x18mm x 2
PRT_SHCS_3x8mm x 2
