ZacCac/MoXY-3D-Printer/CAD/Electronics/Misc/ASM_Electronics_Panel_V1.SLDASM

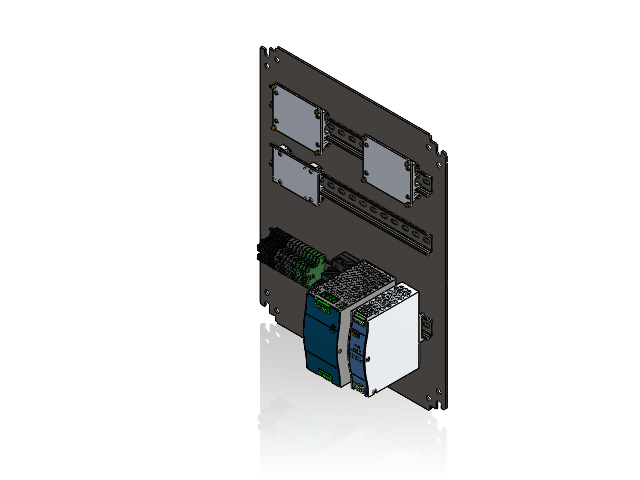
[picture p135: CAD file, 2024-07-19]
CAD/Electronics/Misc/ASM_Electronics_Panel_V1.SLDASM
PRT_Electronics_Panel_V1
PRT_DIN_Rail_35x7.5x300mm_V1 x 3
PRT_Supernova_Plate_V1 x 2
PRT_DIN_Clip_V1 x 6
PRT_M3-3_5mm_Standoff x 8
socket countersunk head screw_am x 12
PRT_NDR-240-48
PRT_NDR-75-24
PRT_HDR-30-5
PRT_Raspi_Plate_V1
socket head cap screw_am x 4
PRT_UK_2.5_Terminal_Block x 15
