ZacCac/MoXY-3D-Printer/CAD/Components/Gantry/ASM_Temp_Tensioning_V1.SLDASM

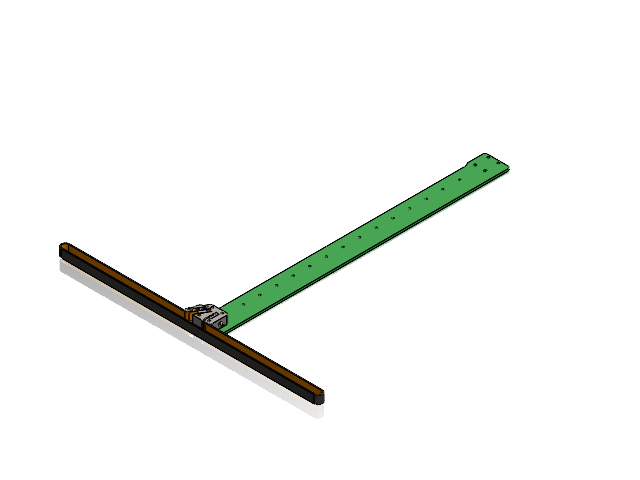
[picture p136: CAD file, 2024-07-18]
CAD/Components/Gantry/ASM_Temp_Tensioning_V1.SLDASM
PRT_XY_Tensioner_V1
PRT_XY_Belt_Path_V1
PRT_XY_Backer_V3
PRT_Static_Flat_Clamp_V1
PRT_SHCS_3x8mm
PRT_Static_Toothed_Clamp_V1
PRT_SHCS_3x25mm
PRT_SHCS_3x6mm
PRT_Static_Flat_Clamp_Long_V1
