ZacCac/MoXY-3D-Printer/CAD/Components/Printhead/Extruders/684-ZZ_1.SLDASM

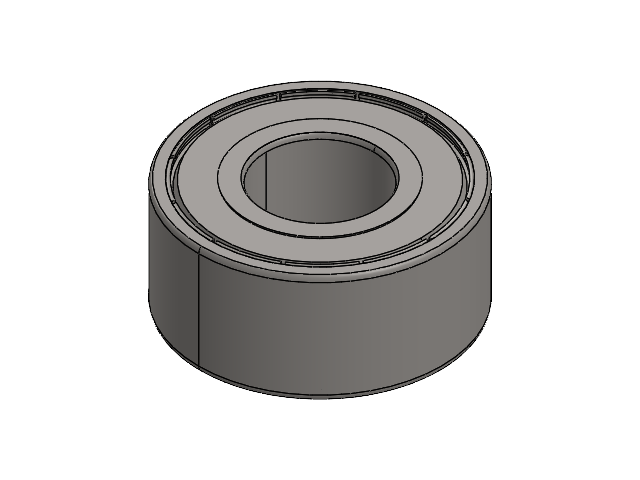
[picture p137: CAD file, 2024-07-28]
CAD/Components/Printhead/Extruders/684-ZZ_1.SLDASM
Circular Pattern 01.step_1
ball clamp-0.step_1
ball clamp-1.step_1
Circular Pattern 05.step_1
Circular Pattern 04.step_1
ball.step_1
Ball bearing - 684zz-2.step_1
Ball bearing - 684zz-3.step_1
