ZacCac/MoXY-3D-Printer/CAD/Components/Bed/ASM_Kinematic-1_V2.SLDASM

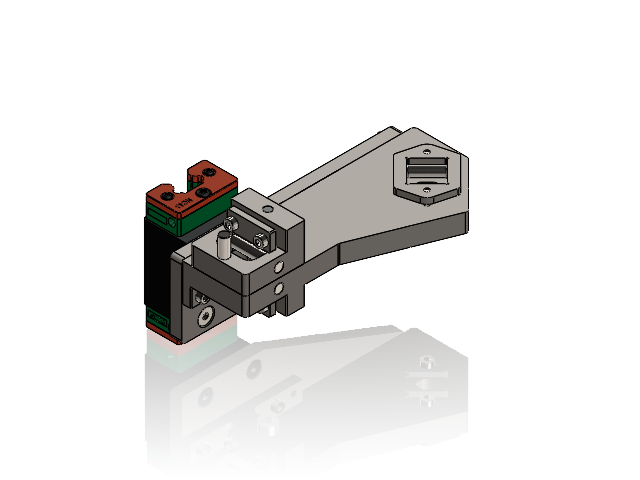
[picture p138: CAD file, 2024-09-10]
CAD/Components/Bed/ASM_Kinematic-1_V2.SLDASM
PRT_HGH15CC
PRT_Kinematic_Support_V1
PRT_Kinematic_Plate_Bottom_V2
PRT_5x15mm_Shaft x 2
PRT_Kinematic_Plate_Top_V1
PRT_Z_Belt_Clamp_V1 x 2
PRT_Z_Belt_Mount_Top_V2
PRT_5x30mm_Shaft x 3
PRT_SHCS_3x10mm x 4
PRT_SHCS_3x16mm x 6
PRT_SHCS_5x40mm
PRT_FHCS_4x12mm x 4
