ZacCac/MoXY-3D-Printer/CAD/Components/Bed/ASM_Z_Drive_Mirror_V1.SLDASM

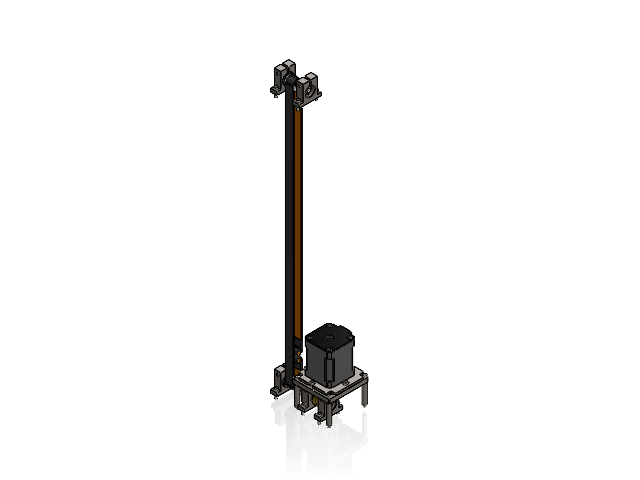
[picture p139: CAD file, 2024-09-10]
CAD/Components/Bed/ASM_Z_Drive_Mirror_V1.SLDASM
PRT_Worm_Bearing_Block_V1 x 3
PRT_625ZZ_Bearing x 5
PRT_SHCS_3x12mm x 10
PRT_SHCS_3x16mm x 5
PRT_Worm_Bearing_Block_Mirror_V1 x 2
PRT_M5_1mm_Washer x 6
PRT_5x75mm_Shaft
PRT_Gates_2GT_20T_Toothed_Pulley_12mm x 2
PRT_Kyouiku_Gear_G80A20
PRT_Z_Stepper_Plate_V2
PRT_M3x30_Spacer_V1 x 4
PRT_Z_Stepper_Plate_Mount_V1
PRT_LDO-42STH48-2504AC
PRT_Kyouiku_Gear_W80SUR1
PRT_SHCS_3x6mm x 4
PRT_SHCS_3x40mm x 4
PRT_SHCS_3x8mm x 3
PRT_Z_Belt_Path_V2
PRT_5x40mm_Shaft
