ZacCac/MoXY-3D-Printer/CAD/Components/Bed/ASM_Motor_Slide_Mirror_V1.SLDASM

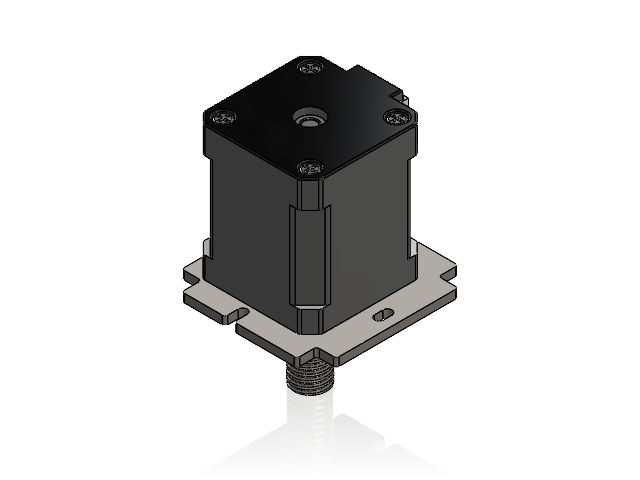
[picture p140: CAD file, 2024-08-31]
CAD/Components/Bed/ASM_Motor_Slide_Mirror_V1.SLDASM
PRT_Z_Stepper_Plate_Mount_V1
PRT_LDO-42STH48-2504AC
PRT_Kyouiku_Gear_W80SUR1
PRT_SHCS_3x6mm x 4
