ZacCac/MoXY-3D-Printer/(list of files, cad)

Other CAD files:
CAD/Components/Printhead/Extruders/Ball bearing - 684zz.step_1.SLDASM
CAD/Components/Printhead/Extruders/brass ring.step_1.SLDASM
CAD/Components/Printhead/Extruders/Lowboi Mk4 Assy - Orbiter 2.0 Mounting - 2 Start.SLDASM
CAD/Components/Printhead/Extruders/ball clamp.step_1.SLDASM
CAD/Components/Printhead/Extruders/684-ZZ.step_1.SLDASM
CAD/Components/Bed/ASM_Bearing_Block_Mirror_V1.SLDASM
CAD/Components/Gantry/ASM_Bearing_Block_8mm_Mirror_V1.SLDASM
CAD/Components/Bed/ASM_Kinematic-4_V2.SLDASM
CAD/Electronics/Endstops and Probes/EE_SPX740.SLDPRT
CAD/Hardware/Linear Rails/PRT_MGN12H_Rail_350mm.SLDPRT
CAD/Components/Frame/PRT_Base_Plate_V1.SLDPRT
CAD/Components/Printhead/Extruders/ball.step_1.SLDPRT
CAD/Assemblies/ASM_Bed_V1.SLDASM
CAD/Assemblies/ASM_Gantry_V1.SLDASM
CAD/Assemblies/ASM_Gantry_V2.SLDASM
CAD/Assemblies/ASM_Gantry_V3.SLDASM
CAD/Assemblies/ASM_X_Beam_V1.SLDASM
CAD/Assemblies/ASM_X_Beam_V2.SLDASM
CAD/Assemblies/ASM_Y_Beam_V1.SLDASM
CAD/Assemblies/ASM_Y_Beam_V2.SLDASM
CAD/Components/Bed/ASM_Bearing_Block_Drive_Mirror_V1.SLDASM
CAD/Components/Bed/ASM_Bearing_Block_Drive_V1.SLDASM
CAD/Components/Bed/ASM_HGR15_Screws_V1.SLDASM
CAD/Components/Bed/ASM_Kinematic_Carriage_V1.SLDASM
CAD/Components/Bed/ASM_Kinematic_Carriage_V2.SLDASM
CAD/Components/Bed/ASM_Motor_Slide_V1.SLDASM
CAD/Components/Bed/ASM_Worm_Bearing_Block_Mirror_V1.SLDASM
CAD/Components/Bed/ASM_Worm_Bearing_Block_V1.SLDASM
CAD/Components/Bed/PRT_1598K32_Hardened Bearing_440C_V1.SLDPRT
CAD/Components/Bed/PRT_15mm_Kinematic_Ball_V1.SLDPRT
CAD/Components/Bed/PRT_6527K373_Low-Carbon Steel Rectangular Tube.SLDPRT
CAD/Components/Bed/PRT_Bearing_Block_Worm_V1.SLDPRT
CAD/Components/Bed/PRT_Bed_Magnet_V1.SLDPRT
CAD/Components/Bed/PRT_Buildplate_Stopper_V1.SLDPRT
CAD/Components/Bed/PRT_Heater_240x240.SLDPRT
CAD/Components/Bed/PRT_Heater_Clamp_V1.SLDPRT
CAD/Components/Bed/PRT_Kinematic_Bed_Plate_V1.SLDDRW
CAD/Components/Bed/PRT_Kinematic_Bed_Plate_V1.SLDPRT
CAD/Components/Bed/PRT_Kinematic_Clamp_V1.SLDPRT
CAD/Components/Bed/PRT_Kinematic_Mockup_V1.SLDPRT
CAD/Components/Bed/PRT_Kinematic_Plate_Bottom_Mirror_V2.SLDPRT
CAD/Components/Bed/PRT_Kinematic_Plate_Bottom_V2.SLDPRT
CAD/Components/Bed/PRT_Kinematic_Plate_Top_V1.SLDPRT
CAD/Components/Bed/PRT_Kinematic_Spring_Steel_V1.SLDPRT
CAD/Components/Bed/PRT_Kinematic_Support_Mirror_V1.SLDPRT
CAD/Components/Bed/PRT_Kinematic_Support_V1.SLDPRT
CAD/Components/Bed/PRT_Kinematic_Z_Mirror_V1.SLDPRT
CAD/Components/Bed/PRT_Kinematic_Z_Mirror_V2.SLDPRT
CAD/Components/Bed/PRT_Kinematic_Z_V3.SLDDRW
CAD/Components/Bed/PRT_Kinematic_Z_V3.SLDPRT
CAD/Components/Bed/PRT_Kinematic_Z_V3_OLD.SLDPRT
CAD/Components/Bed/PRT_L_Bracket.SLDPRT
CAD/Components/Bed/PRT_L_Bracket_V2.SLDPRT
CAD/Components/Bed/PRT_MIC6_Bed_300_V1.SLDPRT
CAD/Components/Bed/PRT_MIC6_Bed_300_V2.SLDDRW
CAD/Components/Bed/PRT_MIC6_Bed_300_V2.SLDPRT
CAD/Components/Bed/PRT_Mica_Heater_V1.SLDPRT
CAD/Components/Bed/PRT_PEI_Sheet_V1.SLDPRT
CAD/Components/Bed/PRT_Square_Tube_1.5x0.120_V1.SLDPRT
CAD/Components/Bed/PRT_Square_Tube_1.5x0.120_V2.SLDPRT
CAD/Components/Bed/PRT_Temp_Z_Spacer.SLDPRT
CAD/Components/Bed/PRT_Vertical_Beam_V1.SLDDRW
CAD/Components/Bed/PRT_Vertical_Beam_V1.SLDPRT
CAD/Components/Bed/PRT_Worm_Bearing_Block_Mirror_V1.SLDPRT
CAD/Components/Bed/PRT_Worm_Bearing_Block_V1.SLDDRW
CAD/Components/Bed/PRT_Z_Belt_Block_Bottom_V1.SLDPRT
CAD/Components/Bed/PRT_Z_Belt_Clamp_V1.SLDPRT
CAD/Components/Bed/PRT_Z_Belt_Cover_V1.SLDPRT
CAD/Components/Bed/PRT_Z_Belt_Mount_Bottom_V1.SLDPRT
CAD/Components/Bed/PRT_Z_Belt_Mount_Top_Mirror_V2.SLDPRT
CAD/Components/Bed/PRT_Z_Belt_Mount_Top_V1.SLDPRT
CAD/Components/Bed/PRT_Z_Belt_Mount_Top_V2.SLDPRT
CAD/Components/Bed/PRT_Z_Belt_Path_V1.SLDPRT
CAD/Components/Bed/PRT_Z_Belt_Path_V2.SLDPRT
CAD/Components/Bed/PRT_Z_Belt_Path_V3.SLDPRT
CAD/Components/Bed/PRT_Z_Belt_Path_V4.SLDPRT
CAD/Components/Bed/PRT_Z_Carriage_Mount_SCS_V1.SLDPRT
CAD/Components/Bed/PRT_Z_Carriage_Mount_V1.SLDPRT
CAD/Components/Bed/PRT_Z_Frame_SCS_V2.SLDPRT
CAD/Components/Bed/PRT_Z_Frame_V1.SLDPRT
CAD/Components/Bed/PRT_Z_Frame_V2.SLDDRW
CAD/Components/Bed/PRT_Z_Frame_V2.SLDPRT
CAD/Components/Bed/PRT_Z_Stepper_Plate_Mount_V1.SLDPRT
CAD/Components/Bed/PRT_Z_Stepper_Plate_Mount_V2.SLDPRT
CAD/Components/Bed/PRT_Z_Stepper_Plate_Mount_V3.SLDPRT
CAD/Components/Bed/PRT_Z_Stepper_Plate_V1.SLDPRT
CAD/Components/Bed/PRT_Z_Stepper_Plate_V2.SLDPRT
CAD/Components/Bed/PRT_Z_Tensioner_V1.SLDDRW
CAD/Components/Bed/PRT_Z_Tensioner_V1.SLDPRT
CAD/Components/Gantry/ASM_Bearing_Block_Needle_V1.SLDASM
CAD/Components/Gantry/ASM_MGN12_and_Screws_V1.SLDASM
CAD/Components/Gantry/ASM_Motor_Mount_and_Screws_V1.SLDASM
CAD/Components/Gantry/ASM_Motor_Mount_and_Screws_V2.SLDASM
CAD/Components/Gantry/ASM_XY_Transmission_V1.SLDASM
CAD/Components/Gantry/PRT_Bearing_Block_8mm_Mirror_V1.SLDPRT
CAD/Components/Gantry/PRT_Bearing_Block_8mm_V1.SLDPRT
CAD/Components/Gantry/PRT_Bearing_Block_Needle_Mirror_V1.SLDPRT
CAD/Components/Gantry/PRT_Bearing_Block_Needle_V1.SLDPRT
CAD/Components/Gantry/PRT_Bearing_Block_Needle_V2.SLDDRW
CAD/Components/Gantry/PRT_Bearing_Block_Needle_V2.SLDPRT
CAD/Components/Gantry/PRT_Gantry_Main_Plate_V1.SLDPRT
CAD/Components/Gantry/PRT_Gantry_Main_Plate_V2.SLDPRT
CAD/Components/Gantry/PRT_Gantry_Main_Plate_V3.SLDPRT
CAD/Components/Gantry/PRT_Gantry_Main_Plate_V4.SLDPRT
CAD/Components/Gantry/PRT_Gantry_Main_Plate_V5.SLDPRT
CAD/Components/Gantry/PRT_Gantry_Main_Plate_V6.SLDDRW
CAD/Components/Gantry/PRT_Gantry_Main_Plate_V6.SLDPRT
CAD/Components/Gantry/PRT_Gantry_Main_Plate_V7.SLDPRT
CAD/Components/Gantry/PRT_Gantry_Main_Plate_V8.SLDDRW
CAD/Components/Gantry/PRT_Motor_Mount_SCS_V2.SLDPRT
CAD/Components/Gantry/PRT_Motor_Mount_V1.SLDPRT
CAD/Components/Gantry/PRT_Motor_Mount_V2.SLDPRT
CAD/Components/Gantry/PRT_Motor_Mount_V3.SLDPRT
CAD/Components/Gantry/PRT_Static_Flat_Clamp_Long_V1.SLDPRT
CAD/Components/Gantry/PRT_Static_Flat_Clamp_V1.SLDPRT
CAD/Components/Gantry/PRT_Static_Toothed_Clamp_V1.SLDDRW
CAD/Components/Gantry/PRT_Static_Toothed_Clamp_V1.SLDPRT
CAD/Components/Gantry/PRT_Tensioner_Spacer_V1.SLDPRT
CAD/Components/Gantry/PRT_XY_Backer_V1.SLDPRT
CAD/Components/Gantry/PRT_XY_Backer_V2.SLDPRT
CAD/Components/Gantry/PRT_XY_Backer_V3.SLDPRT
CAD/Components/Gantry/PRT_XY_Backer_V4.SLDPRT
CAD/Components/Gantry/PRT_XY_Backer_V5.SLDPRT
CAD/Components/Gantry/PRT_XY_Belt_Path_V1.SLDPRT
CAD/Components/Gantry/PRT_XY_Block_Skeletonized_V2.SLDPRT
CAD/Components/Gantry/PRT_XY_Block_V2.SLDDRW
CAD/Components/Gantry/PRT_XY_Tensioner_V1.SLDPRT
CAD/Components/Gantry/PRT_temp_backer_spacer.SLDPRT
CAD/Components/Panels/ASM_Panels_V1.SLDASM
CAD/Components/Panels/PRT_Front_Panel_V1.SLDPRT
CAD/Components/Printhead/Chube_Extruder_Spacer_V1.SLDPRT
CAD/Components/Printhead/Extruders/01 Button Head (table)_M03 X 010_1.SLDPRT
CAD/Components/Printhead/Extruders/01 Cap Head (table)_M03 X 12_1.SLDPRT
CAD/Components/Printhead/Extruders/01 Washer Flat (table)_M3_1.SLDPRT
CAD/Components/Printhead/Extruders/Ball bearing - 684zz-2.step_1.SLDPRT
CAD/Components/Printhead/Extruders/Ball bearing - 684zz-3.step_1.SLDPRT
CAD/Components/Printhead/Extruders/Circular Pattern 01.step_1.SLDPRT
CAD/Components/Printhead/Extruders/Circular Pattern 04.step_1.SLDPRT
CAD/Components/Printhead/Extruders/Circular Pattern 05.step_1.SLDPRT
CAD/Components/Printhead/Extruders/Clamp Clip_Default_As Machined__1.SLDPRT
CAD/Components/Printhead/Extruders/Collar_Default_As Machined__1.SLDPRT
CAD/Components/Printhead/Extruders/Drive Shaft 4mm GCR15_1.SLDPRT
CAD/Components/Printhead/Extruders/Idler Shaft 3mm GCR15_1.SLDPRT
CAD/Components/Printhead/Extruders/K1 Hob Gear_1.SLDPRT
CAD/Components/Printhead/Extruders/KHK SW0.5-R2_1.SLDPRT
CAD/Components/Printhead/Extruders/Lowboi Mk4 Bearing Spacer_Default_As Machined__1.SLDPRT
CAD/Components/Printhead/Extruders/Lowboi Mk4 Body - 2 start KHK_Orbiter 2.0 Mounting_1.SLDPRT
CAD/Components/Printhead/Extruders/Lowboi Mk4 Latch_Default_As Machined__1.SLDPRT
CAD/Components/Printhead/Extruders/M3 4 x 3 brass melt Insert_1.SLDPRT
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
