ZacCac/MoXY-3D-Printer/CAD/Drawings/Waterjet Parts/PRT_Buildplate_Stopper_V1.pdf

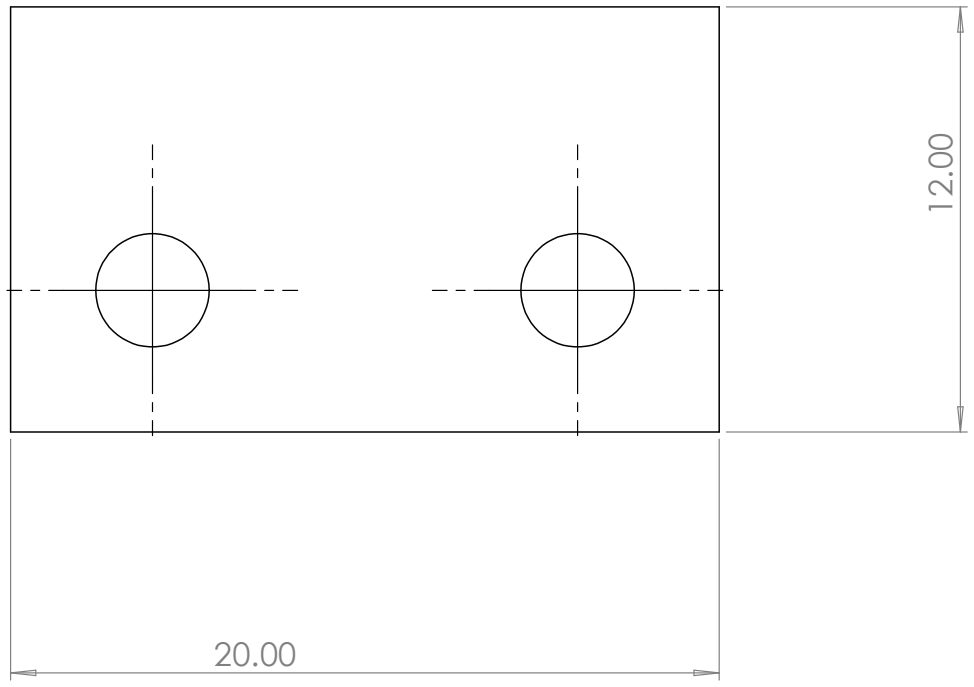
[picture p141: figure]

SOLIDWORKS Educational Product. For Instructional Use Only.
