ZacCac/MoXY-3D-Printer/CAD/Drawings/Waterjet Parts 5/PDF_Motor_Mount_V3.pdf

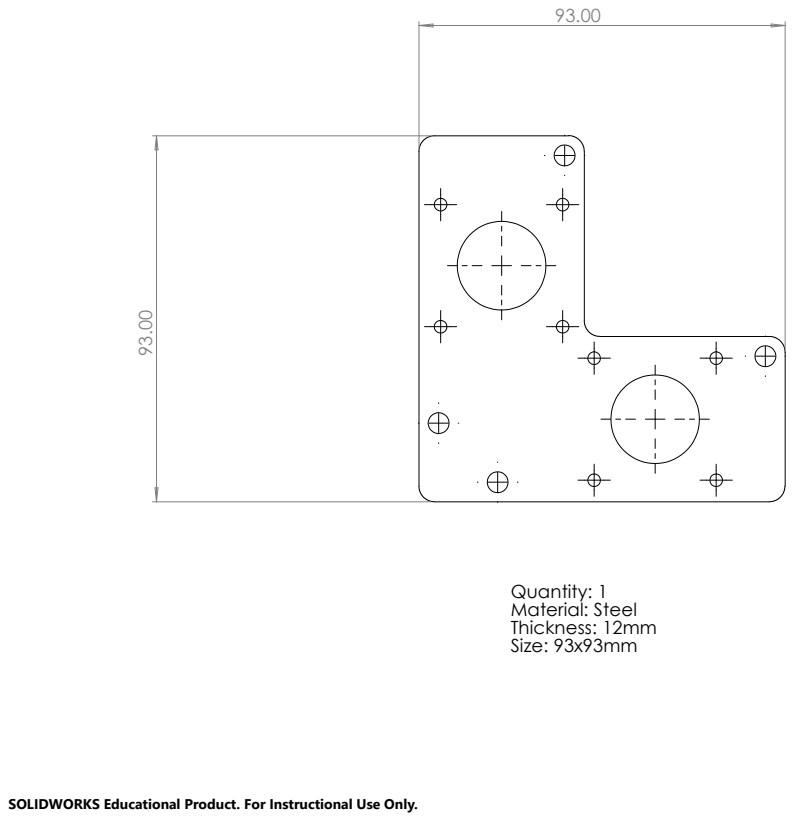
[picture p142: page 1]
Quantity: 1 Material: Steel Thickness: 12mm Size: 93x93mm

SOLIDWORKS Educational Product. For Instructional Use Only.
