ZacCac/MoXY-3D-Printer/CAD/Drawings/Waterjet Parts 5/PDF_Static_Toothed_Clamp_V2.pdf

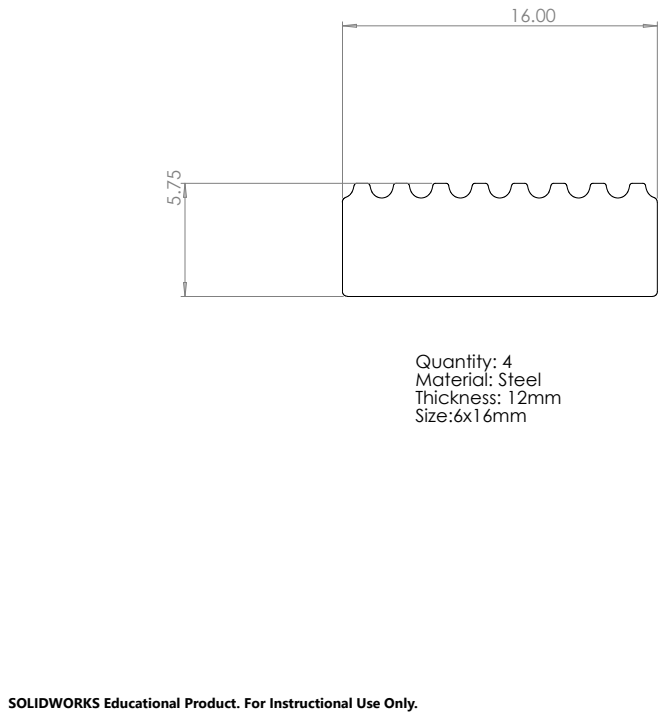
[picture p143: page 1]
Quantity: 4 Material: Steel Thickness: 12mm Size:6x16mm

SOLIDWORKS Educational Product. For Instructional Use Only.
