ZacCac/MoXY-3D-Printer/CAD/Drawings/Waterjet Parts 5/PDF_XY_Block_V2.pdf

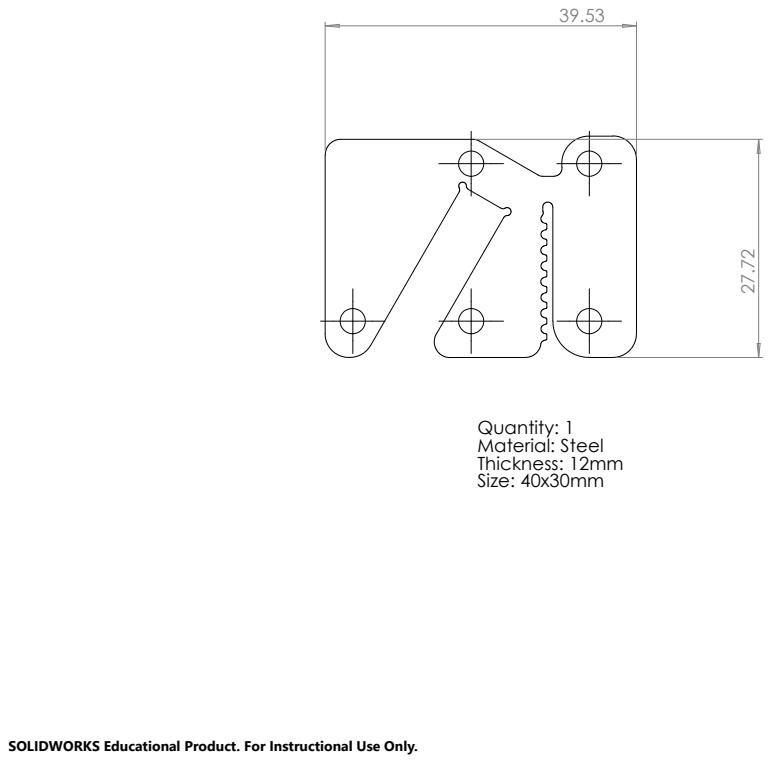
[picture p144: page 1]
Quantity: 1 Material: Steel Thickness: 12mm Size: 40x30mm

SOLIDWORKS Educational Product. For Instructional Use Only.
