ZacCac/MoXY-3D-Printer/CAD/Drawings/Waterjet Parts 5/PDF_Z_Tensioner_V2.pdf

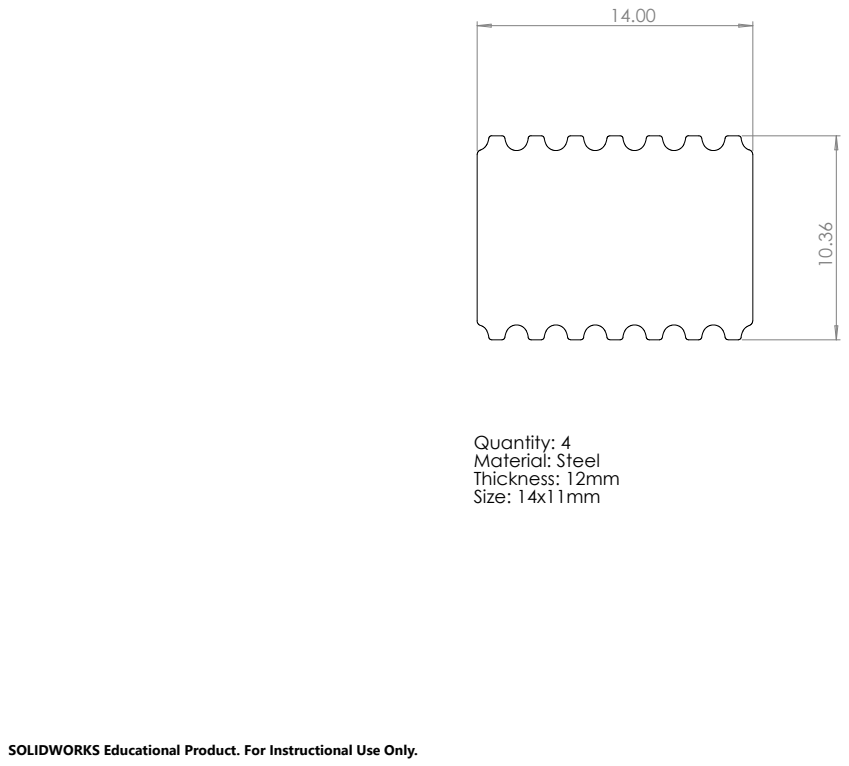
[picture p145: page 1]
Quantity: 4 Material: Steel Thickness: 12mm Size: 14x11mm

SOLIDWORKS Educational Product. For Instructional Use Only.
