ZacCac/MoXY-3D-Printer/CAD/Drawings/Waterjet Parts 4/PDF_AC_Mount_V1.pdf

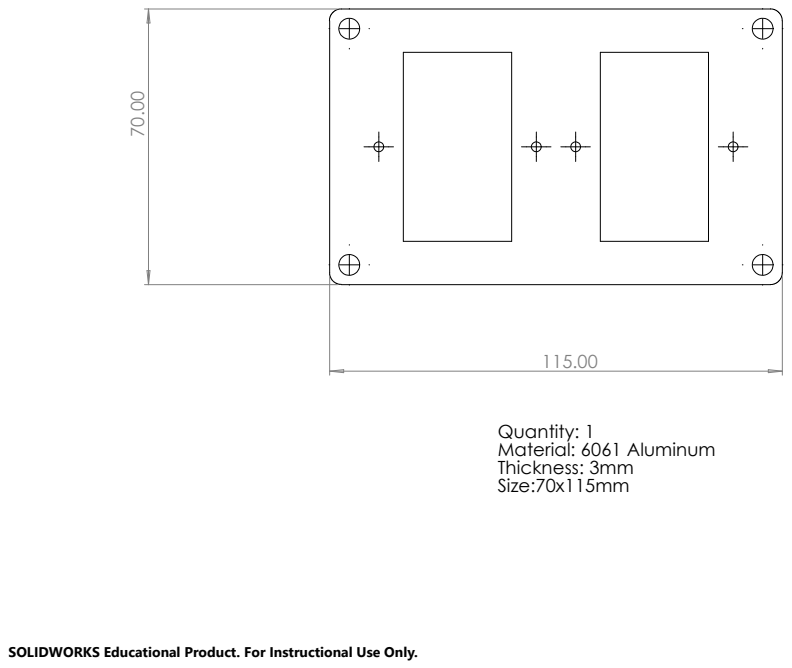
[picture p146: page 1]
Quantity: 1 Material: 6061 Aluminum Thickness: 3mm Size:70x115mm

SOLIDWORKS Educational Product. For Instructional Use Only.
