ZacCac/MoXY-3D-Printer/CAD/Drawings/Waterjet Parts 4/PDF_Back_Wiring_Panel_V1.pdf

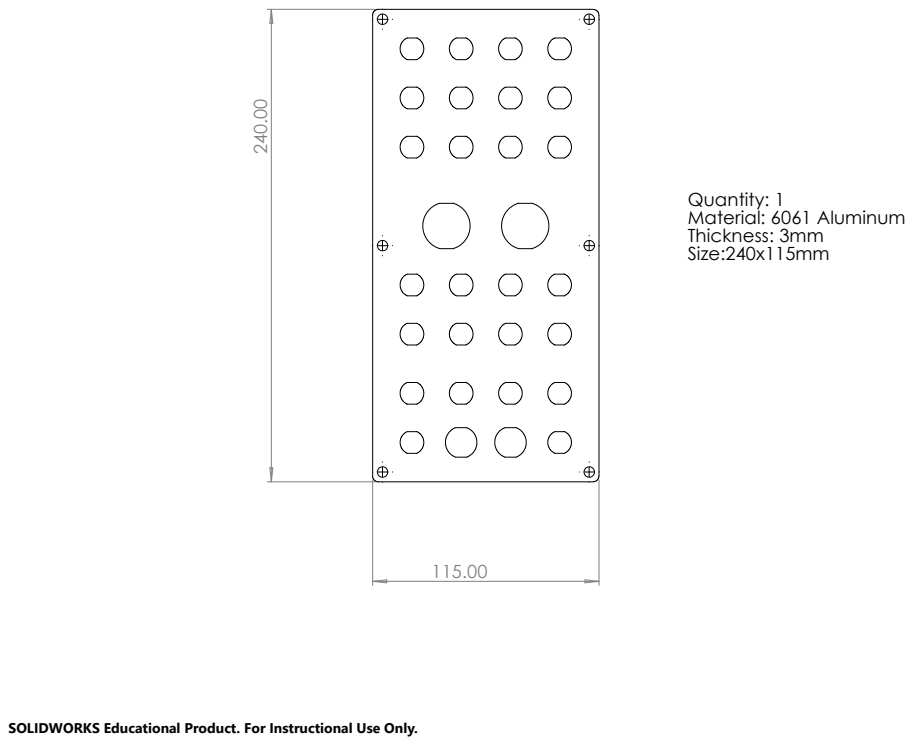
[picture p147: page 1]
Quantity: 1 Material: 6061 Aluminum Thickness: 3mm; Size:240x115mm ²⁴⁰.00

SOLIDWORKS Educational Product. For Instructional Use Only.
