ZacCac/MoXY-3D-Printer/CAD/Drawings/Waterjet Parts 4/PDF_PG11_Mount_V1.pdf

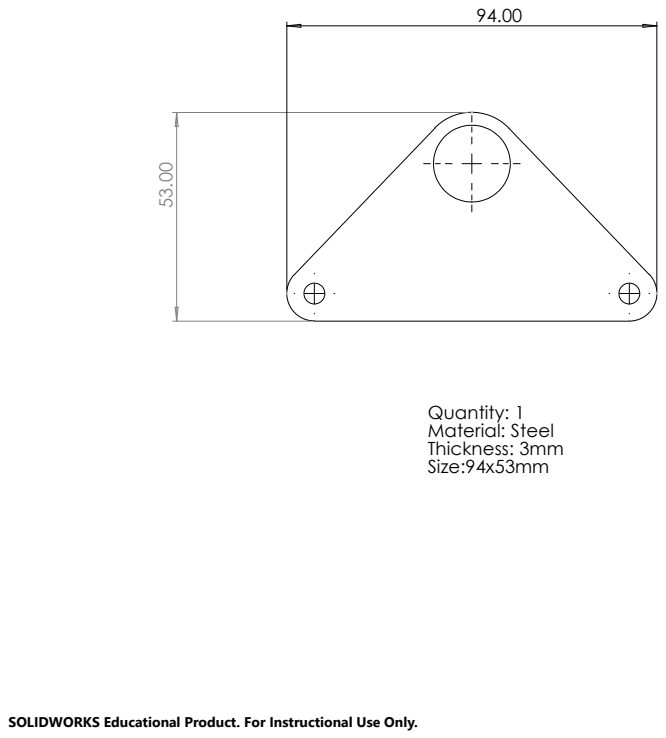
[picture p148: page 1]
Quantity: 1 Material: Steel Thickness: 3mm Size:94x53mm

SOLIDWORKS Educational Product. For Instructional Use Only.
