ZacCac/MoXY-3D-Printer/CAD/Drawings/Waterjet Parts 4/PDF_XY_Backer_V5.pdf

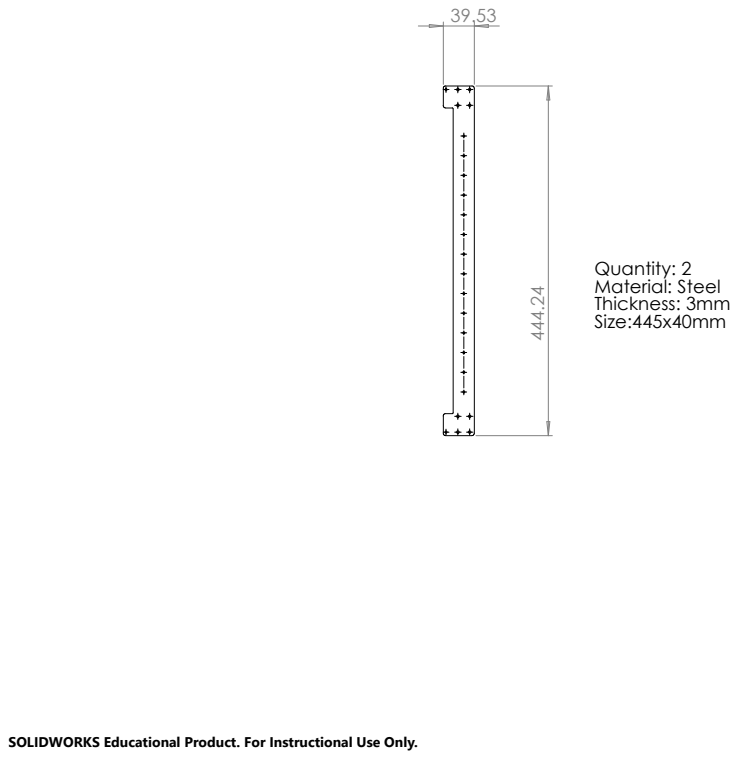
[picture p149: page 1]
Quantity: 2 Material: Steel Thickness: 3mm; Size:445x40mm 444.24

SOLIDWORKS Educational Product. For Instructional Use Only.
