ZacCac/MoXY-3D-Printer/CAD/Drawings/Waterjet Parts 4/PDF_XY_Spacer_V2.pdf

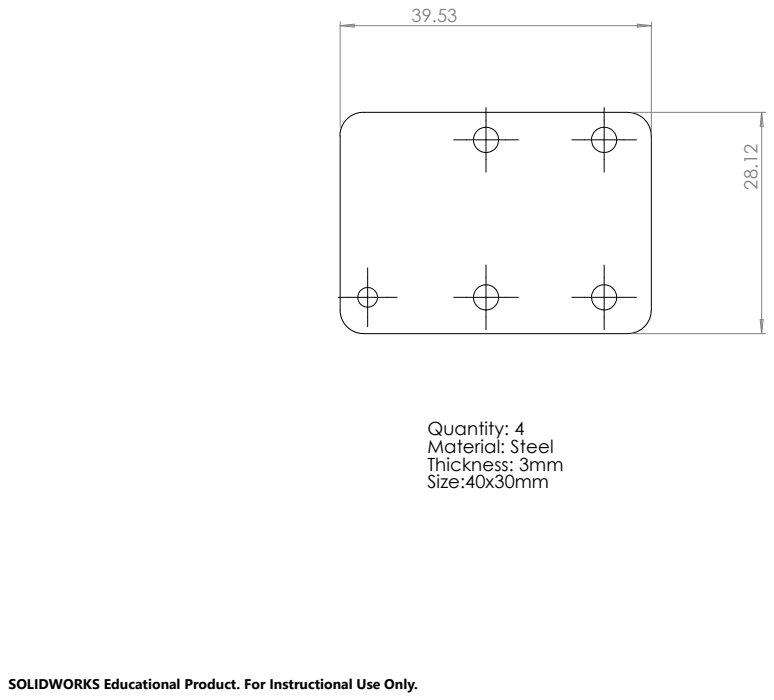
[picture p150: page 1]
Quantity: 4 Material: Steel Thickness: 3mm; Size:40x30mm

SOLIDWORKS Educational Product. For Instructional Use Only.
