ZacCac/MoXY-3D-Printer/CAD/Drawings/Waterjet Parts 2/PDF_Kinematic_Clamp_V1.pdf

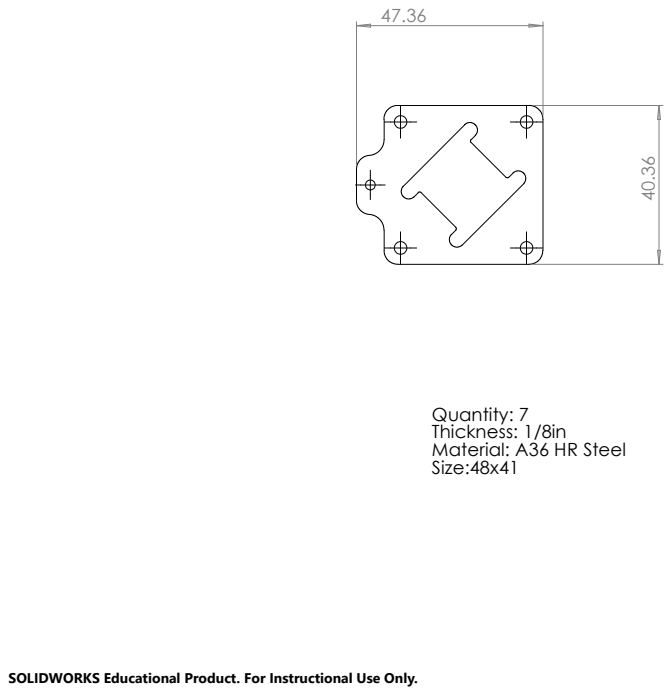
[picture p151: page 1]

Quantity: 7
Thickness: 1/8in
Material: A36 HR Steel
Size:48x41

SOLIDWORKS Educational Product. For Instructional Use Only.
