ZacCac/MoXY-3D-Printer/CAD/Drawings/Waterjet Parts 2/PDF_Kinematic_Spring_Steel_V1.pdf

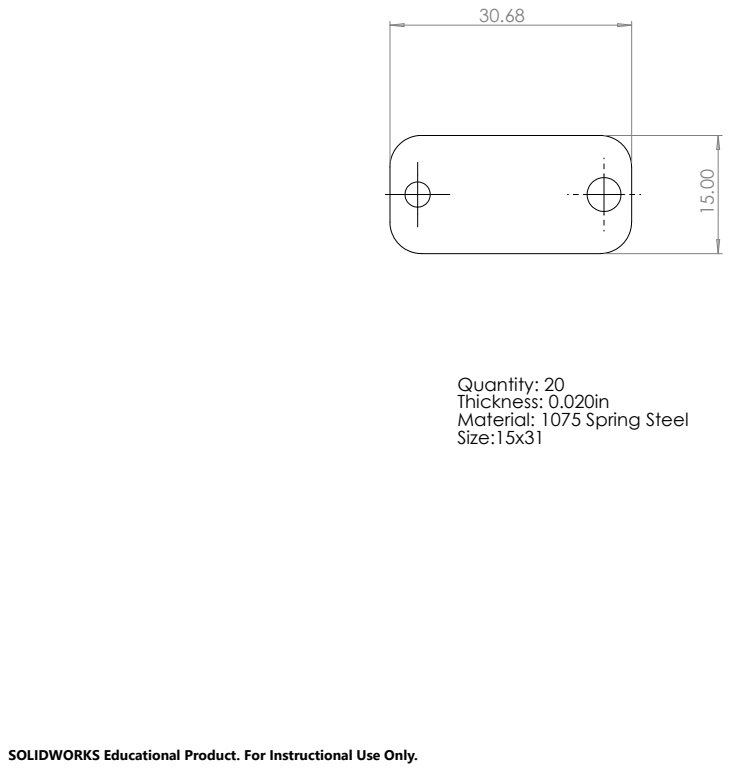
[picture p152: page 1]

Quantity: 20
Thickness: 0.020in
Material: 1075 Spring Steel
Size:15x31

SOLIDWORKS Educational Product. For Instructional Use Only.
