ZacCac/MoXY-3D-Printer/CAD/Drawings/Waterjet Parts 2/PDF_Tensioner_Spacer_V1.pdf

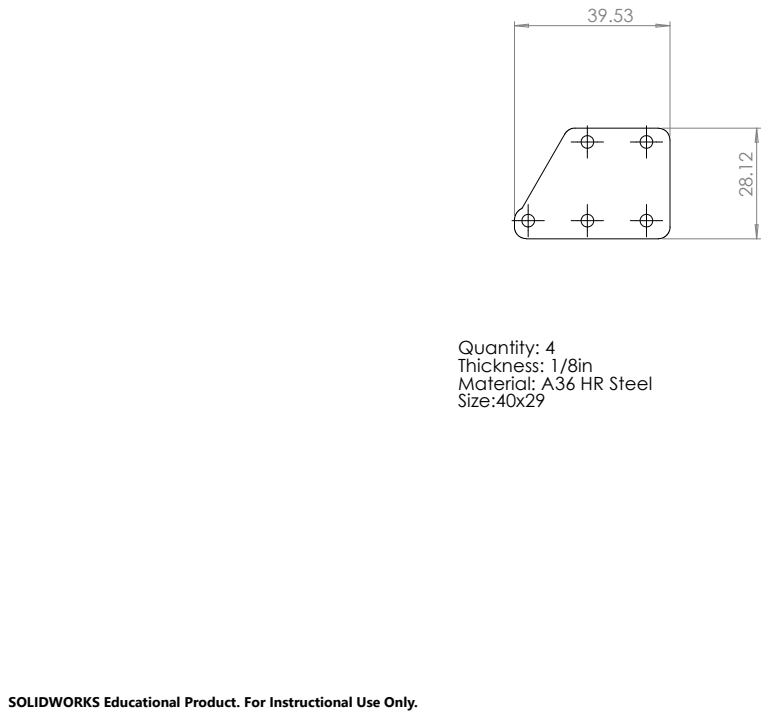
[picture p153: page 1]

Quantity: 4
Thickness: 1/8in
Material: A36 HR Steel
Size:40x29

SOLIDWORKS Educational Product. For Instructional Use Only.
