ZacCac/MoXY-3D-Printer/CAD/Drawings/Waterjet Parts 2/PDF_XY_Backer_V4.pdf

39.53 444.24

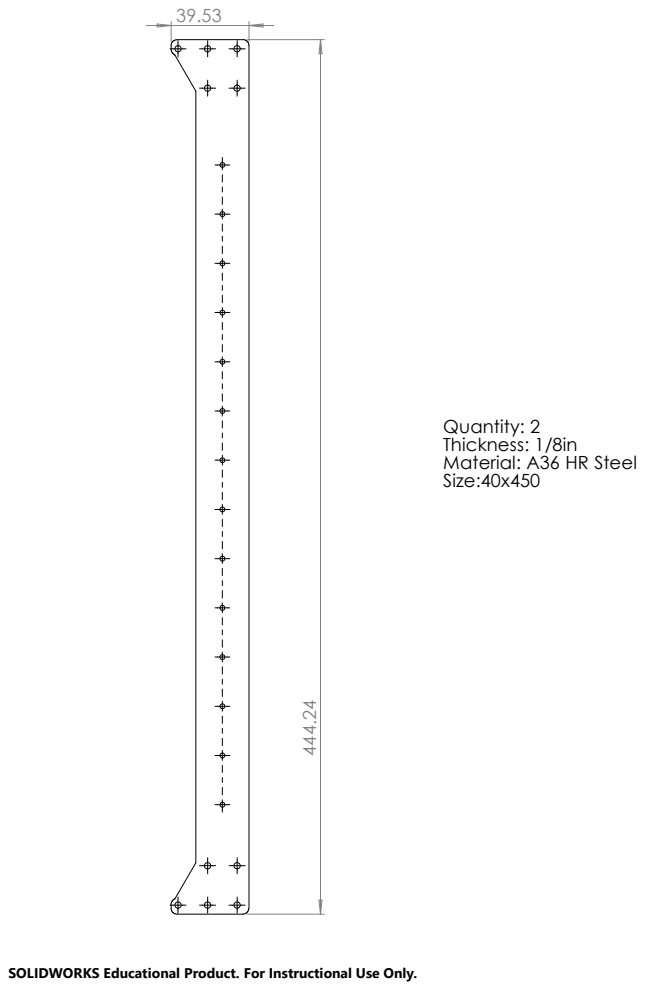
[picture p154: page 1]

Quantity: 2
Thickness: 1/8in
Material: A36 HR Steel
Size:40x450

SOLIDWORKS Educational Product. For Instructional Use Only.
