ZacCac/MoXY-3D-Printer/CAD/Drawings/Waterjet Parts 2/PDF_Z_Belt_Cover_V1.pdf

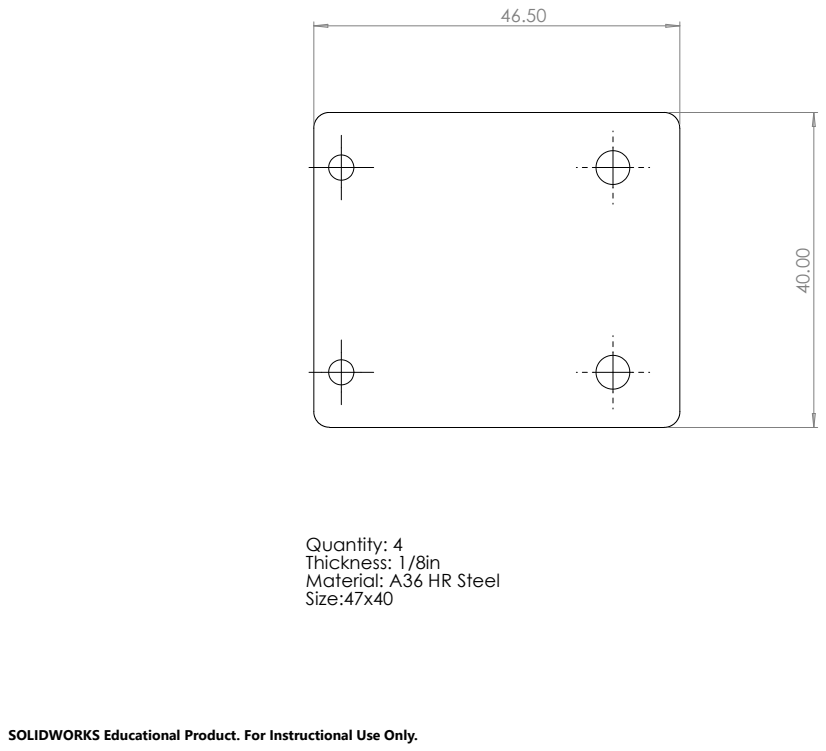
[picture p155: page 1]

Quantity: 4
Thickness: 1/8in
Material: A36 HR Steel
Size:47x40

SOLIDWORKS Educational Product. For Instructional Use Only.
