ZacCac/MoXY-3D-Printer/CAD/Drawings/Waterjet Parts 2/PDF_Z_Stepper_Plate_Mount_V3.pdf

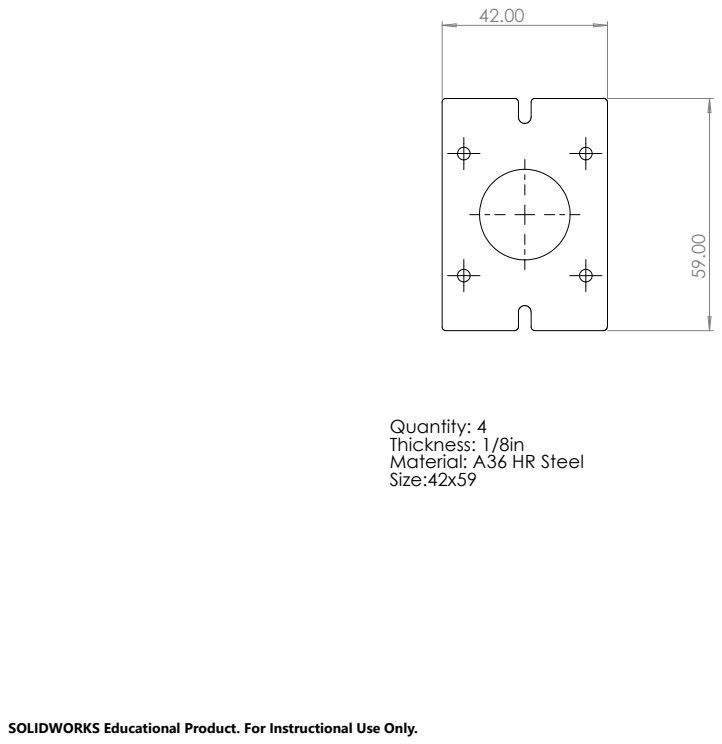
[picture p156: page 1]

Quantity: 4
Thickness: 1/8in
Material: A36 HR Steel
Size:42x59

SOLIDWORKS Educational Product. For Instructional Use Only.
