ZacCac/MoXY-3D-Printer/CAD/Drawings/Waterjet Parts 3/PDF_Motor_Mount_V3.pdf

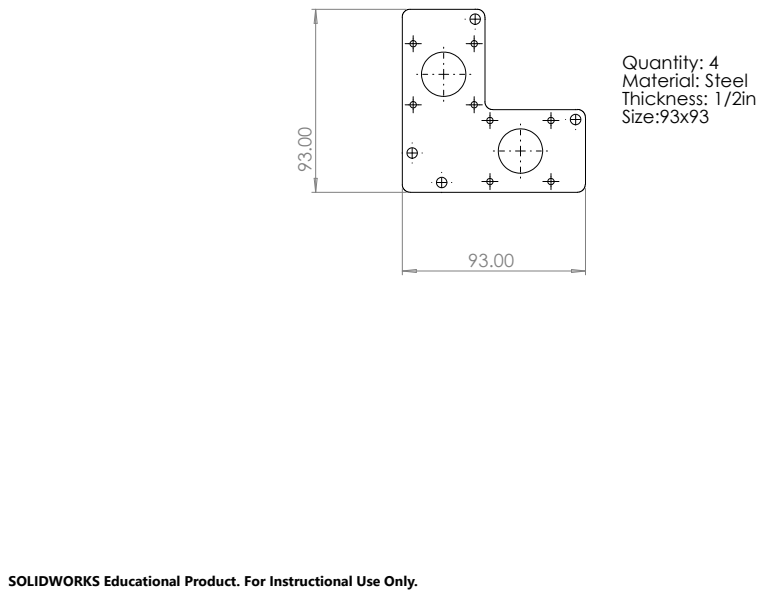
[picture p157: page 1]
Quantity: 4 Material: Steel Thickness: 1/2in Size:93x93 93.00

SOLIDWORKS Educational Product. For Instructional Use Only.
