ZacCac/MoXY-3D-Printer/CAD/Drawings/Waterjet Parts 3/PDF_Static_Toothed_Clamp_V1.pdf

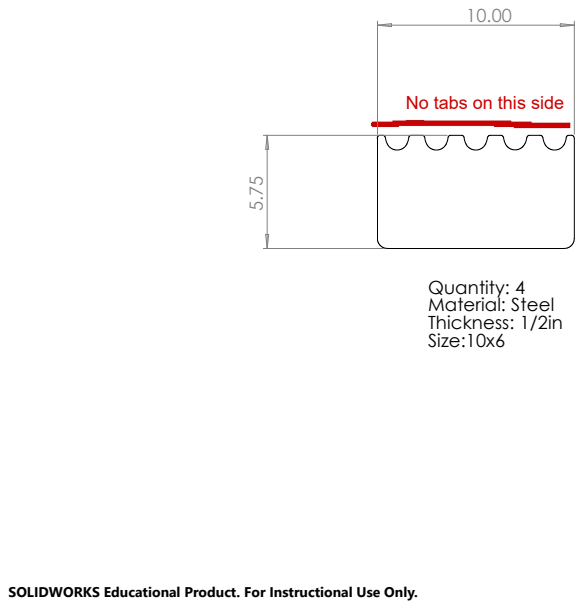
[picture p158: page 1]
Quantity: 4 Material: Steel Thickness: 1/2in Size:10x6

No tabs on this side

SOLIDWORKS Educational Product. For Instructional Use Only.
