ZacCac/MoXY-3D-Printer/CAD/Drawings/Waterjet Parts 3/PDF_XY_Block_V2.pdf

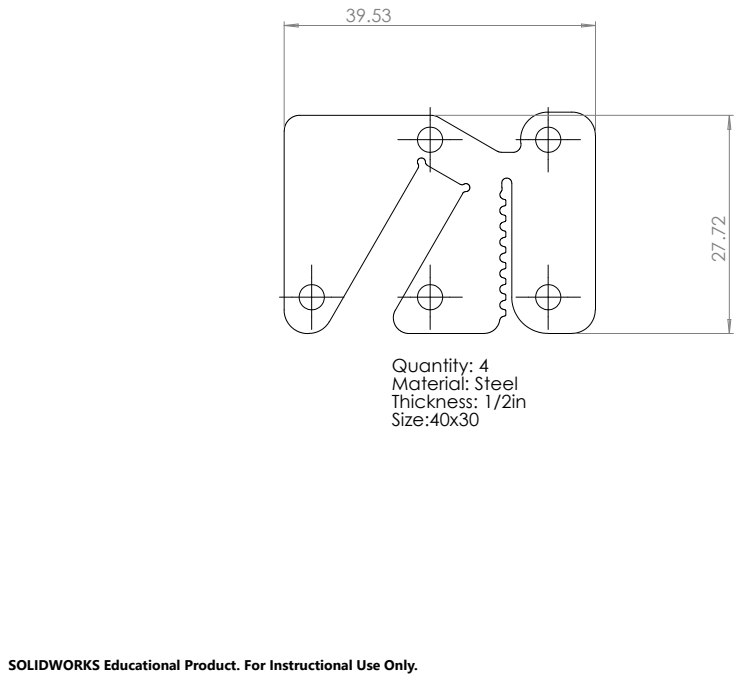
[picture p160: page 1]
Quantity: 4 Material: Steel Thickness: 1/2in Size:40x30

SOLIDWORKS Educational Product. For Instructional Use Only.
