ZacCac/MoXY-3D-Printer/CAD/Drawings/Waterjet Parts 3/PDF_Z_Tensioner_V1.pdf

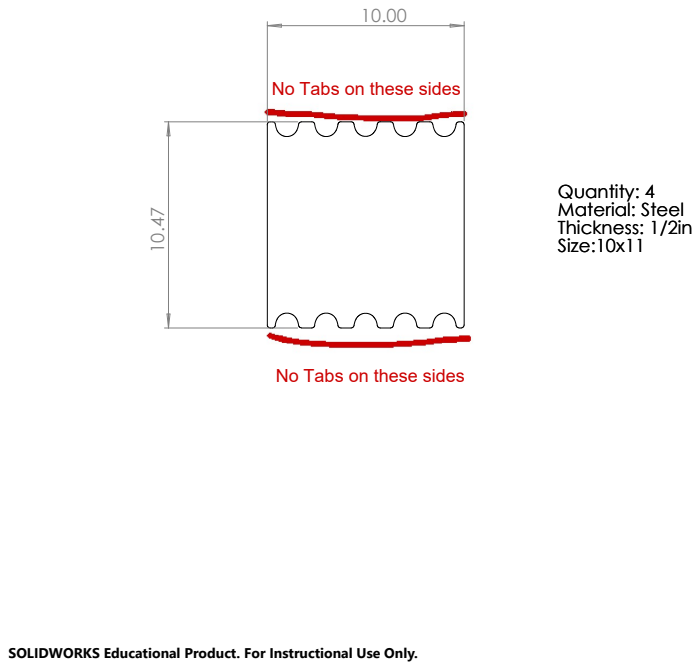
[picture p161: page 1]
Quantity: 4 Material: Steel Thickness: 1/2in Size:10x11

No Tabs on these sides

SOLIDWORKS Educational Product. For Instructional Use Only.
