ZacCac/MoXY-3D-Printer/CAD/Drawings/Waterjet Parts 5/PDF_keyhole_V1.pdf

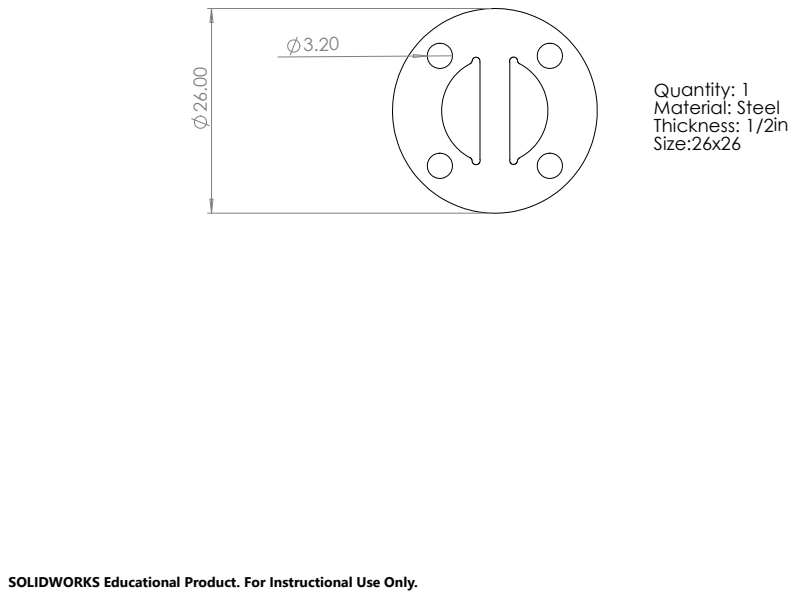
[picture p162: page 1]

Quantity: 1 Material: Steel
Thickness: 1/2in
Size:26x26

SOLIDWORKS Educational Product. For Instructional Use Only.
