ZacCac/MoXY-3D-Printer/CAD/Drawings/PDFs/DWG_Worm_Bearing_Block_V1.pdf

B B

1

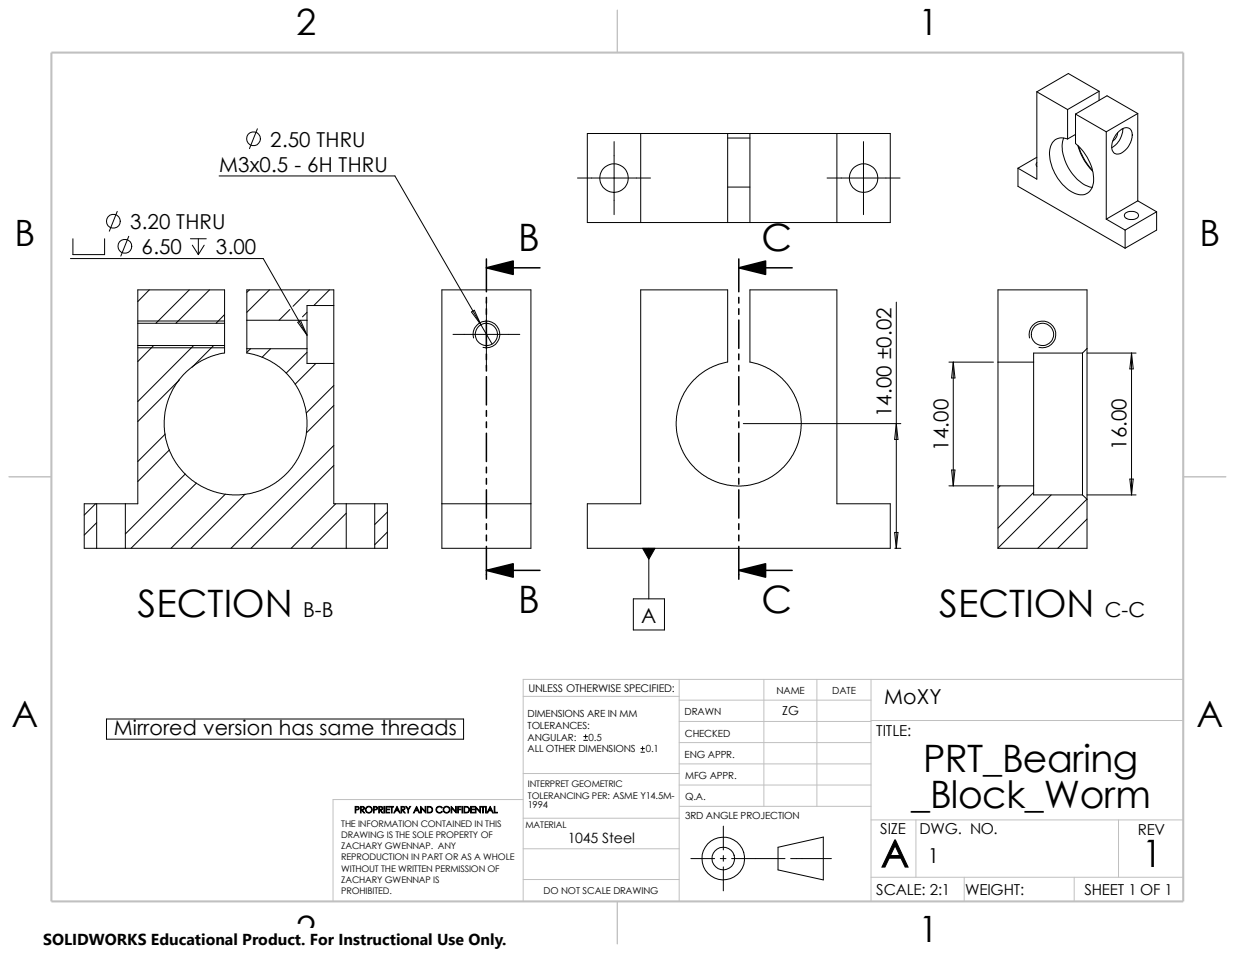
[picture p163: page 1]
ASME Y14.5M-; 1045 Steel; PRT_Bearing; TOLERANCING PER:; _Block_Worm 1; DO NOT SCALE DRAWING; SHEET 1 OF 1; SCALE: 2:1; DWG. NO.; REV; SIZE; TITLE:; CHECKED; MATERIAL; INTERPRET GEOMETRIC; ZACHARY GWENNAP IS; WEIGHT:; SECTION C-C ¹⁴.00; 2.50 THRU M3x0.5 - 6H THRU; SECTION B-B; 3.20 THRU 6.50 3.00

UNLESS OTHERWISE SPECIFIED: | | NAME | DATE | MoXY

DIMENSIONS ARE IN MM TOLERANCES: ANGULAR: 0.5 ALL OTHER DIMENSIONS 0.1 | DRAWN

Mirrored version has same threads

ENG APPR.
MFG APPR.
Q.A.
3RD ANGLE PROJECTION

PROPRIETARY AND CONFIDENTIAL
THE INFORMATION CONTAINED IN THIS
DRAWING IS THE SOLE PROPERTY OF
ZACHARY GWENNAP. ANY
REPRODUCTION IN PART OR AS A WHOLE
WITHOUT THE WRITTEN PERMISSION OF
PROHIBITED.

SOLIDWORKS Educational Product. For Instructional Use Only.
