ZacCac/MoXY-3D-Printer/CAD/Drawings/Waterjet Parts/PRT_Heater_Clamp_V1.pdf

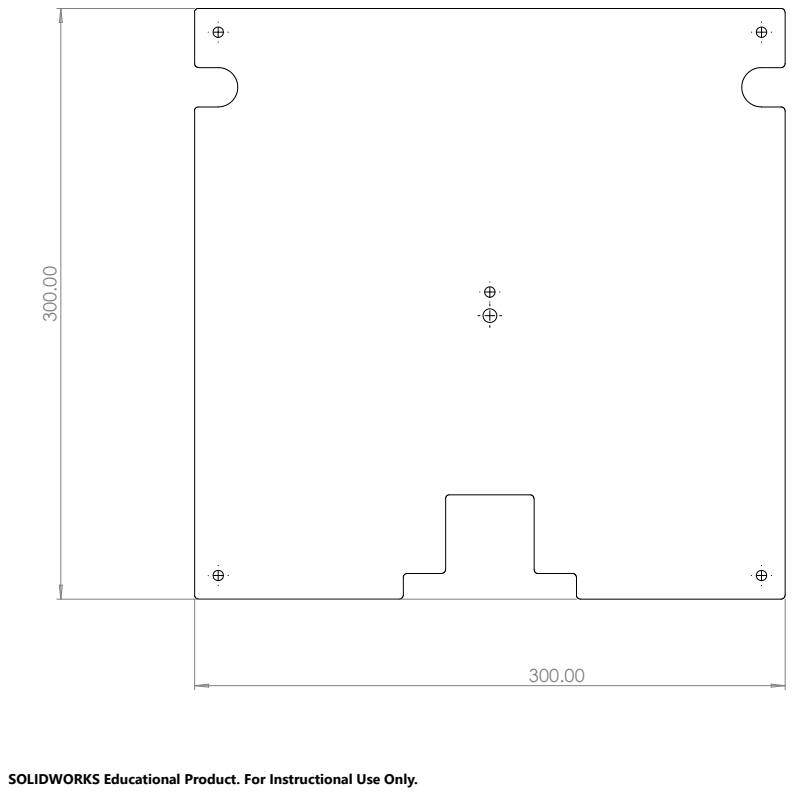
[picture p164: page 1]
300.00 ³⁰⁰.00

SOLIDWORKS Educational Product. For Instructional Use Only.
