ZacCac/MoXY-3D-Printer/CAD/Drawings/Waterjet Parts/PRT_Mellow_D5_Plate_V1.pdf

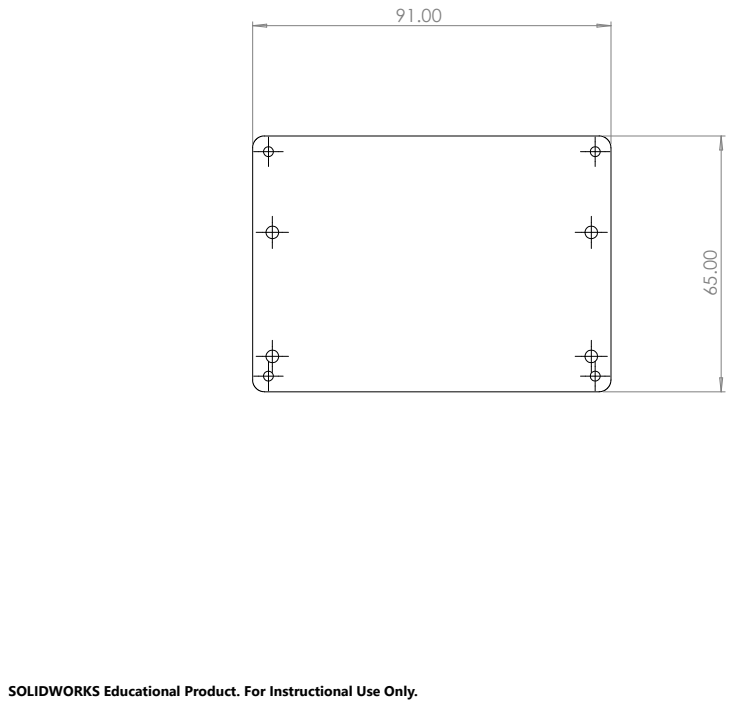
[picture p165: page 1]

SOLIDWORKS Educational Product. For Instructional Use Only.
