ZacCac/MoXY-3D-Printer/CAD/Drawings/Waterjet Parts/PRT_Raspi_Plate_V2.pdf

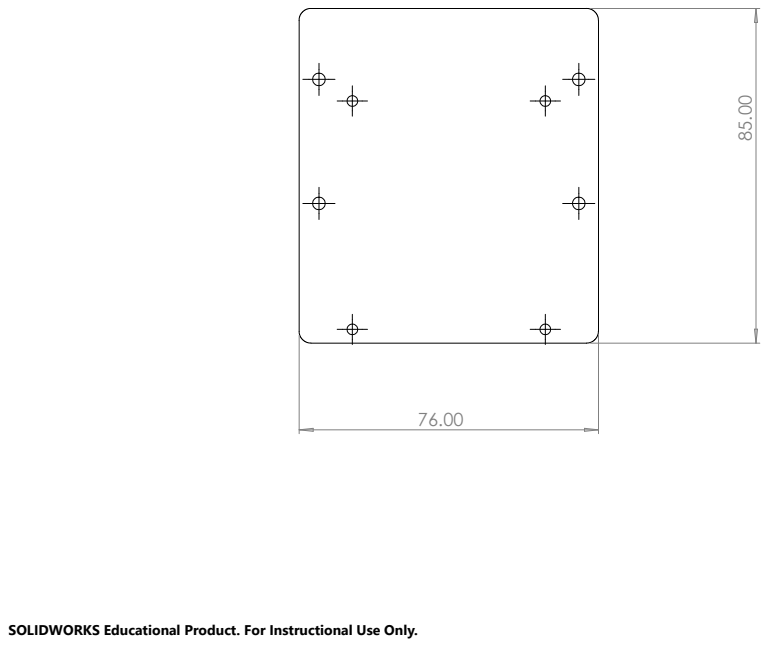
[picture p166: page 1]

SOLIDWORKS Educational Product. For Instructional Use Only.
