ZacCac/MoXY-3D-Printer/CAD/Drawings/Waterjet Parts/PRT_Small_Power_Supply_Bracket_V1.pdf

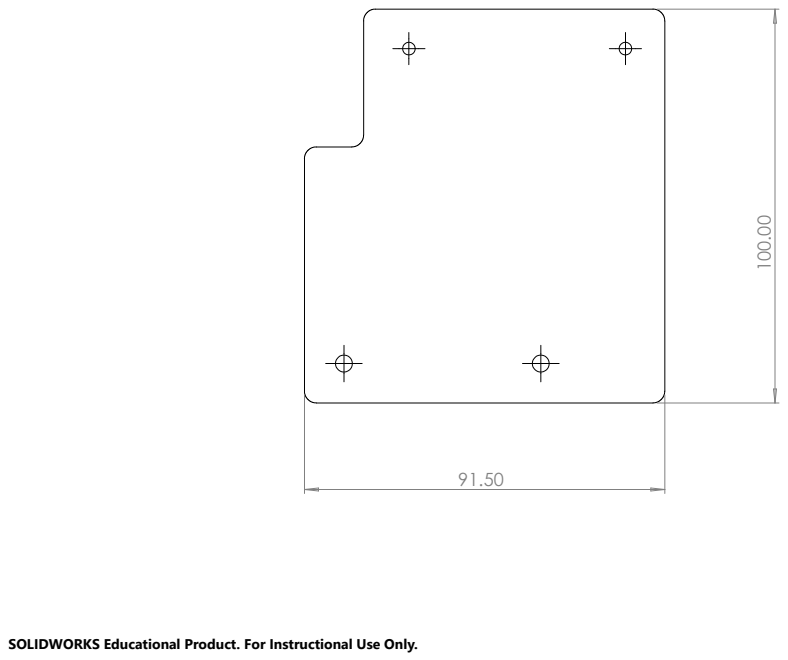
[picture p167: page 1]

SOLIDWORKS Educational Product. For Instructional Use Only.
