ZacCac/MoXY-3D-Printer/CAD/Drawings/Waterjet Parts/PRT_Supernova_Plate_V2.pdf

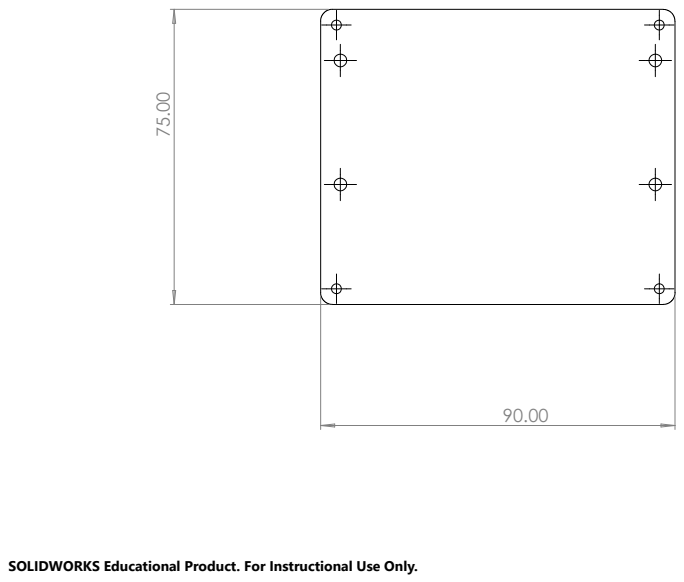
[picture p168: page 1]

SOLIDWORKS Educational Product. For Instructional Use Only.
