ZacCac/MoXY-3D-Printer/CAD/Drawings/PDFs/DWG_Kinematic_Bed_Plate_V1.pdf

B B

2

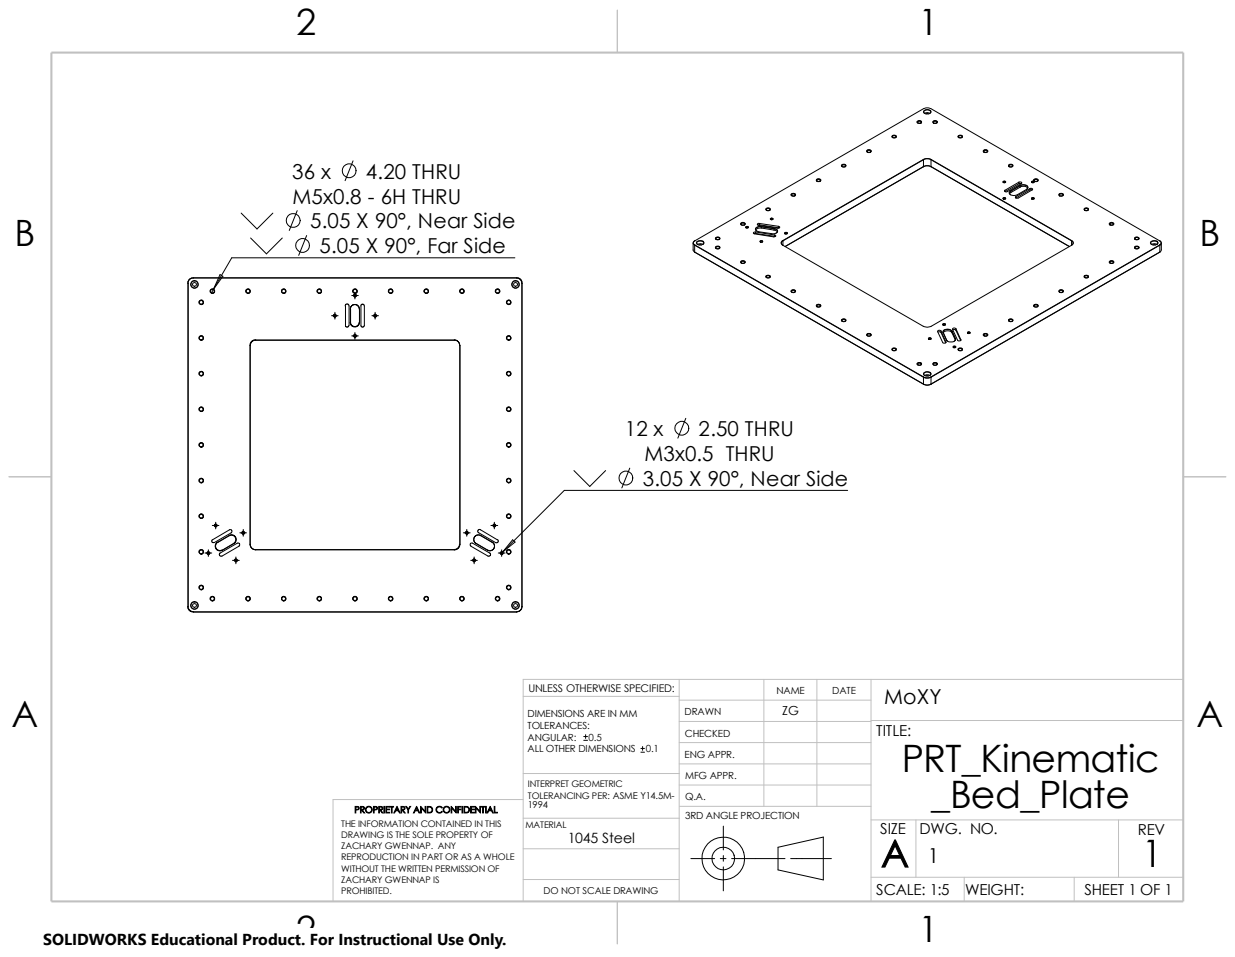
[picture p169: page 1]
1045 Steel; DO NOT SCALE DRAWING; SHEET 1 OF 1; SCALE: 1:5; DWG. NO.; REV; SIZE; MATERIAL; TOLERANCING PER: ASME Y14.5M-; INTERPRET GEOMETRIC; ZACHARY GWENNAP IS; WEIGHT:; 5.05 X 90°, Near Side; M5x0.8 - 6H THRU; 5.05 X 90°, Far Side; 4.20 THRU; 2.50 THRU; M3x0.5 THRU 3.05 X 90°, Near Side

UNLESS OTHERWISE SPECIFIED: | | NAME | DATE | MoXY

DIMENSIONS ARE IN MM TOLERANCES: ANGULAR: 0.5 ALL OTHER DIMENSIONS 0.1 | DRAWN

CHECKED | | | TITLE: PRT_Kinematic _Bed_Plate

ENG APPR.
MFG APPR.
Q.A.
3RD ANGLE PROJECTION

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

SOLIDWORKS Educational Product. For Instructional Use Only.
