ZacCac/MoXY-3D-Printer/CAD/Drawings/PDFs/DWG_MIC_6_Bed_300_V2.pdf

B B

2

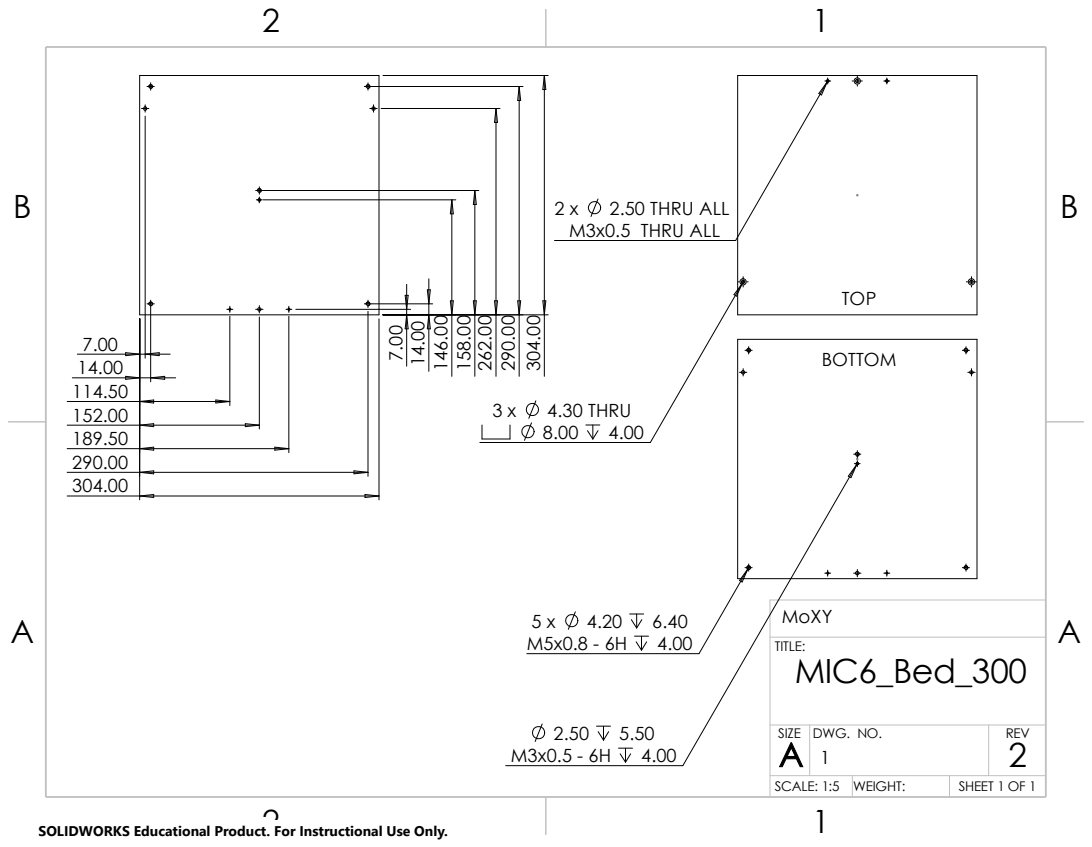
[picture p170: page 1]
MoXY A A; MIC6_Bed_300; TITLE:; TOP 14.00; BOTTOM; 4.30 THRU; 2.50 THRU ALL; M3x0.5 THRU ALL

SIZE A 2 | DWG. NO. 1 | REV

SCALE: 1:5 | WEIGHT: | SHEET 1 OF 1

SOLIDWORKS Educational Product. For Instructional Use Only.
