ZacCac/MoXY-3D-Printer/CAD/Drawings/Elec_Panel_Template/1.pdf

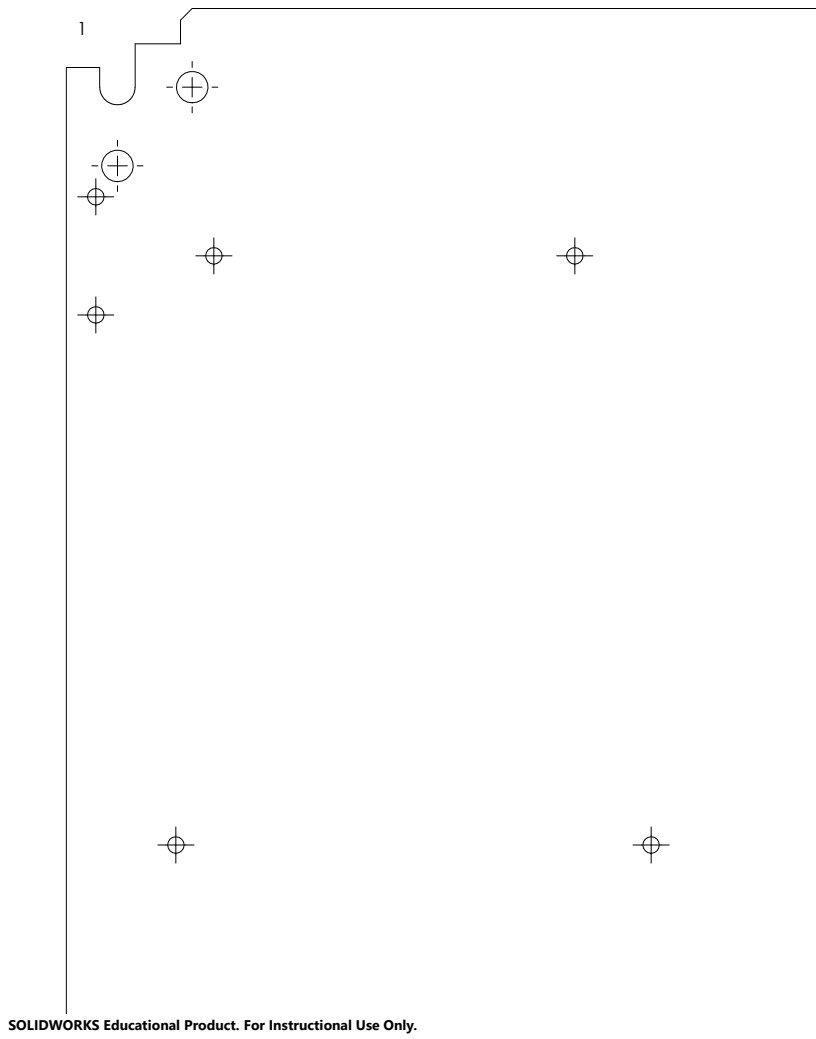
[picture p171: page 1]

SOLIDWORKS Educational Product. For Instructional Use Only.
