ZacCac/MoXY-3D-Printer/CAD/Drawings/Elec_Panel_Template/2.pdf

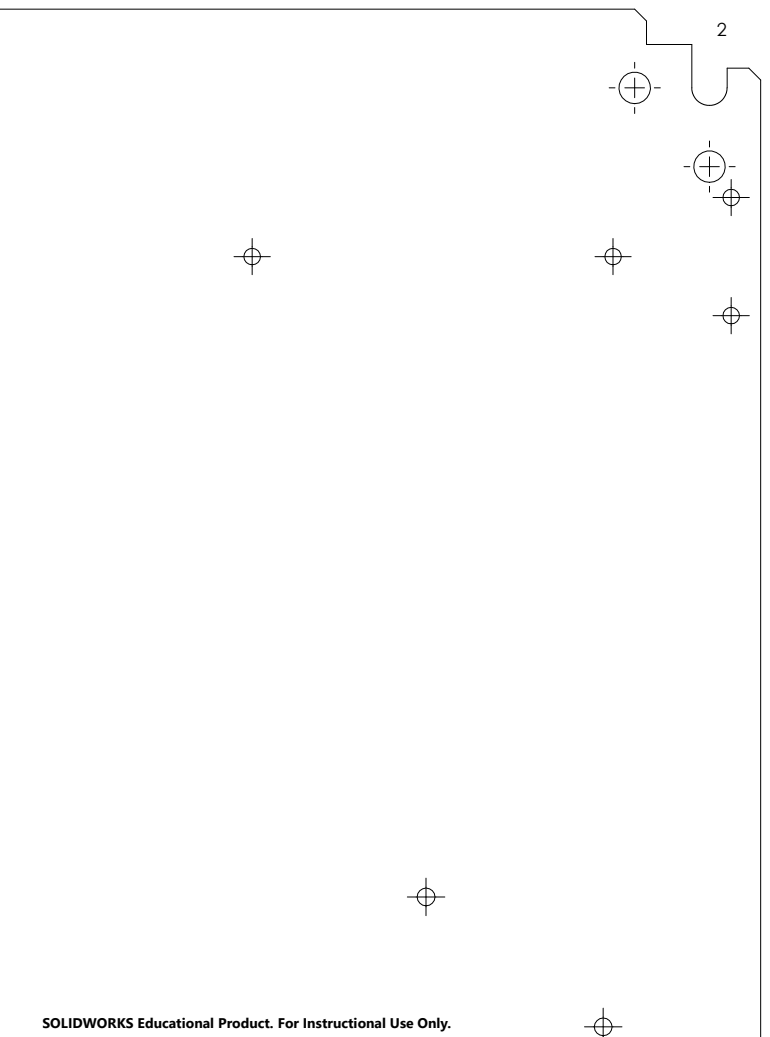
[picture p172: page 1]

SOLIDWORKS Educational Product. For Instructional Use Only.
