ZacCac/MoXY-3D-Printer/CAD/Drawings/Elec_Panel_Template/3.pdf

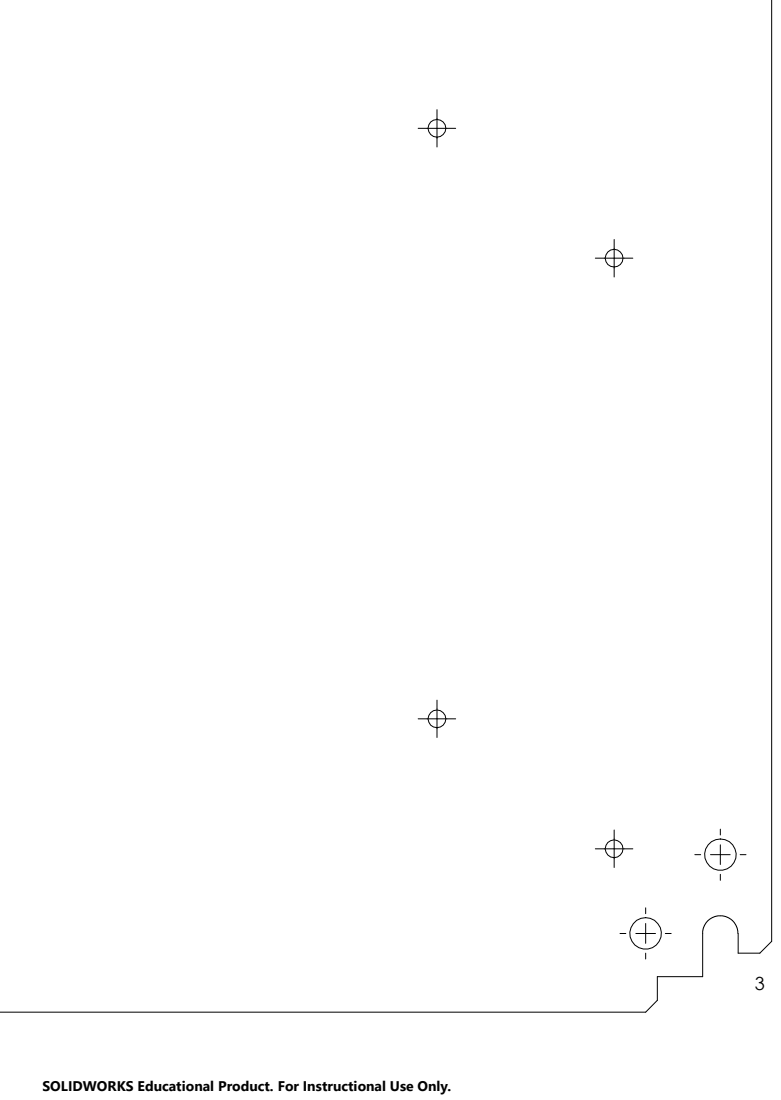
[picture p173: page 1]

SOLIDWORKS Educational Product. For Instructional Use Only.
