ZacCac/MoXY-3D-Printer/CAD/Drawings/Elec_Panel_Template/4.pdf

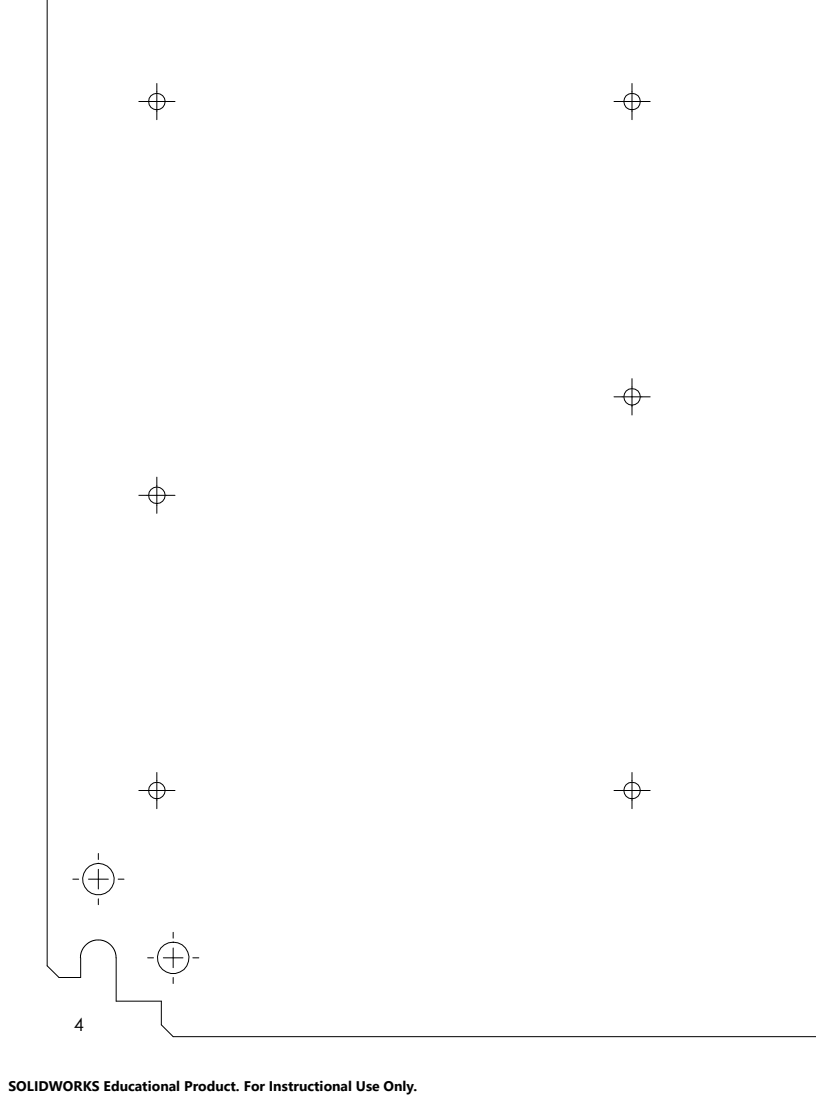
[picture p174: page 1]

SOLIDWORKS Educational Product. For Instructional Use Only.
