ZacCac/MoXY-3D-Printer/CAD/Drawings/PDFs/DWG_Vertical_Beam_V1.pdf

B B

2

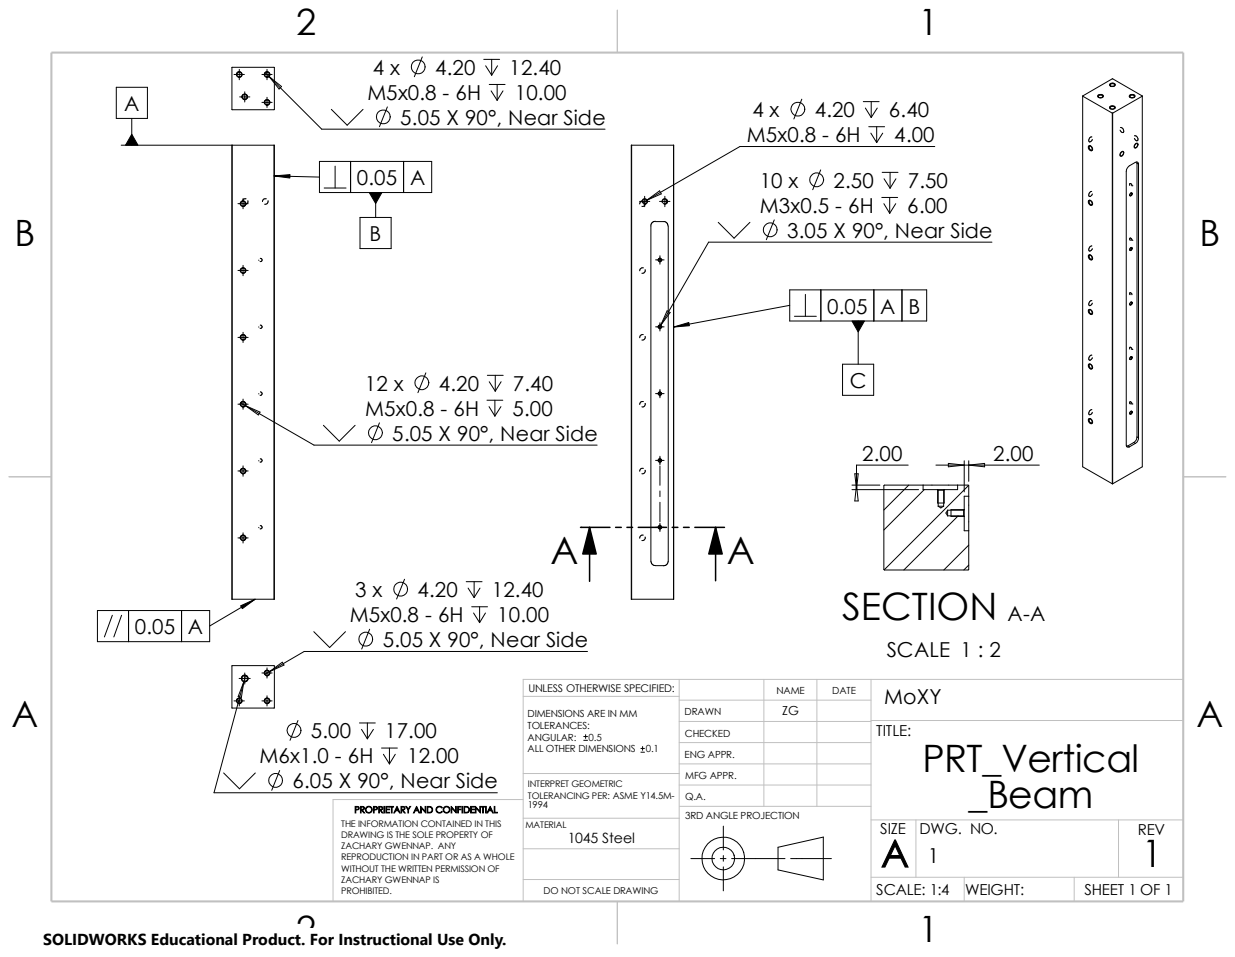
[picture p175: page 1]
1045 Steel; _Beam; SHEET 1 OF 1; DWG. NO.; SCALE: 1:4; REV; SIZE; TITLE:; CHECKED; MATERIAL; PRT_Vertical; TOLERANCING PER: ASME Y14.5M-; INTERPRET GEOMETRIC; ZACHARY GWENNAP IS; WEIGHT:; 5.05 X 90°, Near Side; SECTION A-A; SCALE 1 : 2; 4.20 12.40 10.00 5.05 X 90°, Near Side; 6.05 X 90°, Near Side; 3.05 X 90°, Near Side

UNLESS OTHERWISE SPECIFIED: | | NAME | DATE | MoXY
DIMENSIONS ARE IN MM TOLERANCES: ANGULAR: 0.5 ALL OTHER DIMENSIONS 0.1 | DRAWN | ZG

ENG APPR.
MFG APPR.
Q.A.
3RD ANGLE PROJECTION

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

DO NOT SCALE DRAWING

SOLIDWORKS Educational Product. For Instructional Use Only.
