ZacCac/MoXY-3D-Printer/CAD/Drawings/PDFs/DWG_XY_Block_V2.pdf

B B

2

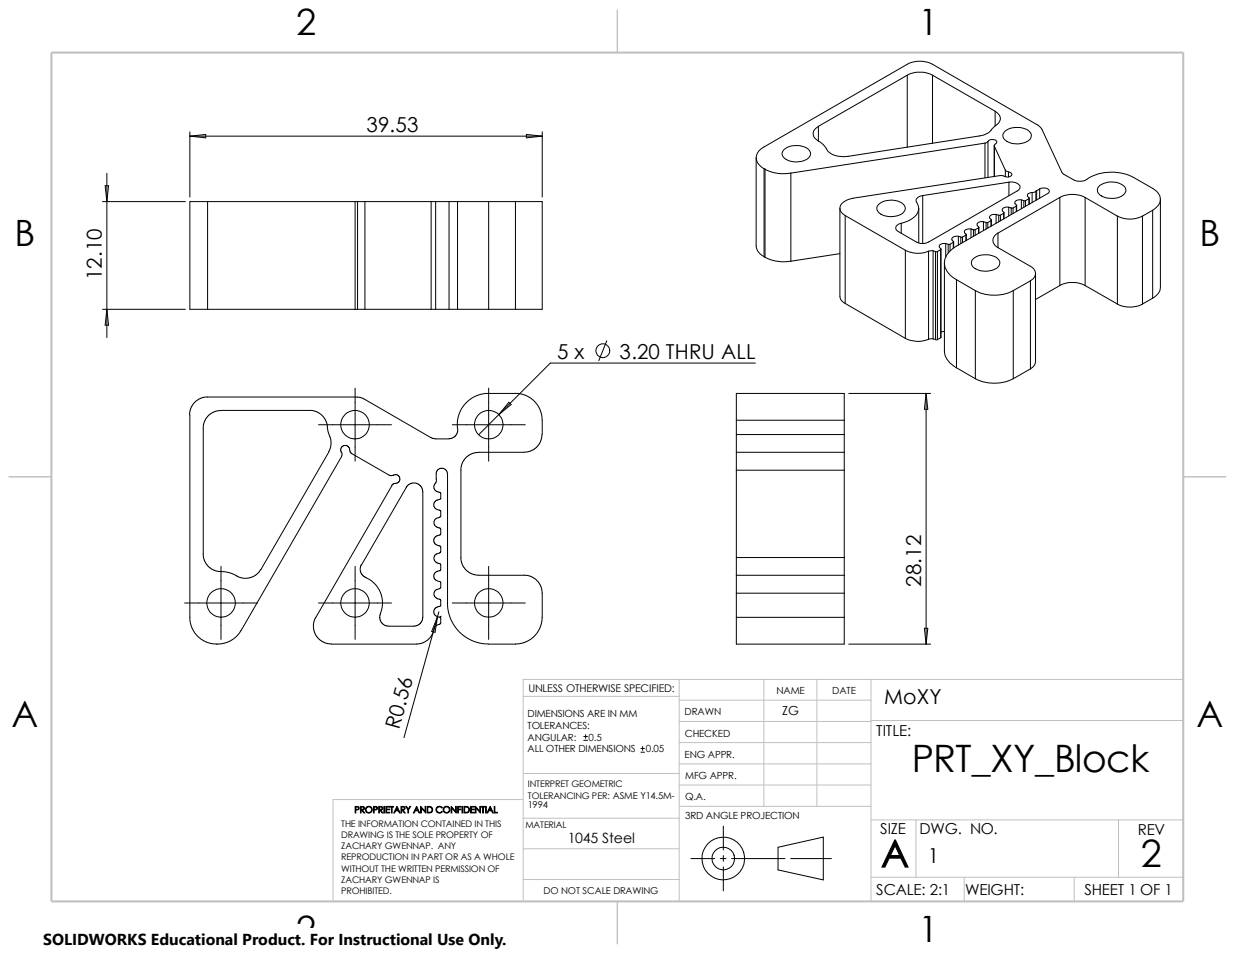
[picture p176: page 1]
1045 Steel; DWG. NO.; DO NOT SCALE DRAWING; SCALE: 2:1; SHEET 1 OF 1; REV; SIZE; MATERIAL; TOLERANCING PER: ASME Y14.5M-; INTERPRET GEOMETRIC; ZACHARY GWENNAP IS; WEIGHT:; 3.20 THRU ALL

UNLESS OTHERWISE SPECIFIED: | | NAME | DATE | MoXY

DIMENSIONS ARE IN MM TOLERANCES: ANGULAR: 0.5 ALL OTHER DIMENSIONS 0.05 | DRAWN

CHECKED | | | TITLE: PRT_XY_Block

ENG APPR.
MFG APPR.
Q.A.
3RD ANGLE PROJECTION

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

SOLIDWORKS Educational Product. For Instructional Use Only.
