ZacCac/MoXY-3D-Printer/CAD/Drawings/PDFs/DWG_XY_Tensioner_V1.pdf

B B

2

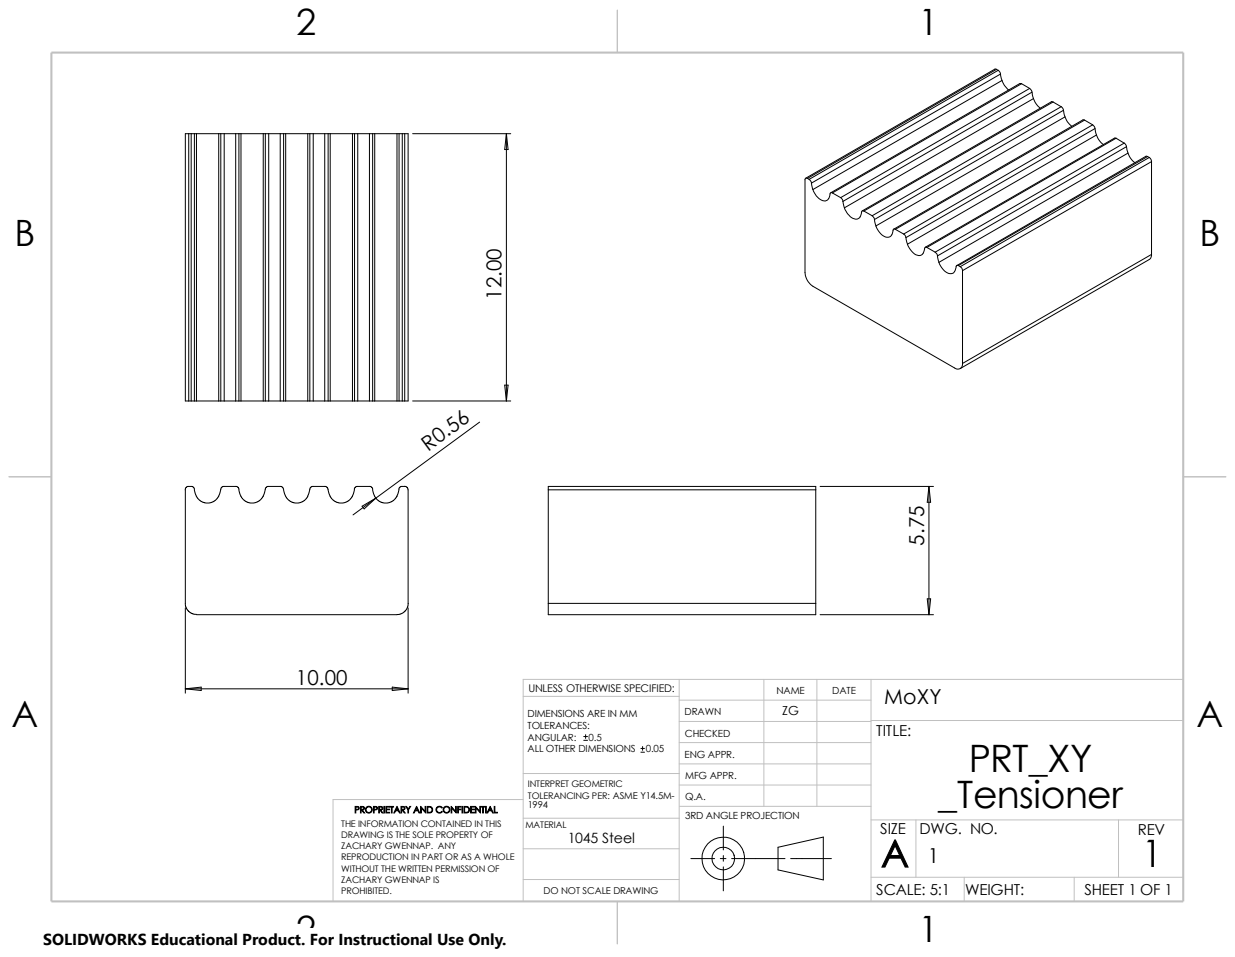
[picture p177: page 1]
SHEET 1 OF 1; DWG. NO.; SCALE: 5:1; REV; SIZE; 1045 Steel; MATERIAL; ASME Y14.5M-; INTERPRET GEOMETRIC TOLERANCING PER: 1994; ZACHARY GWENNAP IS; WEIGHT:

UNLESS OTHERWISE SPECIFIED: | | NAME | DATE | MoXY

DIMENSIONS ARE IN MM TOLERANCES: ANGULAR: 0.5 ALL OTHER DIMENSIONS 0.05 | DRAWN

CHECKED | | | TITLE: PRT_XY _Tensioner

ENG APPR.
MFG APPR.
Q.A.
3RD ANGLE PROJECTION

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

DO NOT SCALE DRAWING

SOLIDWORKS Educational Product. For Instructional Use Only.
