ZacCac/MoXY-3D-Printer/CAD/Drawings/PDFs/DWG_Z_Frame_V2.pdf

B B

2

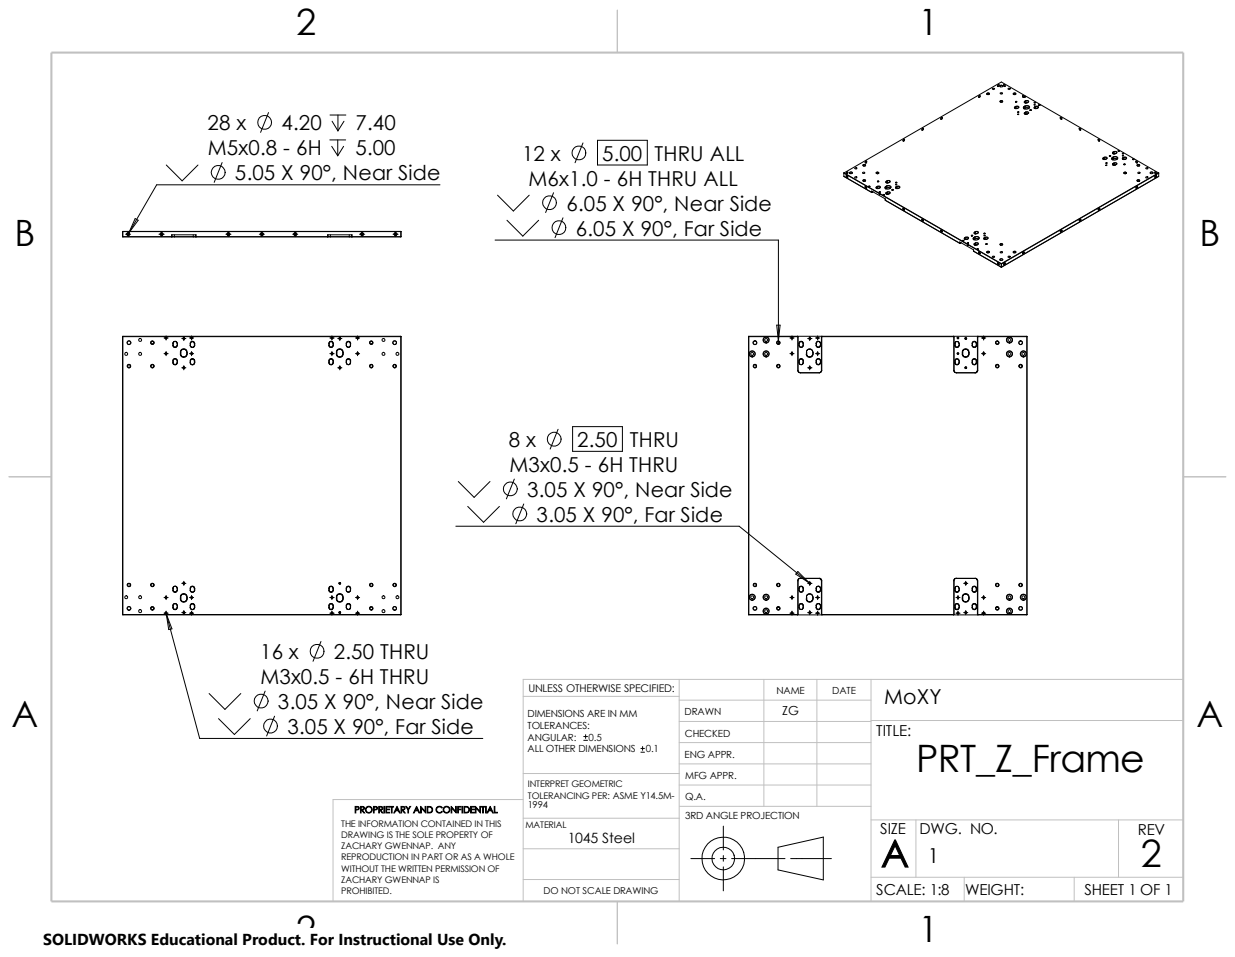
[picture p178: page 1]
1045 Steel; DO NOT SCALE DRAWING; SHEET 1 OF 1; SCALE: 1:8; DWG. NO.; REV; SIZE; MATERIAL; TOLERANCING PER: ASME Y14.5M-; INTERPRET GEOMETRIC; ZACHARY GWENNAP IS; WEIGHT:; 2.50 THRU; M3x0.5 - 6H THRU 3.05 X 90°, Near Side 3.05 X 90°, Far Side; 6.05 X 90°, Near Side 6.05 X 90°, Far Side; 5.00 THRU ALL M6x1.0 - 6H THRU ALL; THRU; 5.05 X 90°, Near Side

UNLESS OTHERWISE SPECIFIED: | | NAME | DATE | MoXY

DIMENSIONS ARE IN MM TOLERANCES: ANGULAR: 0.5 ALL OTHER DIMENSIONS 0.1 | DRAWN

CHECKED | | | TITLE: PRT_Z_Frame

ENG APPR.
MFG APPR.
Q.A.
3RD ANGLE PROJECTION

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

SOLIDWORKS Educational Product. For Instructional Use Only.
