ZacCac/MoXY-3D-Printer/(commit log)

2024-05-26 Initial Mockup
    [ASM_Feet_V1.SLDASM, ASM_Frame_V1.SLDASM, ASM_Gantry_V1.SLDASM, ASM_Gantry_V2.SLDASM, ASM_Gantry_V3.SLDASM, ASM_MGN12H.SLDASM, ASM_Motor_Transmission_V1.SLDASM, ASM_Printer_V1.SLDASM]
2024-05-27 Added Deformation Sims
    Added cantilever deformation simulations for steel tubing.
    Slightly altered gantry plate geometry to eliminate collisions
    [ASM_Gantry_V3.SLDASM, PRT_Gantry_Main_Plate_V4.SLDPRT]
2024-05-28 Added description for thermal expansion
    [ASM_Gantry_V3.SLDASM, ASM_Worm_Bearing_Block_Mirror_V1.SLDASM, ASM_Worm_Bearing_Block_V1.SLDASM, ASM_Z_Worm_Drive_Mirror_V1.SLDASM, ASM_Z_Worm_Drive_V1.SLDASM, PRT_Worm_Bearing_Block_Mirror_V1.SLDPRT]
2024-05-29 Added tensioning equations
2024-05-30 Added bed layout
    [ASM_Gantry_V3-DESKTOP-5GL7K9D.SLDASM, ASM_Worm_Bearing_Block_V1-DESKTOP-5GL7K9D.SLDASM, ASM_Z_V1.SLDASM, ASM_Z_Worm_Drive_Mirror_V1-DESKTOP-5GL7K9D.SLDASM, ASM_Z_Worm_Drive_V1-DESKTOP-5GL7K9D.SLDASM, PRT_MIC6_Bed_300_V1.SLDPRT, PRT_Z_Frame_V1.SLDPRT]
2024-05-30 Added bed layout again
    [ASM_Gantry_V3.SLDASM, ASM_Worm_Bearing_Block_Mirror_V1.SLDASM, ASM_Worm_Bearing_Block_V1.SLDASM, ASM_Z_V1.SLDASM, ASM_Z_Worm_Drive_Mirror_V1.SLDASM, ASM_Z_Worm_Drive_V1.SLDASM]
2024-05-30 Added screws
    [ASM_Bearing_Block_Mirror_V1.SLDASM, ASM_Bearing_Block_V1.SLDASM, ASM_Gantry_V3-DESKTOP-5GL7K9D.SLDASM, ASM_Gantry_V3.SLDASM, ASM_MGN12_and_Screws_V1.SLDASM, ASM_Worm_Bearing_Block_Mirror_V1.SLDASM, ASM_Worm_Bearing_Block_V1.SLDASM, ASM_Z_V1.SLDASM]
2024-06-02 Deleted extra files
    [ASM_Worm_Bearing_Block_V1-DESKTOP-5GL7K9D.SLDASM]
2024-06-03 Kinematic Z Mockup
    [ASM_Bearing_Block_Mirror_V1.SLDASM, ASM_Bearing_Block_V1.SLDASM, ASM_Bed_V1.SLDASM, ASM_Gantry_V3.SLDASM, ASM_Kinematic-1_V1.SLDASM, ASM_MGN12_and_Screws_V1.SLDASM, ASM_Worm_Bearing_Block_Mirror_V1.SLDASM, ASM_Worm_Bearing_Block_V1.SLDASM]
2024-06-07 Added Z Belt Tensioners
    - Adjusted belts to GT3 spec
    - Need to adjust slot for Z tensioner shaft
    [ASM_Bearing_Block_Mirror_V1.SLDASM, ASM_Bearing_Block_V1.SLDASM, ASM_Bed_V1.SLDASM, ASM_Gantry_V3.SLDASM, ASM_Kinematic-1_V1.SLDASM, ASM_Kinematic-1_V2.SLDASM, ASM_Temp_Printhead_V1.SLDASM, ASM_Worm_Bearing_Block_Mirror_V1.SLDASM]
2024-06-21 Finished Z
    [ASM_Bearing_Block_Mirror_V1.SLDASM, ASM_Bearing_Block_V1.SLDASM, ASM_Bed_V1.SLDASM, ASM_Kinematic-1_V1.SLDASM, ASM_Kinematic-1_V2.SLDASM, ASM_Kinematic-2_V2.SLDASM, ASM_Kinematic-3_V2.SLDASM, ASM_Kinematic-4_V2.SLDASM]
2024-06-21 Lowered Z-Drive
    [ASM_Bearing_Block_Drive_Mirror_V1.SLDASM, ASM_Bearing_Block_Mirror_V1.SLDASM, ASM_Bearing_Block_V1.SLDASM, ASM_Bed_V1.SLDASM, ASM_Kinematic-1_V2.SLDASM, ASM_Kinematic-2_V2.SLDASM, ASM_MGN12_and_Screws_V1.SLDASM, ASM_Motor_Slide_V1.SLDASM]
2024-06-21 Full Z Finished V1
    [ASM_Bearing_Block_Drive_Mirror_V1.SLDASM, ASM_Bearing_Block_Drive_V1.SLDASM, ASM_Motor_Slide_Mirror_V1.SLDASM, ASM_Motor_Slide_V1.SLDASM, ASM_Z_Drive_Mirror_V1.SLDASM, ASM_Z_Drive_V1.SLDASM, PRT_Z_Frame_V1.SLDPRT, PRT_Z_Stepper_Plate_V2.SLDPRT]
2024-06-22 Added Double Shear to Gantry
    [ASM_Bearing_Block_8mm_Mirror_V1.SLDASM, ASM_Bearing_Block_8mm_V1.SLDASM, ASM_Bearing_Block_Drive_Mirror_V1.SLDASM, ASM_Bearing_Block_Drive_V1.SLDASM, ASM_Bearing_Block_Mirror_V1.SLDASM, ASM_Bearing_Block_V1.SLDASM, ASM_Bed_V1.SLDASM, ASM_Kinematic-1_V2.SLDASM]
2024-06-23 Added Bed Stack
    [ASM_Bearing_Block_8mm_Mirror_V1.SLDASM, ASM_Bearing_Block_8mm_V1.SLDASM, ASM_Bed_V1.SLDASM, ASM_XY_Transmission_V1.SLDASM, PRT_Bed_Magnet_V1.SLDPRT, PRT_PEI_Sheet_V1.SLDPRT]
2024-06-24 Added PG11 Support
    [ASM_Bearing_Block_8mm_Mirror_V1.SLDASM, ASM_Bearing_Block_8mm_V1.SLDASM, ASM_Bearing_Block_Drive_Mirror_V1.SLDASM, ASM_Bearing_Block_Drive_V1.SLDASM, ASM_Bearing_Block_Mirror_V1.SLDASM, ASM_Bearing_Block_V1.SLDASM, ASM_Bed_V1.SLDASM, ASM_Kinematic-1_V2.SLDASM]
2024-06-24 Added 3rd Bearing Support Z
    [ASM_Bearing_Block_Drive_Mirror_V1.SLDASM, ASM_Bearing_Block_Drive_V1.SLDASM, ASM_Bearing_Block_Mirror_V1.SLDASM, ASM_Bearing_Block_V1.SLDASM, ASM_Kinematic-1_V2.SLDASM, ASM_Kinematic-2_V2.SLDASM, ASM_Kinematic-3_V2.SLDASM, ASM_Kinematic-4_V2.SLDASM]
2024-06-24 Added HGR15 Screws
    [ASM_Bearing_Block_Drive_V1.SLDASM, ASM_Bearing_Block_V1.SLDASM, ASM_Bed_V1.SLDASM, ASM_HGR15_Screws_V1.SLDASM, ASM_Kinematic-1_V2.SLDASM, ASM_Kinematic-2_V2.SLDASM, ASM_Motor_Slide_V1.SLDASM, ASM_Worm_Bearing_Block_Mirror_V1.SLDASM]
2024-06-27 Changed to 0.9deg steppers
    - Modified gantry to fit 0.9deg stepper motors
    - Now needs standoffs to mount motors
    - Extended extrusions for support
    - Needle bearings replacing standard 628 Bearings
    [ASM_Bearing_Block_8mm_Mirror_V1.SLDASM, ASM_Bearing_Block_8mm_V1.SLDASM, ASM_Bearing_Block_Drive_Mirror_V1.SLDASM, ASM_Bearing_Block_Drive_V1.SLDASM, ASM_Bearing_Block_Mirror_V1.SLDASM, ASM_Bearing_Block_Needle_Mirror_V1.SLDASM, ASM_Bearing_Block_Needle_V1.SLDASM, ASM_Bearing_Block_V1.SLDASM]
2024-06-27 Changed to MGN12 Cross Rails
    - Changed from MGN9H to MGN12C carriages/rails
    - Changed XY beams to be up/up orientation
    - Reduced the height of tensioners
    - Added temp printhead
    [ASM_Bearing_Block_Drive_Mirror_V1.SLDASM, ASM_Bearing_Block_Drive_V1.SLDASM, ASM_Bearing_Block_Mirror_V1.SLDASM, ASM_Bearing_Block_Needle_Mirror_V1.SLDASM, ASM_Bearing_Block_Needle_V1.SLDASM, ASM_Bearing_Block_V1.SLDASM, ASM_Bed_V1.SLDASM, ASM_HGR15_Screws_V1.SLDASM]
2024-06-27 Added Filament Runout Sensor
    [ASM_Bearing_Block_Drive_Mirror_V1.SLDASM, ASM_Bearing_Block_Drive_V1.SLDASM, ASM_Bearing_Block_Mirror_V1.SLDASM, ASM_Bearing_Block_Needle_Mirror_V1.SLDASM, ASM_Bearing_Block_Needle_V1.SLDASM, ASM_Bearing_Block_V1.SLDASM, ASM_Filament_Sensor_V1.SLDASM, ASM_Gantry_V4.SLDASM]
2024-06-28 Started Printhead
    [ASM_Bearing_Block_Drive_Mirror_V1.SLDASM, ASM_Bearing_Block_Drive_V1.SLDASM, ASM_Bearing_Block_Mirror_V1.SLDASM, ASM_Bearing_Block_Needle_Mirror_V1.SLDASM, ASM_Bearing_Block_Needle_V1.SLDASM, ASM_Bearing_Block_V1.SLDASM, ASM_Bed_V1.SLDASM, ASM_Filament_Sensor_V1.SLDASM]
2024-06-28 Updated Chube CAD
    [ASM_temp_printhead_V2.SLDASM, PRT_Chube_Integration.SLDPRT, PRT_Chube_Integration_V2.SLDPRT, PRT_MA_LDO_20mm_Nema14.SLDPRT, PRT_Main_Plate_DK_V1.SLDPRT, PRT_Main_Plate_V1.SLDPRT, PRT_Main_Plate_V2.SLDPRT, PRT_Temp_Printhead_Plate_V1.SLDPRT]
2024-06-30 Added Temp Ducts
    [ASM_Bearing_Block_Needle_Mirror_V1.SLDASM, ASM_Bearing_Block_Needle_V1.SLDASM, ASM_Filament_Sensor_V1.SLDASM, ASM_MGN12_and_Screws_V1.SLDASM, ASM_Motor_Mount_and_Screws_V1.SLDASM, ASM_PG11_Mount_V1.SLDASM, ASM_XY_Transmission_V2.SLDASM, ASM_X_Beam_V2.SLDASM]
2024-07-01 Updated to SolidWorks 2023
    [ASM_Bearing_Block_Drive_Mirror_V1.SLDASM, ASM_Bearing_Block_Drive_V1.SLDASM, ASM_Bearing_Block_Mirror_V1.SLDASM, ASM_Bearing_Block_Needle_Mirror_V1.SLDASM, ASM_Bearing_Block_Needle_V1.SLDASM, ASM_Bearing_Block_V1.SLDASM, ASM_Bed_V1.SLDASM, ASM_Filament_Sensor_V1.SLDASM]
2024-07-01 Modified Ducts
    [ASM_Bearing_Block_Drive_Mirror_V1.SLDASM, ASM_Bearing_Block_Drive_V1.SLDASM, ASM_Bearing_Block_Mirror_V1.SLDASM, ASM_Bearing_Block_Needle_Mirror_V1.SLDASM, ASM_Bearing_Block_Needle_V1.SLDASM, ASM_Bearing_Block_V1.SLDASM, ASM_Motor_Mount_and_Screws_V1.SLDASM, ASM_Worm_Bearing_Block_Mirror_V1.SLDASM]
2024-07-03 More Duct Work
    [ASM_Bearing_Block_Drive_Mirror_V1.SLDASM, ASM_Bearing_Block_Drive_V1.SLDASM, ASM_Bearing_Block_Mirror_V1.SLDASM, ASM_Bearing_Block_Needle_Mirror_V1.SLDASM, ASM_Bearing_Block_Needle_V1.SLDASM, ASM_Bearing_Block_V1.SLDASM, ASM_Bed_V1.SLDASM, ASM_Filament_Sensor_V1.SLDASM]
2024-07-05 Finished ASM_Printhead_V4
    [ASM_Bearing_Block_Needle_Mirror_V1.SLDASM, ASM_Bearing_Block_Needle_V1.SLDASM, ASM_Filament_Sensor_V1.SLDASM, ASM_MGN12_and_Screws_V1.SLDASM, ASM_Motor_Mount_and_Screws_V1.SLDASM, ASM_PG11_Mount_V1.SLDASM, ASM_XY_Transmission_V2.SLDASM, ASM_X_Beam_V2.SLDASM]
2024-07-07 Added PRT_Key_Fob_V1
    [PRT_Key_Fob_V1.SLDPRT]
2024-07-08 Added ASM_Electronics_Panel_V1
    [ASM_Bearing_Block_Drive_Mirror_V1.SLDASM, ASM_Bearing_Block_Drive_V1.SLDASM, ASM_Bearing_Block_Mirror_V1.SLDASM, ASM_Bearing_Block_Needle_Mirror_V1.SLDASM, ASM_Bearing_Block_Needle_V1.SLDASM, ASM_Bearing_Block_V1.SLDASM, ASM_Bed_V1.SLDASM, ASM_Electronics_Panel_V1.SLDASM]
2024-07-08 Added Placeholder for Electronics Box
    [ASM_Bearing_Block_Drive_V1.SLDASM, ASM_Bearing_Block_Needle_Mirror_V1.SLDASM, ASM_Bearing_Block_Needle_V1.SLDASM, ASM_Bearing_Block_V1.SLDASM, ASM_Bed_V1.SLDASM, ASM_Filament_Sensor_V1.SLDASM, ASM_HGR15_Screws_V1.SLDASM, ASM_Kinematic-2_V2.SLDASM]
2024-07-13 Shifted Gantry Height
    [ASM_Bearing_Block_Drive_Mirror_V1.SLDASM, ASM_Bearing_Block_Drive_V1.SLDASM, ASM_Bearing_Block_Mirror_V1.SLDASM, ASM_Bearing_Block_V1.SLDASM, ASM_Motor_Mount_and_Screws_V1.SLDASM, ASM_Worm_Bearing_Block_Mirror_V1.SLDASM, ASM_Worm_Bearing_Block_V1.SLDASM, ASM_XY_Transmission_V2.SLDASM]
2024-07-14 Overhauled Everything
    - Fixed screws losing data
    - Redid Z to allow space for PEI sheet to fit
    - Fixed linear rails to fit BOM specs
    - Added ASM_Panels_V1.sldasm
    [ASM_Bearing_Block_Drive_Mirror_V1.SLDASM, ASM_Bearing_Block_Drive_V1.SLDASM, ASM_Bearing_Block_Mirror_V1.SLDASM, ASM_Bearing_Block_Needle_Mirror_V1.SLDASM, ASM_Bearing_Block_Needle_V1.SLDASM, ASM_Bearing_Block_V1.SLDASM, ASM_Bed_V1.SLDASM, ASM_Filament_Sensor_V1.SLDASM]
2024-07-15 Modified PRT_Gantry_Main_Plate_V5 for Manufacturing
    [PRT_Gantry_Main_Plate_V5.SLDPRT]
2024-07-18 Preliminary XY Tensioner created
    [ASM_Bearing_Block_Drive_V1.SLDASM, ASM_Bearing_Block_Needle_Mirror_V1.SLDASM, ASM_Bearing_Block_Needle_V1.SLDASM, ASM_Bearing_Block_V1.SLDASM, ASM_Filament_Sensor_V1.SLDASM, ASM_MGN12_and_Screws_V1.SLDASM, ASM_Motor_Mount_and_Screws_V1.SLDASM, ASM_Motor_Slide_V1.SLDASM]
2024-07-19 Initial ASM_Printhead_V5 created
    [ASM_Bearing_Block_Needle_Mirror_V1.SLDASM, ASM_Bearing_Block_Needle_V1.SLDASM, ASM_Electronics_Panel_V1.SLDASM, ASM_Filament_Sensor_V1.SLDASM, ASM_MGN12_and_Screws_V1.SLDASM, ASM_Motor_Mount_and_Screws_V1.SLDASM, ASM_PG11_Mount_V1.SLDASM, ASM_XY_Transmission_V2.SLDASM]
2024-07-28 Created initial SLM Printhead
    [01 Button Head (table)_M03 X 010_1.SLDPRT, 01 Cap Head (table)_M03 X 12_1.SLDPRT, 01 Washer Flat (table)_M3_1.SLDPRT, 684-ZZ.step_1.SLDASM, 684-ZZ_1.SLDASM, Ball bearing - 684zz-2.step_1.SLDPRT, Ball bearing - 684zz-3.step_1.SLDPRT, Ball bearing - 684zz.step_1.SLDASM]
2024-07-29 Temporarily added printhead to Gantry_V5
    [ASM_Bearing_Block_Needle_Mirror_V1.SLDASM, ASM_Bearing_Block_Needle_V1.SLDASM, ASM_Filament_Sensor_V1.SLDASM, ASM_MGN12_and_Screws_V1.SLDASM, ASM_Motor_Mount_and_Screws_V1.SLDASM, ASM_PG11_Mount_V1.SLDASM, ASM_XY_Transmission_V2.SLDASM, ASM_X_Beam_V2.SLDASM]
2024-08-15 Gantry_Main_Plate_V6.dwg created
    [PRT_Gantry_Main_Plate_V6.SLDDRW, PRT_Gantry_Main_Plate_V6.SLDPRT]
2024-08-15 Finished PRT_Gantry_Main_Plate_V6 CAD
    Still need to revise dwg before getting parts machined
    [PRT_Gantry_Main_Plate_V6.SLDDRW, PRT_Gantry_Main_Plate_V6.SLDPRT]
2024-08-16 Finished Gantry_Main_Plate_V6.slddrw
    [PRT_Gantry_Main_Plate_V6.SLDDRW, PRT_Gantry_Main_Plate_V6.SLDPRT]
2024-08-22 Shortened Z and Modified Electronics Panel
    [ASM_Bearing_Block_Drive_Mirror_V1.SLDASM, ASM_Bearing_Block_Mirror_V1.SLDASM, ASM_Bearing_Block_Needle_Mirror_V1.SLDASM, ASM_Bearing_Block_Needle_V1.SLDASM, ASM_Bed_V1.SLDASM, ASM_HGR15_Screws_V1.SLDASM, ASM_Kinematic-1_V2.SLDASM, ASM_MGN12_and_Screws_V1.SLDASM]
2024-08-31 Initial Z Redesign
    [ASM_Bearing_Block_Drive_Mirror_V2.SLDASM, ASM_Bearing_Block_Mirror_V1.SLDASM, ASM_Bearing_Block_Needle_Mirror_V1.SLDASM, ASM_Bearing_Block_Needle_V1.SLDASM, ASM_Bed_V1.SLDASM, ASM_Caster_Foot_V1.SLDASM, ASM_HGR15_Screws_V1.SLDASM, ASM_Kinematic-1_V2.SLDASM]
2024-09-10 Bed + Z Redesign part 1
    [ASM_Bearing_Block_Mirror_V1.SLDASM, ASM_Bearing_Block_Needle_Mirror_V1.SLDASM, ASM_Bearing_Block_Needle_V1.SLDASM, ASM_Bed_V1.SLDASM, ASM_Bed_V2.SLDASM, ASM_Caster_Foot_V1.SLDASM, ASM_Double_Kinematic_V1.SLDASM, ASM_HGR15_Screws_V1.SLDASM]
2024-09-17 Bed + Z Redesign part 2
    [ASM_Bearing_Block_Drive_V2.SLDASM, ASM_Bearing_Block_V1.SLDASM, ASM_Double_Kinematic_V1.SLDASM, ASM_Kinematic_Carriage_Mirror_V3.SLDASM, ASM_Kinematic_Carriage_V2.SLDASM, ASM_Kinematic_Carriage_V3.SLDASM, ASM_Motor_Mount_and_Screws_V2.SLDASM, ASM_Panels_V2.SLDASM]
2024-09-23 Manufacturing Edits
    [ASM_Bearing_Block_Drive_Mirror_V2.SLDASM, ASM_Bearing_Block_Drive_V2.SLDASM, ASM_Bearing_Block_Mirror_V1.SLDASM, ASM_Bearing_Block_Needle_Mirror_V1.SLDASM, ASM_Bearing_Block_Needle_V1.SLDASM, ASM_Bearing_Block_V1.SLDASM, ASM_Bed_V2.SLDASM, ASM_Double_Kinematic_V1.SLDASM]
2024-09-25 CNC parts completed
    [ASM_Bearing_Block_Drive_Mirror_V2.SLDASM, ASM_Bearing_Block_Drive_V2.SLDASM, ASM_Bearing_Block_Mirror_V1.SLDASM, ASM_Bearing_Block_Needle_Mirror_V1.SLDASM, ASM_Bearing_Block_Needle_V1.SLDASM, ASM_Bearing_Block_Needle_V2.SLDASM, ASM_Bearing_Block_V1.SLDASM, ASM_Bed_V2.SLDASM]
2024-09-27 Lightweighted Parts for Manufacturing
    [ASM_Bearing_Block_Drive_V2.SLDASM, ASM_Bearing_Block_V1.SLDASM, ASM_Caster_Foot_V1.SLDASM, ASM_Double_Kinematic_V1.SLDASM, ASM_HGR15_Screws_V1.SLDASM, ASM_Kinematic_Carriage_Mirror_V3.SLDASM, ASM_Kinematic_Carriage_V3.SLDASM, ASM_Panels_V2.SLDASM]
2024-10-07 Electronics Panel Hole Template Created
    [ASM_Bearing_Block_Drive_V2.SLDASM, ASM_Bearing_Block_V1.SLDASM, ASM_Bed_V2.SLDASM, ASM_Caster_Foot_V1.SLDASM, ASM_Double_Kinematic_V1.SLDASM, ASM_HGR15_Screws_V1.SLDASM, ASM_Kinematic_Carriage_V3.SLDASM, ASM_Motor_Slide_V2.SLDASM]
2024-10-10 Updated Electronics
    [ASM_Mellow_D5_DIN_V1.SLDASM, ASM_Raspi_DIN_V1.SLDASM, ASM_Raspi_DIN_V2.SLDASM, ASM_Supernova_DIN_V1.SLDASM, ASM_Supernova_DIN_V2.SLDASM, PRT_DIN_Rail_Clip_V2.SLDPRT, PRT_DIN_Rail_Spacer_V1.SLDPRT, PRT_MIC6_Bed_300_V2.SLDDRW]
2024-10-10 Created Bed Drawings
    [ASM_Bed_V2.SLDASM, ASM_Double_Kinematic_V1.SLDASM, PRT_MIC6_Bed_300_V2.SLDDRW, PRT_MIC6_Bed_300_V2.SLDPRT]
2024-10-11 Created DXFs for Waterjet
    [ASM_Bed_V2.SLDASM, ASM_Double_Kinematic_V1.SLDASM, ASM_Raspi_DIN_V2.SLDASM, DRW_Gantry_Main_Plate_V5.SLDDRW, DXF_1x_Heater_Clamp_V1.DXF, DXF_1x_Mellow_D5_Plate_V1.DXF, DXF_1x_Raspi_Plate_V2.DXF, DXF_1x_Small_Power_Supply_Bracket_V1.DXF]
2024-11-04 MoXtruder Initial Mockup
    [ASM_Bearing_Block_Drive_Mirror_V2.SLDASM, ASM_Bearing_Block_Mirror_V1.SLDASM, ASM_Bearing_Block_Needle_V2.SLDASM, ASM_Bed_V2.SLDASM, ASM_Caster_Foot_V1.SLDASM, ASM_Double_Kinematic_V1.SLDASM, ASM_HGR15_Screws_V1.SLDASM, ASM_K1_Shaft_V1.SLDASM]
2024-11-14 Updated Electronics Box and Started MoXtruder V2
    [ASM_AC_Panel_V1.SLDASM, ASM_K1_Shaft_V1.SLDASM, ASM_K1_Shaft_V2.SLDASM, ASM_Stepper_Connector_Mount_V1.SLDASM, DXF_Motor_Mount_V3.DXF, DXF_Static_Toothed_Clamp_V1.DXF, DXF_XY_Block_Skeletonized_V2.DXF, DXF_XY_Block_V2.DXF]
2024-11-14 Included DXF files for waterjet job
    [DXF_Kinematic_Clamp_V1.DXF, DXF_Kinematic_Spring_Steel_V1.DXF, DXF_Tensioner_Spacer_V1.DXF, DXF_XY_Backer_V4.DXF, DXF_Z_Belt_Cover_V1.DXF, DXF_Z_Stepper_Plate_Mount_V3.DXF]
2024-11-19 Modified MoXtruder V2
    [ASM_K1_Shaft_V2.SLDASM, PRT_5x10_Shaft_V1.SLDPRT, PRT_Extruder_Body_V2.SLDPRT, PRT_Extruder_Bottom_V2.SLDPRT, PRT_MR85ZZ_Bearing_V1.SLDPRT, PRT_Moons_CSE14HRA2L4100_V1.SLDPRT]
2024-11-27 Updated MoXtruder V2
    [PRT_Extruder_Body_V2.SLDPRT, PRT_Extruder_Bottom_V3.SLDPRT, PRT_Moons_CSE14HRA2L4100_V1.SLDPRT, PRT_V6_Nozzle_V1.SLDPRT]
2024-12-02 Waterjet + Updated CAD
    [ASM_AC_Panel_V1.SLDASM, ASM_Bearing_Block_Drive_V2.SLDASM, ASM_Bearing_Block_V1.SLDASM, ASM_Bed_V2.SLDASM, ASM_Caster_Foot_V1.SLDASM, ASM_Double_Kinematic_V1.SLDASM, ASM_HGR15_Screws_V1.SLDASM, ASM_Kinematic_Carriage_V3.SLDASM]
2024-12-06 Updated tolerances on waterjet parts
    [ASM_Kinematic_Carriage_Mirror_V3.SLDASM, DXF_Motor_Mount_V3.DXF, DXF_Static_Toothed_Clamp_V2.DXF, DXF_XY_Block_V2.DXF, DXF_Z_Tensioner_V2.DXF, DXF_keyhole_V1.DXF, PRT_Back_Wiring_Panel_V1.SLDPRT, PRT_Static_Toothed_Clamp_V1.SLDPRT]
2025-01-20 Finished Ducts V1
    [PRT_Duct_Top_V1.SLDPRT, PRT_Ducts_V1.SLDPRT, PRT_Extruder_Body_V2.SLDPRT, PRT_Extruder_Bottom_V3.SLDPRT]
2025-02-01 Updated Gantry
    [ASM_XY_Transmission_V2.SLDASM, ASM_X_Beam_V3.SLDASM, ASM_Y_Beam_V3.SLDASM, PRT_Ducts_V1.SLDPRT, PRT_Extruder_Body_V2.SLDPRT, PRT_XY_Block_Spacer_V2.SLDPRT, PRT_XY_Block_V2.SLDPRT, PRT_XY_Spacer_V1.SLDPRT]
